LucasJadilo/ez8-hardware/docs/EZ8_Architecture.ods

Sheet: Instruction Set
Instruction Set
Data Transfer
Opcode | Mnemonic | Operand | Cycles | Description | Algorithm (C syntax)
0x00 | LDA | Memory address | 12 | Load accumulator from memory | A = *OP;
0x01 | LDI | Immediate data | 8 | Load accumulator from immediate | A = OP;
0x02 | STA | Memory address | 12 | Store accumulator to memory | *OP = A;
0x03 | LIA | None | 9 | Load indirect access | A = *A;
Logic
Opcode | Mnemonic | Operand | Cycles | Description | Algorithm (C syntax)
0x04 | NOT | None | 5 | Bitwise NOT | A = ~A;
0x05 | AND | Memory address | 13 | Bitwise AND | A = A & *OP;
0x06 | OR | Memory address | 13 | Bitwise OR | A = A | *OP;
0x07 | XOR | Memory address | 13 | Bitwise XOR | A = A ^ *OP;
0x08 | SHL | None | 5 | Logic left shift | A = A << 1;
0x09 | SHR | None | 5 | Logic right shift | A = A >> 1;
Arithmetic
Opcode | Mnemonic | Operand | Cycles | Description | Algorithm (C syntax)
0x0A | ADD | Memory address | 13 | Add memory to accumulator | A = A + *OP;
0x0B | SUB | Memory address | 13 | Subtract memory from accumulator | A = A - *OP;
0x0C | CMP | Memory address | 13 | Compare accumulator and memory | EQUAL = (A == *OP) ? 1 : 0;
 |  |  |  |  | COUT = (A <= *OP) ? 1 : 0;
Jump
Opcode | Mnemonic | Operand | Cycles | Description | Algorithm (C syntax)
0x0D | JMP | Memory address | 8 | Unconditional jump | PC = OP;
0x0E | JPE | Memory address | 8 (5) | Jump if accumulator is equal memory | PC = (EQUAL == 1) ? OP : PC;
0x0F | JPA | Memory address | 8 (5) | Jump if accumulator is above memory | PC = (EQUAL == 0 && COUT == 0) ? OP : PC;
0x10 | JPB | Memory address | 8 (5) | Jump if accumulator is below memory | PC = (EQUAL == 0 && COUT == 1) ? OP : PC;
0x11 | CALL | Memory address | 13 | Jump to subroutine | *SP = PC; SP--; PC = OP;
0x12 | RET | None | 9 | Return from subroutine | SP++; PC = *SP;
Stack
Opcode | Mnemonic | Operand | Cycles | Description | Algorithm (C syntax)
0x13 | LSP | None | 5 | Load stack pointer from accumulator | SP = A;
0x14 | PUSH | None | 8 | Push accumulator to stack | *SP = A; SP--;
0x15 | POP | None | 9 | Pop stack to accumulator | SP++; A = *SP;
I/O
Opcode | Mnemonic | Operand | Cycles | Description | Algorithm (C syntax)
0x16 | IN | I/O address | 12 | Read I/O data | A = *OP; /* (M/IO = 0) */
0x17 | OUT | I/O address | 12 | Write I/O data | *OP = A; /* (M/IO = 0) */
Idle
Opcode | Mnemonic | Operand | Cycles | Description | Algorithm (C syntax)
0x18 | NOP | None | 4 | No operation | ;
0x19 | HALT | None | 4 (∞) | Halt CPU | while(1);

Sheet: Bill of Materials
Bill of Materials
ACC | B | ALU | IR | PC | DAR | SP | BIU | CU | Total | Components
2 | 2 | 1 | 2 | - | 2 | - | 4 | - | 13 | IC 74LS173: 4-bit register with tristate outputs
1 | - | 2 | - | 2 | - | 1 | 1 | - | 7 | IC 74LS245: 8-bit bus transceiver with tristate outputs
- | - | 2 | - | - | - | - | - | - | 2 | IC 74LS181: 4-bit arithmetic logic unit
- | - | - | - | 2 | - | - | - | 1 | 3 | IC 74LS161: synchronous 4-bit binary counter
- | - | - | - | - | - | 2 | - | - | 2 | IC 74LS169: synchronous 4-bit up/down binary counter
- | - | - | - | - | - | - | - | 1 | 1 | IC 74LS04: hex inverting logic gates
- | - | - | - | - | - | - | - | 4 | 4 | IC 2732: 4KB EPROM
- | - | 1 | - | - | - | - | - | - | 1 | Resistor 10 kΩ

Sheet: ALU
ALU Inputs |  |  |  |  |  |  |  |  |  | ALU Outputs
Operation | Description | Inputs |  |  |  |  |  |  |  | Comparison | Outputs
(C syntax) |  | MODE | CIN | S3 | S2 | S1 | S0 | SHR | OE | Result | ALU_COUT | ALU_EQUAL
~A | Bitwise complement | 1 | X | 0 | 0 | 0 | 0 | 1 | 0 | A > B | 0 | 0
A & B | Bitwise logic AND | 1 | X | 1 | 0 | 1 | 1 | 1 | 0 | A = B | 1 | 1
A | B | Bitwise logic OR | 1 | X | 1 | 1 | 1 | 0 | 1 | 0 | A < B | 1 | 0
A ^ B | Bitwise logic XOR | 1 | X | 0 | 1 | 1 | 0 | 1 | 0
A + B | Arithmetic addition | 0 | 1 | 1 | 0 | 0 | 1 | 1 | 0
A - B | Arithmetic subtraction | 0 | 0 | 0 | 1 | 1 | 0 | 1 | 0
A << 1 | Left logic bit shift | 0 | 1 | 1 | 1 | 0 | 0 | 1 | 0
A >> 1 | Right logic bit shift | X | X | X | X | X | X | 0 | 1
A - B - 1 | Compare operands | 0 | 1 | 0 | 1 | 1 | 0 | 1 | 0

Sheet: Control Inputs
Control Inputs
Bit Index | Signal | Active Level | Description
Arithmetic Logic Unit
0 | COUT | L | ALU’s carry output (COUT output)
1 | EQUAL | H | ALU’s equal operands (EQUAL output)
Control Unit
2-5 | IC[0..3] | - | CU’s instruction counter
Instruction Register
6-10 | IR[0..4] | - | IR’s data (IREG[0..4] output)

Sheet: Control Outputs
Control Outputs
Bit Index | Signal | Active Level | Description
Accumulator
0 | AI | L | Accumulator’s data input enable (IE input)
1 | AO | L | Accumulator’s data output enable (OE input)
B Register
2 | BI | L | B Register’s data input enable (IE input)
Arithmetic Logic Unit
3 | RO | L | ALU’s result output enable (OE input)
4 | SHR | L | ALU’s right logic shift output enable (SHR input)
5 | S0 | H | ALU’s operation selection 0 (S0 input)
6 | S1 | H | ALU’s operation selection 1 (S1 input)
7 | S2 | H | ALU’s operation selection 2 (S2 input)
8 | S3 | H | ALU’s operation selection 3 (S3 input)
9 | CIN | L | ALU’s carry input (CIN input)
10 | MODE | H | ALU’s operation mode (MODE input)
Instruction Register
11 | IRI | L | IR’s data input enable (IE input)
Program Counter
12 | PCI | L | PC’s data input enable (IE input)
13 | PCDO | L | PC’s data output enable (DOE input)
14 | PCAO | L | PC’s address output enable (AOE input)
15 | PCCE | H | PC’s count enable (CE input)
Stack Pointer
16 | SPI | L | SP’s data input enable (IE input)
17 | SPO | L | SP’s data output enable (OE input)
18 | SPCE | L | SP’s count enable (CE input)
19 | SPU/SPD | H | SP’s counter direction (UP/DOWN input)
Data Address Register
20 | DARI | L | DAR’s data input enable (IE input)
21 | DARO | L | DAR’s address output enable (OE input)
Bus Interface Unit
22 | DI/DO | H | BIU’s data pins direction (DI/DO input)
23 | DEN | L | BIU’s data pins enable (DEN input)
24 | ACO | L | BIU’s address and control pins output enable (ACO input)
25 | ALE | L | BIU’s address pins latch enable (ALE input)
26 | M/IO | L | BIU’s memory/IO operation pin (M/IO_BUS input)
27 | RD | L | BIU’s read operation pin (RD_BUS input)
28 | WR | L | BIU’s write operation pin (WR_BUS input)
Control Unit
29 | ILC | L | CU’s instruction last cycle (ILC signal)

Sheet: Control Logic
Control Logic
Inputs |  |  |  | Active Outputs
IR[0..4] | IC[0..3] | EQUAL | COUT
Reset
X | 0 | X | X
Read Cycle
X | n | X | X | [M/IO], ACO, ALE, PCAO|DARO|SPO
X | n+1 | X | X | [M/IO], ACO, DEN, RD
X | n+2 | X | X | [M/IO], ACO, DEN, RD, AI|BI|IRI|DARI|PCI|SPI
X | n+3 | X | X | [M/IO], ACO, [PCCE], [ILC]
Write Cycle
X | n | X | X | [M/IO], ACO, DI/DO, ALE, PCAO|DARO|SPO
X | n+1 | X | X | [M/IO], ACO, DI/DO, DEN, WR, PCDO|AO
X | n+2 | X | X | [M/IO], ACO, DI/DO, DEN, PCDO|AO
X | n+3 | X | X | [M/IO], ACO, [SPCE], [SPU/SPD], [ILC]
Opcode Fetch
X | 1..4 | X | X | Read(PCAO, IRI, PCCE)
Execution LDA
0x00 | 5..8 | X | X | Read(PCAO, DARI, PCCE)
0x00 | 9..12 | X | X | Read(DARO, AI, ILC)
Execution LDI
0x01 | 5..8 | X | X | Read(PCAO, AI, PCCE, ILC)
Execution STA
0x02 | 5..8 | X | X | Read(PCAO, DARI, PCCE)
0x02 | 9..12 | X | X | Write(DARO, AO, ILC)
Execution LIA
0x03 | 5 | X | X | ACO, AO, DARI
0x03 | 6..9 | X | X | Read(DARO, AI, ILC)
Execution NOT
0x04 | 5 | X | X | ACO, MODE, RO, AI, ILC
Execution AND
0x05 | 5..8 | X | X | Read(PCAO, DARI, PCCE)
0x05 | 9..12 | X | X | Read(DARO, BI)
0x05 | 13 | X | X | ACO, MODE, S3, S1, S0, RO, AI, ILC
Execution OR
0x06 | 5..8 | X | X | Read(PCAO, DARI, PCCE)
0x06 | 9..12 | X | X | Read(DARO, BI)
0x06 | 13 | X | X | ACO, MODE, S3, S2, S1, RO, AI, ILC
Execution XOR
0x07 | 5..8 | X | X | Read(PCAO, DARI, PCCE)
0x07 | 9..12 | X | X | Read(DARO, BI)
0x07 | 13 | X | X | ACO, MODE, S2, S1, RO, AI, ILC
Execution SHL
0x08 | 5 | X | X | ACO, S3, S2, RO, AI, ILC
Execution SHR
0x09 | 5 | X | X | ACO, SHR, AI, ILC
Execution ADD
0x0A | 5..8 | X | X | Read(PCAO, DARI, PCCE)
0x0A | 9..12 | X | X | Read(DARO, BI)
0x0A | 13 | X | X | ACO, S3, S0, RO, AI, ILC
Execution SUB
0x0B | 5..8 | X | X | Read(PCAO, DARI, PCCE)
0x0B | 9..12 | X | X | Read(DARO, BI)
0x0B | 13 | X | X | ACO, CIN, S2, S1, RO, AI, ILC
Execution CMP
0x0C | 5..8 | X | X | Read(PCAO, DARI, PCCE)
0x0C | 9..12 | X | X | Read(DARO, BI)
0x0C | 13 | X | X | ACO, S2, S1, RO, ILC
Execution JMP
0x0D | 5..8 | X | X | Read(PCAO, PCI, ILC)
Execution JPE
0x0E | 5..8 | 1 | 1 | Read(PCAO, PCI, ILC)
0x0E | 5 | 0 | X | ACO, PCCE, ILC
0x0E | 5 | X | 0 | ACO, PCCE, ILC
Execution JPA
0x0F | 5..8 | 0 | 0 | Read(PCAO, PCI, ILC)
0x0F | 5 | 1 | X | ACO, PCCE, ILC
0x0F | 5 | X | 1 | ACO, PCCE, ILC
Execution JPB
0x10 | 5..8 | 0 | 1 | Read(PCAO, PCI, ILC)
0x10 | 5 | 1 | X | ACO, PCCE, ILC
0x10 | 5 | 0 | 0 | ACO, PCCE, ILC
Execution CALL
0x11 | 5 | X | X | ACO, PCDO, DARI, PCCE
0x11 | 6..9 | X | X | Write(SPO, PCDO, SPCE)
0x11 | 10..13 | X | X | Read(DARO, PCI, ILC)
Execution RET
0x12 | 5 | X | X | ACO, SPU/SPD, SPCE
0x12 | 6..9 | X | X | Read(SPO, PCI, ILC)
Execution LSP
0x13 | 5 | X | X | ACO, AO, SPI, ILC
Execution PUSH
0x14 | 5..8 | X | X | Write(SPO, AO, SPCE, ILC)
Execution POP
0x15 | 5 | X | X | ACO, SPU/SPD, SPCE
0x15 | 6..9 | X | X | Read(SPO, AI, ILC)
Execution IN
0x16 | 5..8 | X | X | Read(PCAO, DARI, PCCE)
0x16 | 9..12 | X | X | Read(M/IO, DARO, AI, ILC)
Execution OUT
0x17 | 5..8 | X | X | Read(PCAO, DARI, PCCE)
0x17 | 9..12 | X | X | Write(M/IO, DARO, AO, ILC)
Execution NOP
0x18 | 4 | X | X | ACO, PCCE, ILC
Execution HALT
0x19 | 1 | X | X | ACO, ILC
0x19 | 4 | X | X | ACO, ILC

Sheet: Control Truth Table
Control Truth Table
Inputs | Outputs | Mnemonic | IR | IC | EQUAL | COUT | ILC | WR | RD | M/IO | ALE | ACO | DEN | DI/DO | DARO | DARI | SPU/SPD | SPCE | SPO | SPI | PCCE | PCAO | PCDO | PCI | IRI | MODE | CIN | S3 | S2 | S1 | S0 | SHR | RO | BI | AO | AI
0x000 | 0x3FB77A1F | LDA | 0 | 0 | 0 | 0 | 1 | 1 | 1 | 1 | 1 | 1 | 1 | 0 | 1 | 1 | 0 | 1 | 1 | 1 | 0 | 1 | 1 | 1 | 1 | 0 | 1 | 0 | 0 | 0 | 0 | 1 | 1 | 1 | 1 | 1
0x001 | 0x3FB77A1F | LDA | 0 | 0 | 0 | 1 | 1 | 1 | 1 | 1 | 1 | 1 | 1 | 0 | 1 | 1 | 0 | 1 | 1 | 1 | 0 | 1 | 1 | 1 | 1 | 0 | 1 | 0 | 0 | 0 | 0 | 1 | 1 | 1 | 1 | 1
0x002 | 0x3FB77A1F | LDA | 0 | 0 | 1 | 0 | 1 | 1 | 1 | 1 | 1 | 1 | 1 | 0 | 1 | 1 | 0 | 1 | 1 | 1 | 0 | 1 | 1 | 1 | 1 | 0 | 1 | 0 | 0 | 0 | 0 | 1 | 1 | 1 | 1 | 1
0x003 | 0x3FB77A1F | LDA | 0 | 0 | 1 | 1 | 1 | 1 | 1 | 1 | 1 | 1 | 1 | 0 | 1 | 1 | 0 | 1 | 1 | 1 | 0 | 1 | 1 | 1 | 1 | 0 | 1 | 0 | 0 | 0 | 0 | 1 | 1 | 1 | 1 | 1
0x004 | 0x3CB73A1F | LDA | 0 | 1 | 0 | 0 | 1 | 1 | 1 | 1 | 0* | 0* | 1 | 0 | 1 | 1 | 0 | 1 | 1 | 1 | 0 | 0* | 1 | 1 | 1 | 0 | 1 | 0 | 0 | 0 | 0 | 1 | 1 | 1 | 1 | 1
0x005 | 0x3CB73A1F | LDA | 0 | 1 | 0 | 1 | 1 | 1 | 1 | 1 | 0* | 0* | 1 | 0 | 1 | 1 | 0 | 1 | 1 | 1 | 0 | 0* | 1 | 1 | 1 | 0 | 1 | 0 | 0 | 0 | 0 | 1 | 1 | 1 | 1 | 1
0x006 | 0x3CB73A1F | LDA | 0 | 1 | 1 | 0 | 1 | 1 | 1 | 1 | 0* | 0* | 1 | 0 | 1 | 1 | 0 | 1 | 1 | 1 | 0 | 0* | 1 | 1 | 1 | 0 | 1 | 0 | 0 | 0 | 0 | 1 | 1 | 1 | 1 | 1
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
0x2A2 | 0x3EB7FA1F | ADD | 10 | 8 | 1 | 0 | 1 | 1 | 1 | 1 | 1 | 0* | 1 | 0 | 1 | 1 | 0 | 1 | 1 | 1 | 1* | 1 | 1 | 1 | 1 | 0 | 1 | 0 | 0 | 0 | 0 | 1 | 1 | 1 | 1 | 1
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
