LucasJadilo/ez8-hardware/docs/EZ8_Instruction_Register.pdf

# ROOT

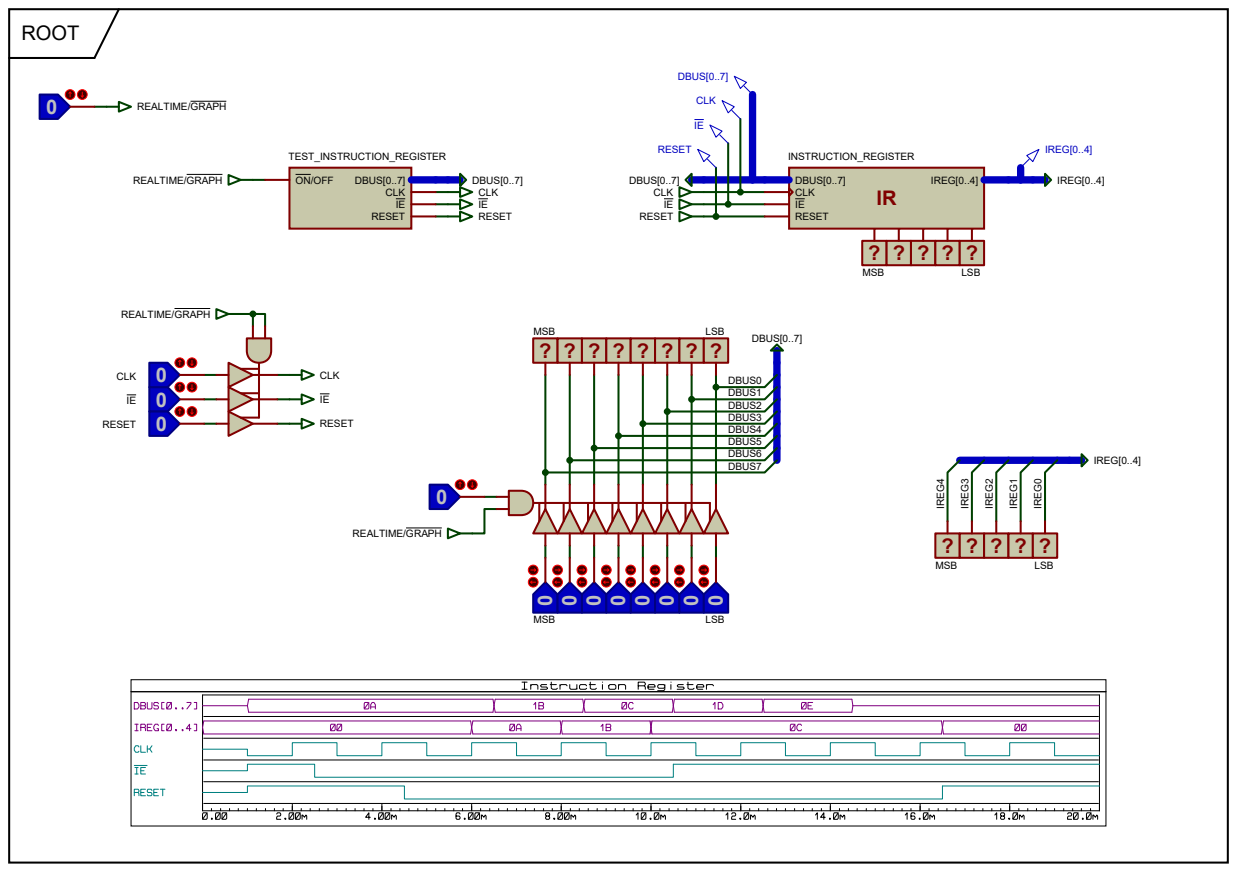
[picture p1: page 1]
DBUS7; DBUS6; DBUS5; DBUS4; DBUS3; DBUS2; DBUS1; DBUS0; IREG⁴; IREG³; IREG²; IREG¹; IREG⁰; CLK; REALTIME/GRAPH; 0 REALTIME/GRAPH; DBUS[0..7]; IREG[0..4]; MSB 0; LSB 0; MSB; LSB; RESET; ON/OFF; TEST_INSTRUCTION_REGISTER; IE RESET; INSTRUCTION_REGISTER

# INSTRUCTION_REGISTER

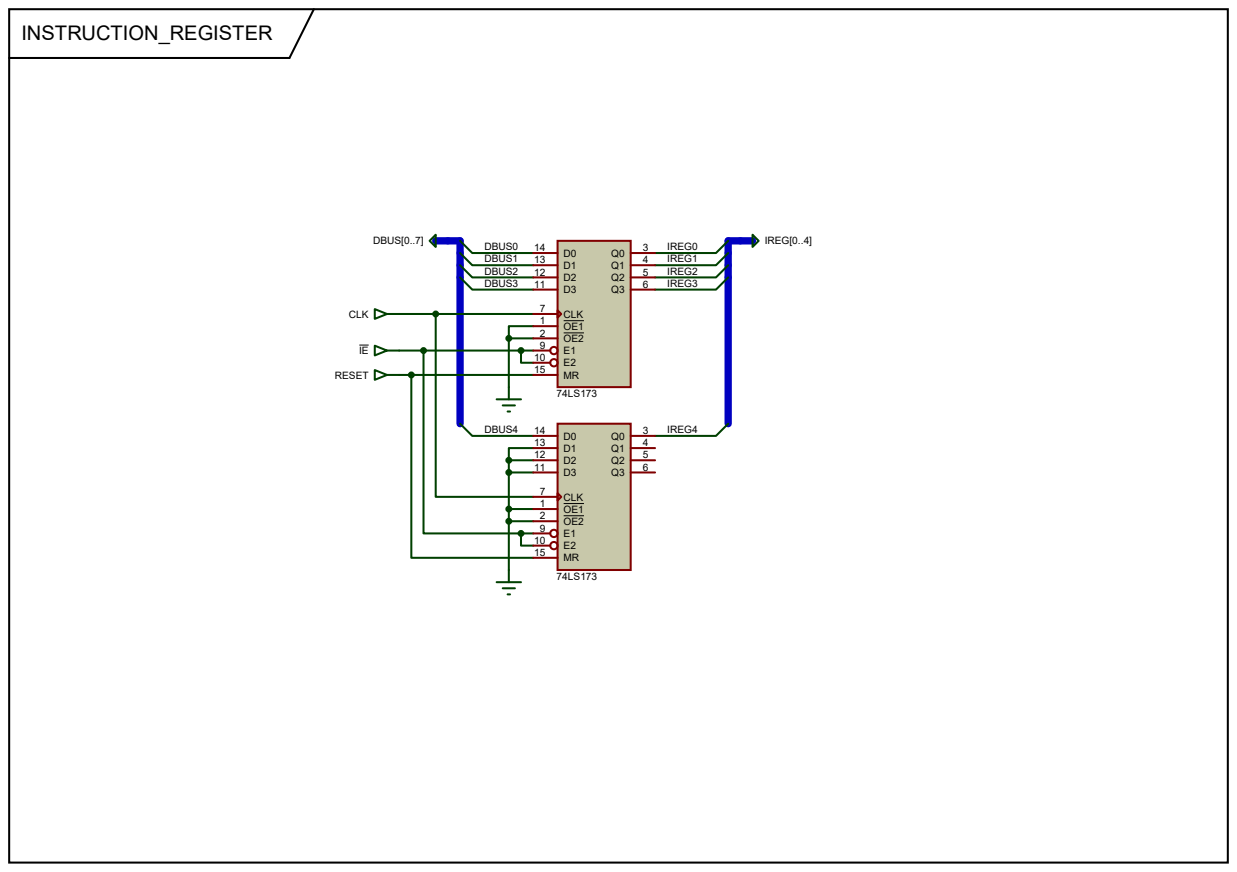
[picture p2: page 2]

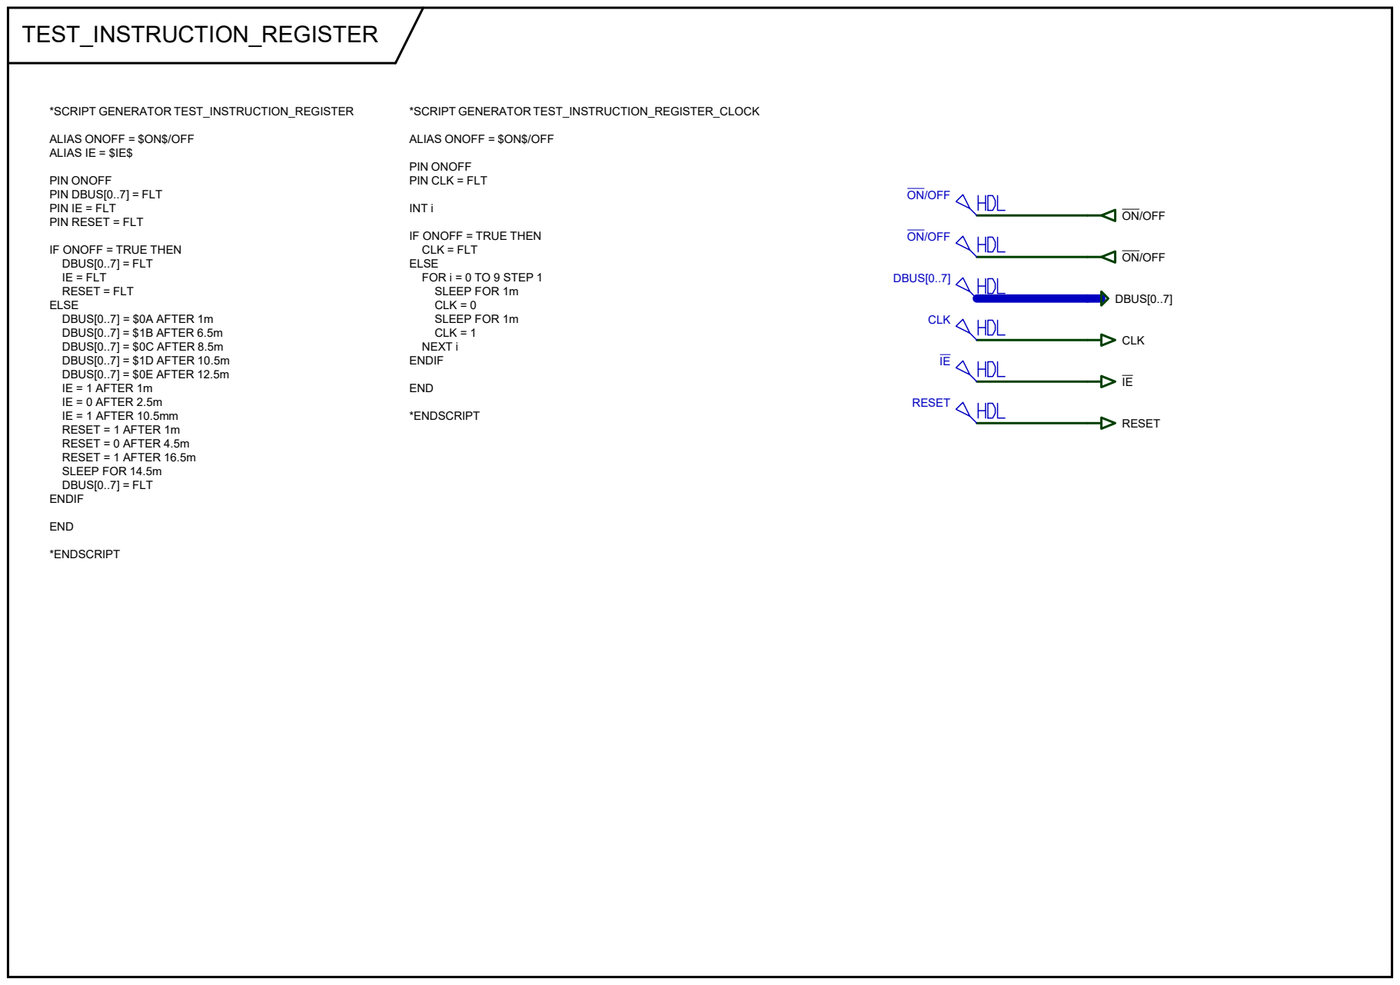
[picture p3: figure]
*SCRIPT GENERATOR TEST_INSTRUCTION_REGISTER; ALIAS ONOFF = $ON$/OFF ALIAS IE = $IE$; PIN ONOFF PIN DBUS[0..7] = FLT PIN IE = FLT PIN RESET = FLT; IF ONOFF = TRUE THEN DBUS[0..7] = FLT IE = FLT RESET = FLT ELSE DBUS[0..7] = $0A AFTER 1m DBUS[0..7] = $1B AFTER 6.5m DBUS[0..7] = $0C AFTER 8.5m DBUS[0..7] = $1D AFTER 10.5m DBUS[0..7] = $0E AFTER 12.5m IE = 1 AFTER 1m IE = 0 AFTER 2.5m IE = 1 AFTER 10.5mm RESET = 1 AFTER 1m RESET = 0 AFTER 4.5m RESET = 1 AFTER 16.5m SLEEP FOR 14.5m DBUS[0..7] = FLT ENDIF; END; *ENDSCRIPT; DBUS[0..7]; TEST_INSTRUCTION_REGISTER; CLK; RESET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
