LucasJadilo/ez8-hardware/docs/EZ8_Accumulator.pdf

# ROOT

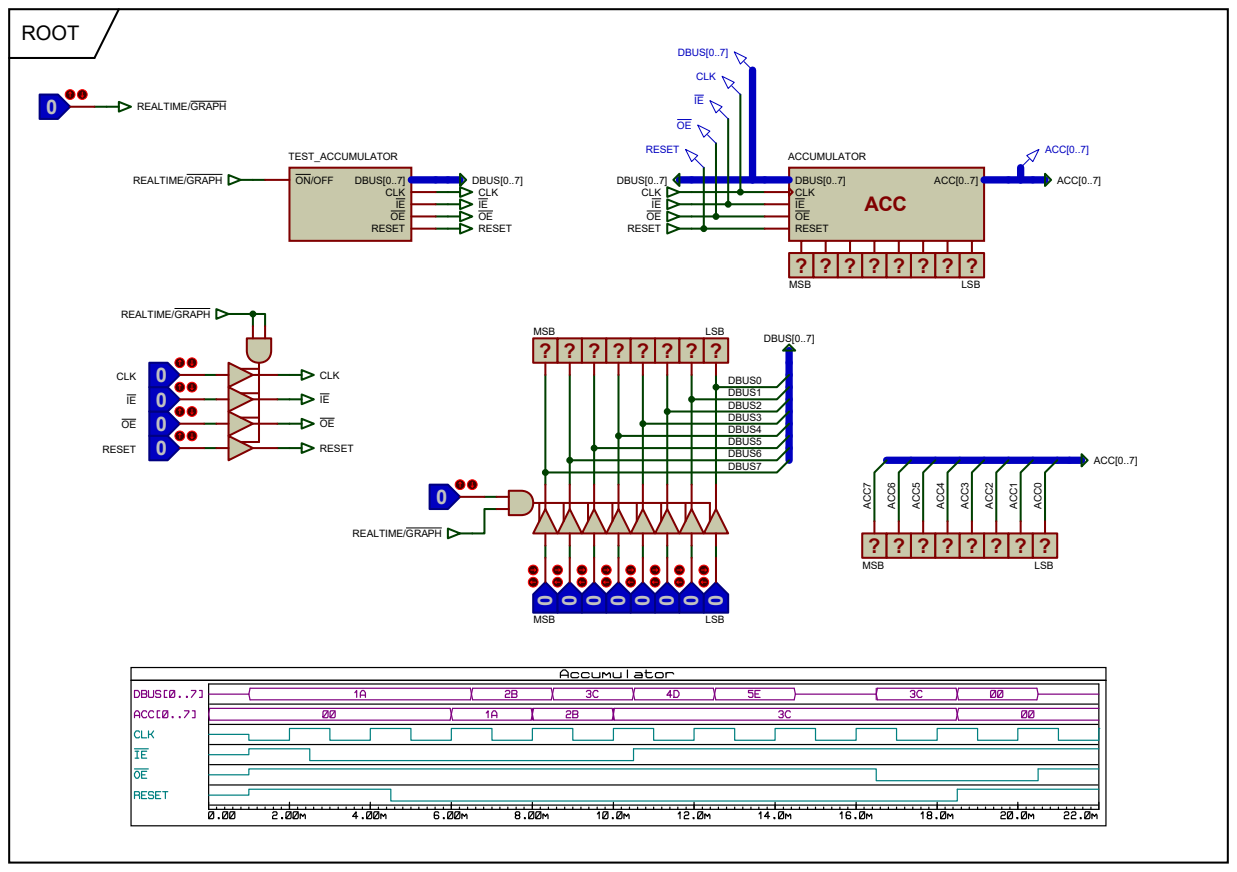
[picture p4: page 1]
DBUS7; DBUS6; DBUS5; DBUS4; DBUS3; DBUS2; DBUS1; DBUS0; ACC⁷; ACC⁶; ACC⁵; ACC⁴; ACC³; ACC²; ACC¹; ACC⁰; CLK; REALTIME/GRAPH; 0 REALTIME/GRAPH; DBUS[0..7]; ACC[0..7]; MSB 0; LSB 0; MSB; LSB; RESET; ACC; ACCUMULATOR; ON/OFF; TEST_ACCUMULATOR

# ACCUMULATOR

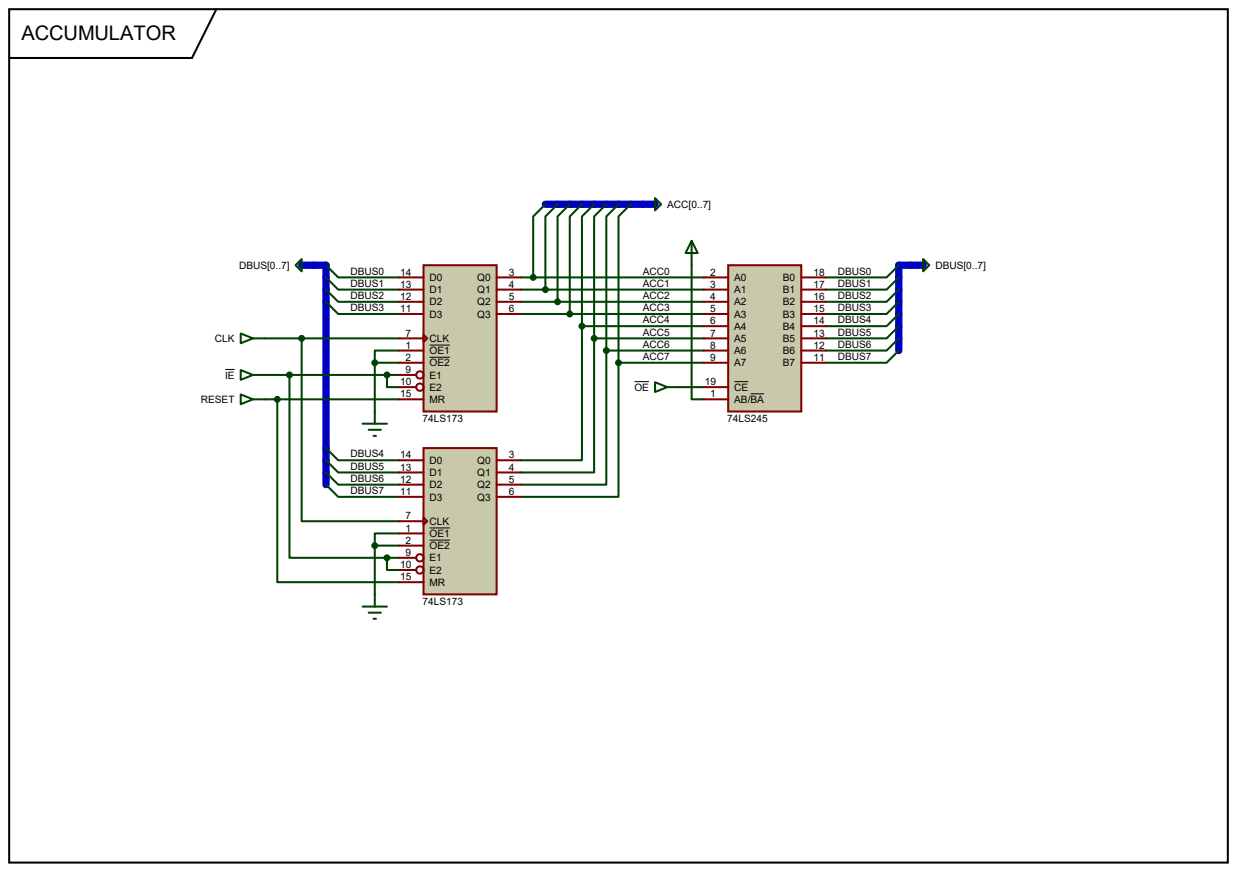
[picture p5: page 2]

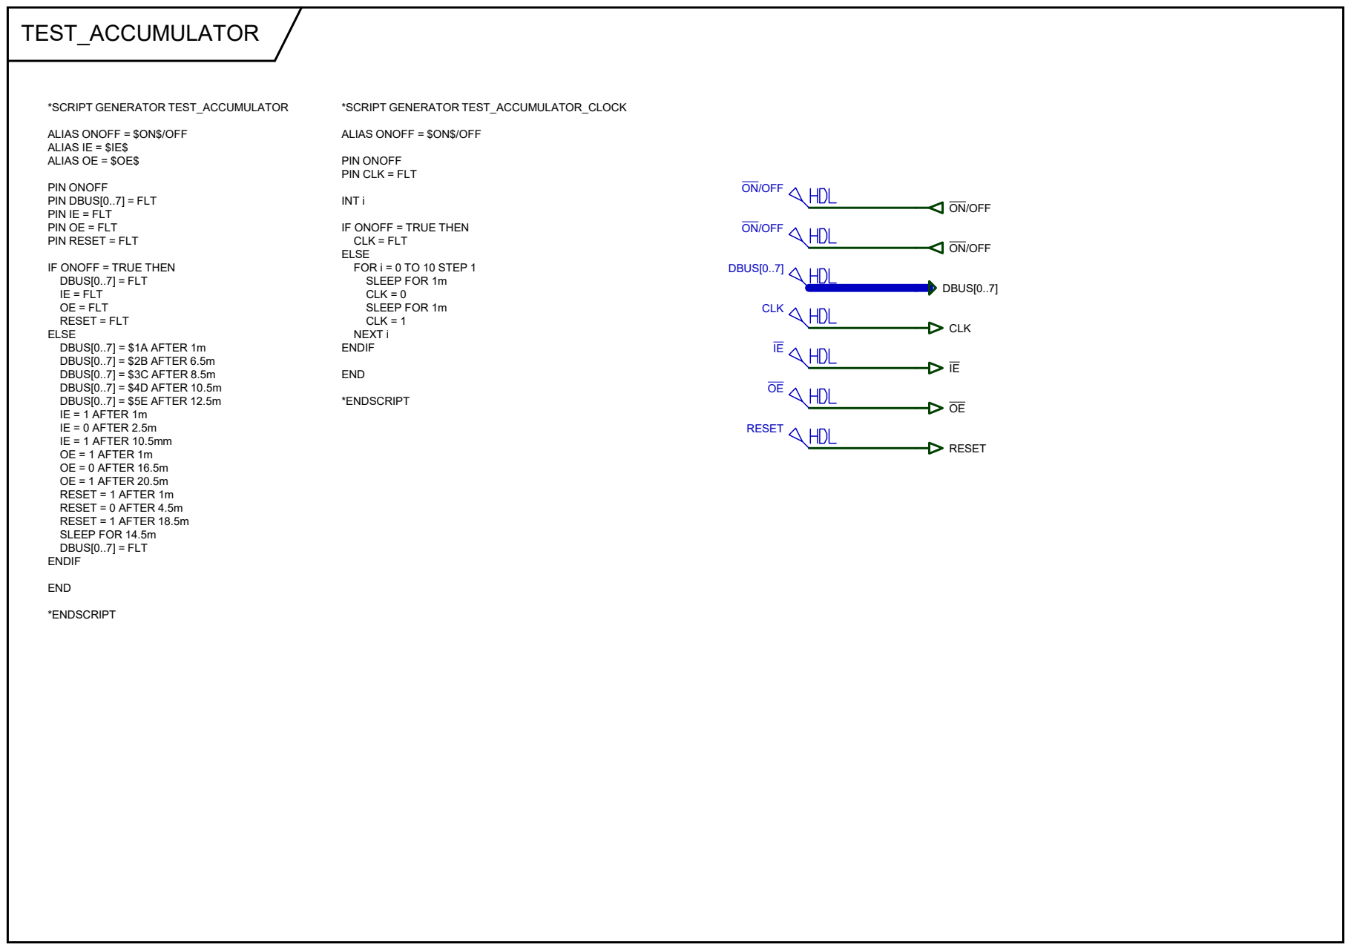
[picture p6: figure]
*SCRIPT GENERATOR TEST_ACCUMULATOR; ALIAS ONOFF = $ON$/OFF ALIAS IE = $IE$ ALIAS OE = $OE$; PIN ONOFF PIN DBUS[0..7] = FLT PIN IE = FLT PIN OE = FLT PIN RESET = FLT; IF ONOFF = TRUE THEN DBUS[0..7] = FLT IE = FLT OE = FLT RESET = FLT ELSE DBUS[0..7] = $1A AFTER 1m DBUS[0..7] = $2B AFTER 6.5m DBUS[0..7] = $3C AFTER 8.5m DBUS[0..7] = $4D AFTER 10.5m DBUS[0..7] = $5E AFTER 12.5m IE = 1 AFTER 1m IE = 0 AFTER 2.5m IE = 1 AFTER 10.5mm OE = 1 AFTER 1m OE = 0 AFTER 16.5m OE = 1 AFTER 20.5m RESET = 1 AFTER 1m RESET = 0 AFTER 4.5m RESET = 1 AFTER 18.5m SLEEP FOR 14.5m DBUS[0..7] = FLT ENDIF; END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
