LucasJadilo/ez8-hardware/docs/EZ8_Arithmetic_Logic_Unit.pdf

# ROOT

# ALU

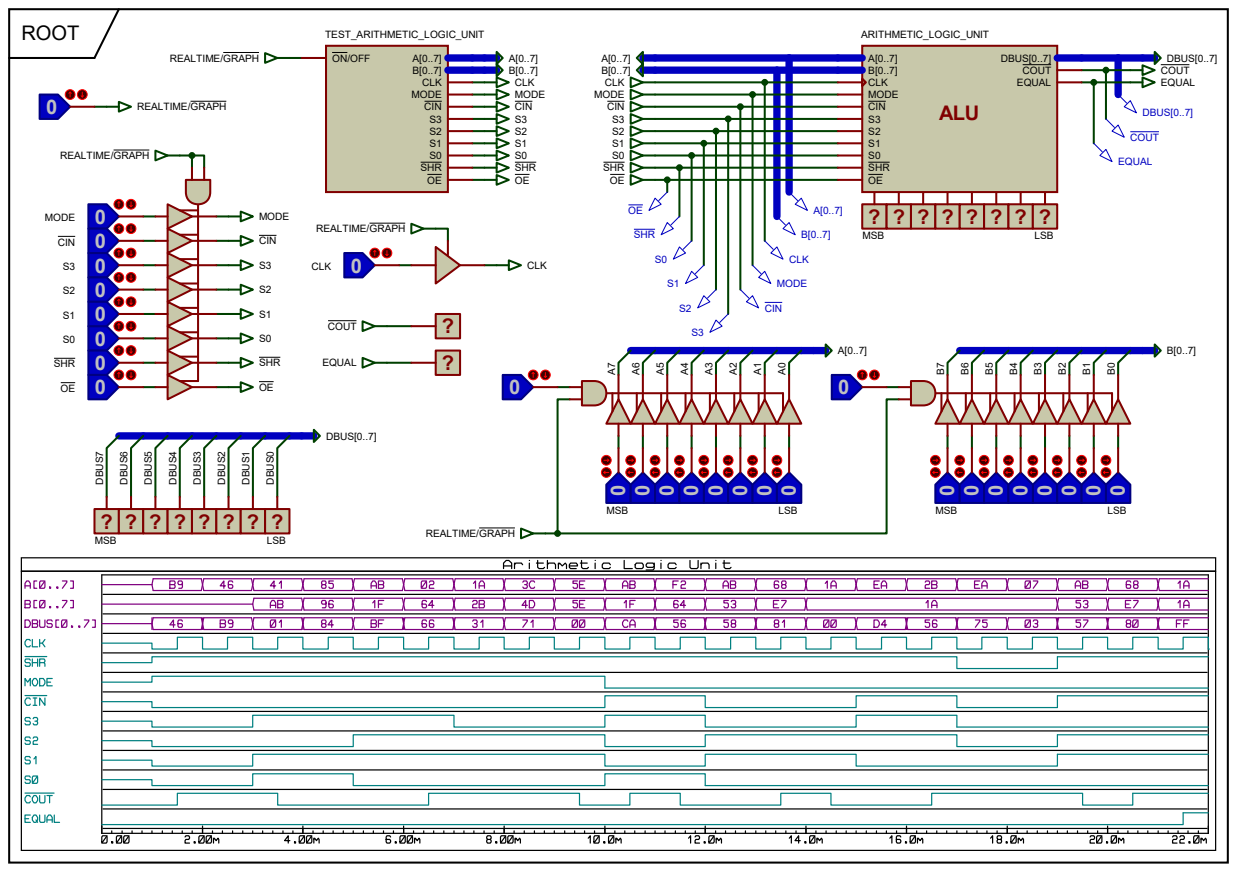
[picture p7: page 1]
DBUS7 DBUS6 DBUS5 DBUS4 DBUS3 DBUS2 DBUS1 DBUS0 A7A6A5A4A3A2A1A0B7B6B5B4B3B2B1B0; MODE; REALTIME/GRAPH; 0 REALTIME/GRAPH; DBUS[0..7]; MODE CIN S3 S2; CIN; COUT; EQUAL; SHR; MODE CIN S3 S2 S1 S0; MSB 0; LSB 0; MSB; LSB; CLK; COUT EQUAL; SHR OE; ARITHMETIC_LOGIC_UNIT; ON/OFF; MODE CIN; TEST_ARITHMETIC_LOGIC_UNIT

# ARITHMETIC_LOGIC_UNIT

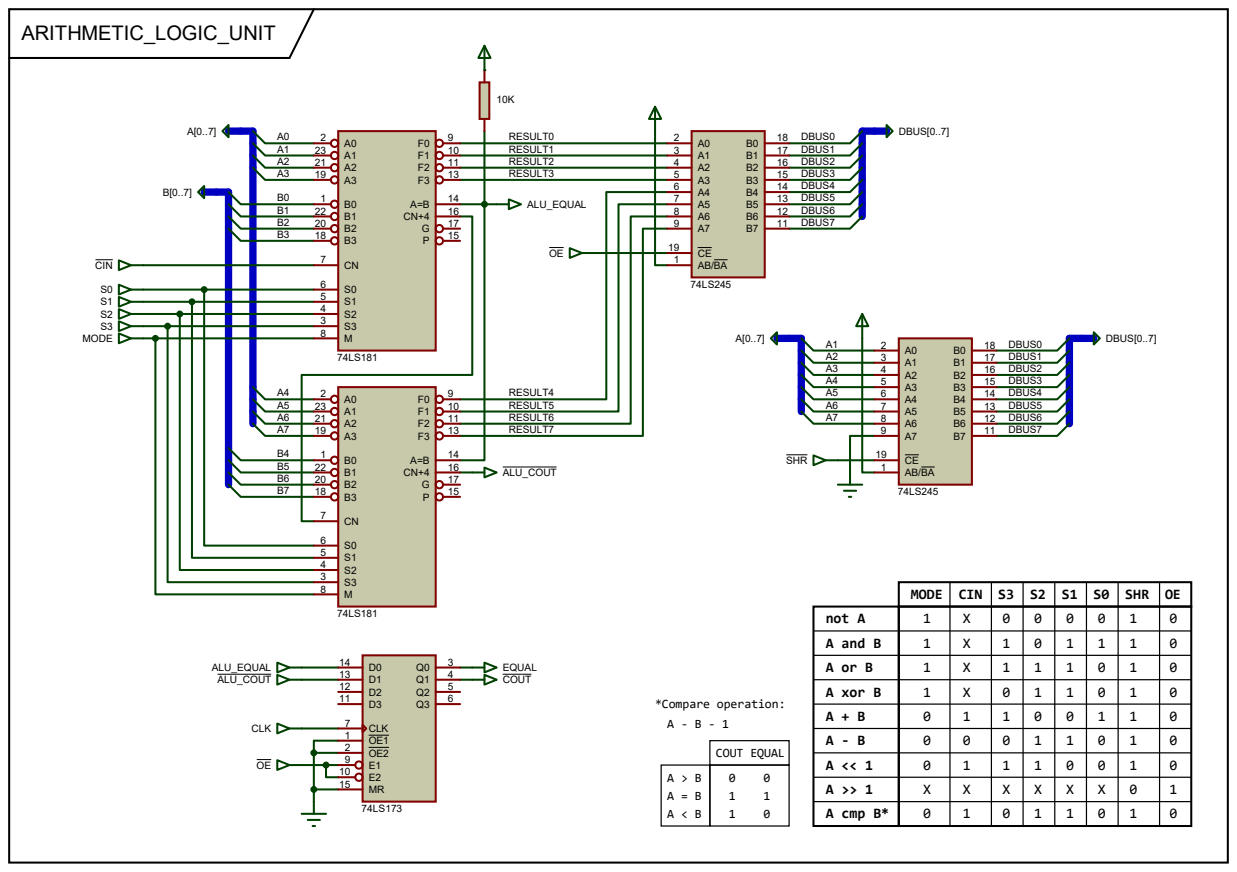
[picture p8: page 2]

# TEST_ARITHMETIC_LOGIC_UNIT

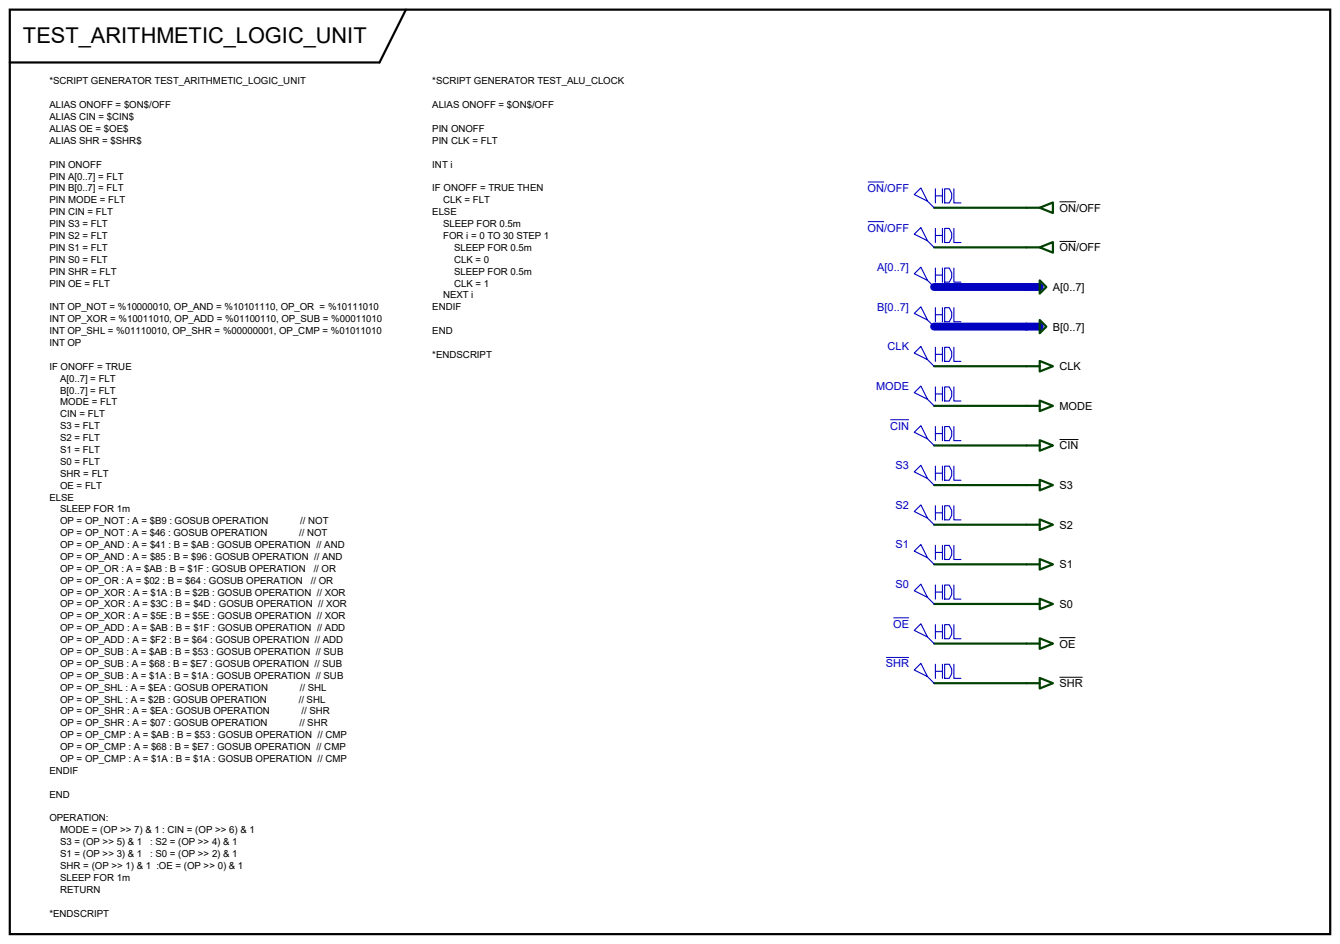
[picture p9: page 3]
*SCRIPT GENERATOR TEST_ARITHMETIC_LOGIC_UNIT; INT OP_NOT = %10000010, OP_AND = %10101110, OP_OR = %10111010 INT OP_XOR = %10011010, OP_ADD = %01100110, OP_SUB = %00011010 INT OP_SHL = %01110010, OP_SHR = %00000001, OP_CMP = %01011010 INT OP; OP = OP_NOT : A = $B9 : GOSUB OPERATION; // NOT; OP = OP_NOT : A = $46 : GOSUB OPERATION; OP = OP_SHL : A = $EA : GOSUB OPERATION; // SHL; OP = OP_SHL : A = $2B : GOSUB OPERATION; OP = OP_SHR : A = $EA : GOSUB OPERATION; // SHR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

ALIAS ONOFF = $ON$/OFF
ALIAS CIN = $CIN$
ALIAS OE = $OE$
ALIAS SHR = $SHR$

PIN ONOFF
PIN CLK = FLT

PIN A[0..7] = FLT
PIN B[0..7] = FLT
PIN MODE = FLT
PIN CIN = FLT
PIN S3 = FLT
PIN S2 = FLT
PIN S1 = FLT
PIN S0 = FLT
PIN SHR = FLT
PIN OE = FLT

IF ONOFF = TRUE THEN
CLK = FLT
ELSE
SLEEP FOR 0.5m
FOR i = 0 TO 30 STEP 1
CLK = 0
CLK = 1
NEXT i
ENDIF

IF ONOFF = TRUE
A[0..7] = FLT
B[0..7] = FLT
MODE = FLT
CIN = FLT
S3 = FLT
S2 = FLT
S1 = FLT
S0 = FLT
SHR = FLT
OE = FLT
SLEEP FOR 1m
OP = OP_AND : A = $41 : B = $AB : GOSUB OPERATION // AND
OP = OP_AND : A = $85 : B = $96 : GOSUB OPERATION // AND
OP = OP_OR : A = $AB : B = $1F : GOSUB OPERATION // OR
OP = OP_OR : A = $02 : B = $64 : GOSUB OPERATION // OR
OP = OP_XOR : A = $1A : B = $2B : GOSUB OPERATION // XOR
OP = OP_XOR : A = $3C : B = $4D : GOSUB OPERATION // XOR
OP = OP_XOR : A = $5E : B = $5E : GOSUB OPERATION // XOR
OP = OP_ADD : A = $AB : B = $1F : GOSUB OPERATION // ADD
OP = OP_ADD : A = $F2 : B = $64 : GOSUB OPERATION // ADD
OP = OP_SUB : A = $AB : B = $53 : GOSUB OPERATION // SUB
OP = OP_SUB : A = $68 : B = $E7 : GOSUB OPERATION // SUB
OP = OP_SUB : A = $1A : B = $1A : GOSUB OPERATION // SUB
OP = OP_CMP : A = $AB : B = $53 : GOSUB OPERATION // CMP
OP = OP_CMP : A = $68 : B = $E7 : GOSUB OPERATION // CMP
OP = OP_CMP : A = $1A : B = $1A : GOSUB OPERATION // CMP

OPERATION:
MODE = (OP >> 7) & 1 : CIN = (OP >> 6) & 1
SHR = (OP >> 1) & 1 :OE = (OP >> 0) & 1
RETURN
