LucasJadilo/ez8-hardware/docs/EZ8_B_Register.pdf

# ROOT

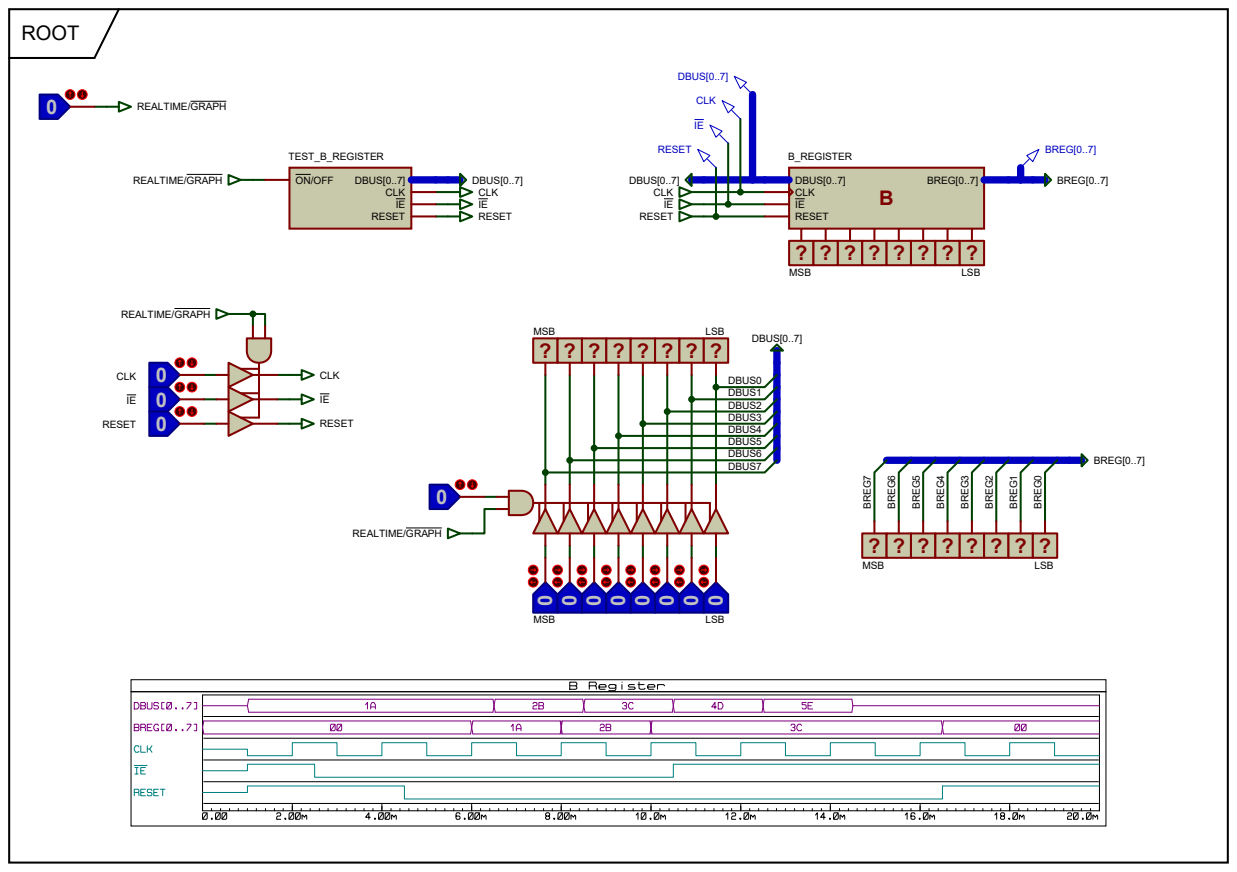
[picture p10: page 1]
DBUS7; DBUS6; DBUS5; DBUS4; DBUS3; DBUS2; DBUS1; DBUS0; BREG⁷; BREG⁶; BREG⁵; BREG⁴; BREG³; BREG²; BREG¹; BREG⁰; CLK; REALTIME/GRAPH; 0 REALTIME/GRAPH; DBUS[0..7]; BREG[0..7]; MSB 0; LSB 0; MSB; LSB; RESET; IE RESET; B_REGISTER; ON/OFF; TEST_B_REGISTER

# B_REGISTER

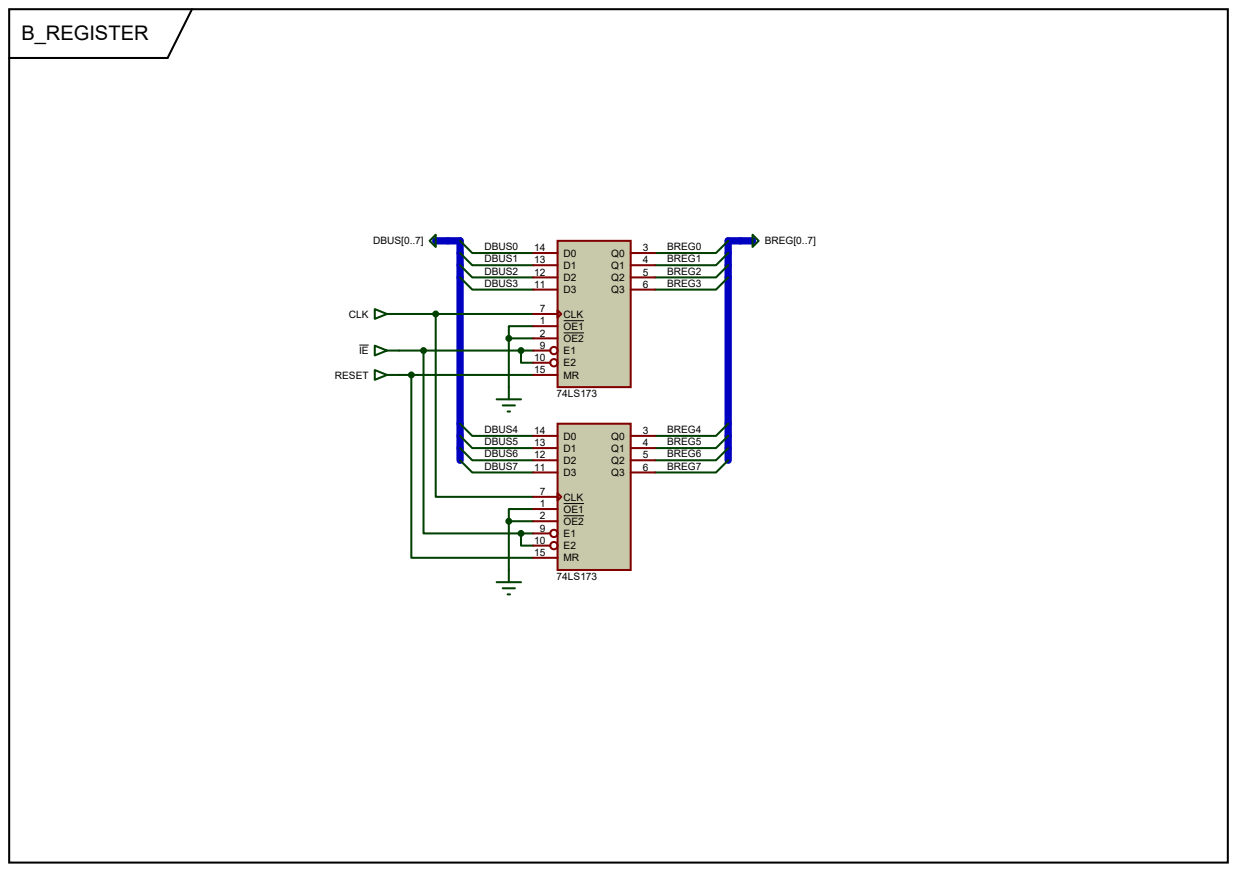
[picture p11: page 2]

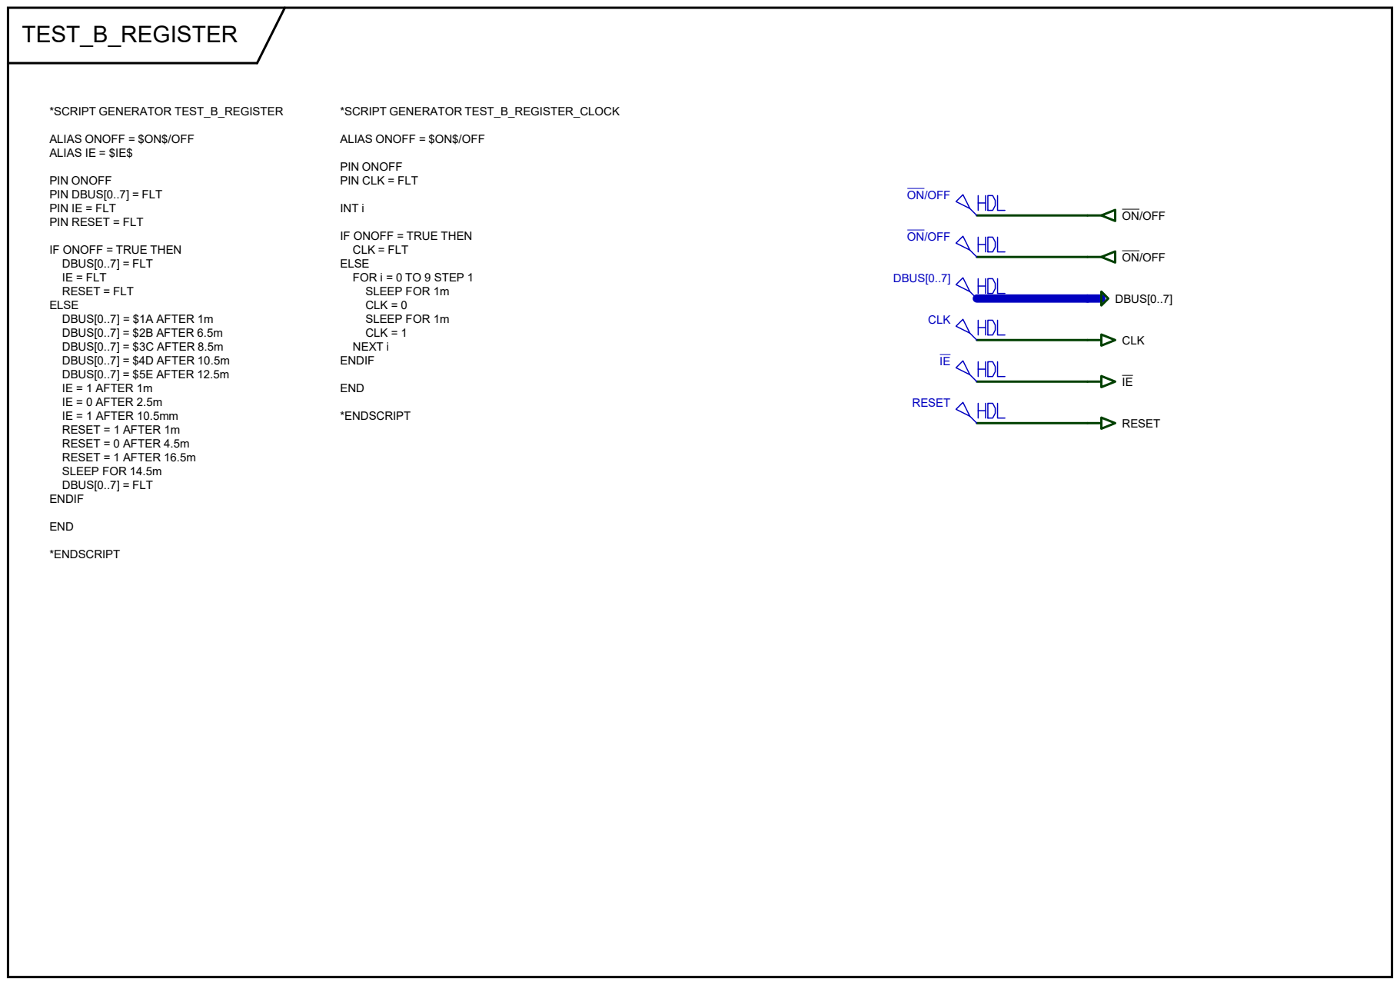
[picture p12: figure]
*SCRIPT GENERATOR TEST_B_REGISTER; ALIAS ONOFF = $ON$/OFF ALIAS IE = $IE$; PIN ONOFF PIN DBUS[0..7] = FLT PIN IE = FLT PIN RESET = FLT; IF ONOFF = TRUE THEN DBUS[0..7] = FLT IE = FLT RESET = FLT ELSE DBUS[0..7] = $1A AFTER 1m DBUS[0..7] = $2B AFTER 6.5m DBUS[0..7] = $3C AFTER 8.5m DBUS[0..7] = $4D AFTER 10.5m DBUS[0..7] = $5E AFTER 12.5m IE = 1 AFTER 1m IE = 0 AFTER 2.5m IE = 1 AFTER 10.5mm RESET = 1 AFTER 1m RESET = 0 AFTER 4.5m RESET = 1 AFTER 16.5m SLEEP FOR 14.5m DBUS[0..7] = FLT ENDIF; END; *ENDSCRIPT; DBUS[0..7]; TEST_B_REGISTER; CLK; RESET; *SCRIPT GENERATOR TEST_B_REGISTER_CLOCK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
