LucasJadilo/ez8-hardware/docs/EZ8_Bus_Interface_Unit.pdf

# ROOT

?

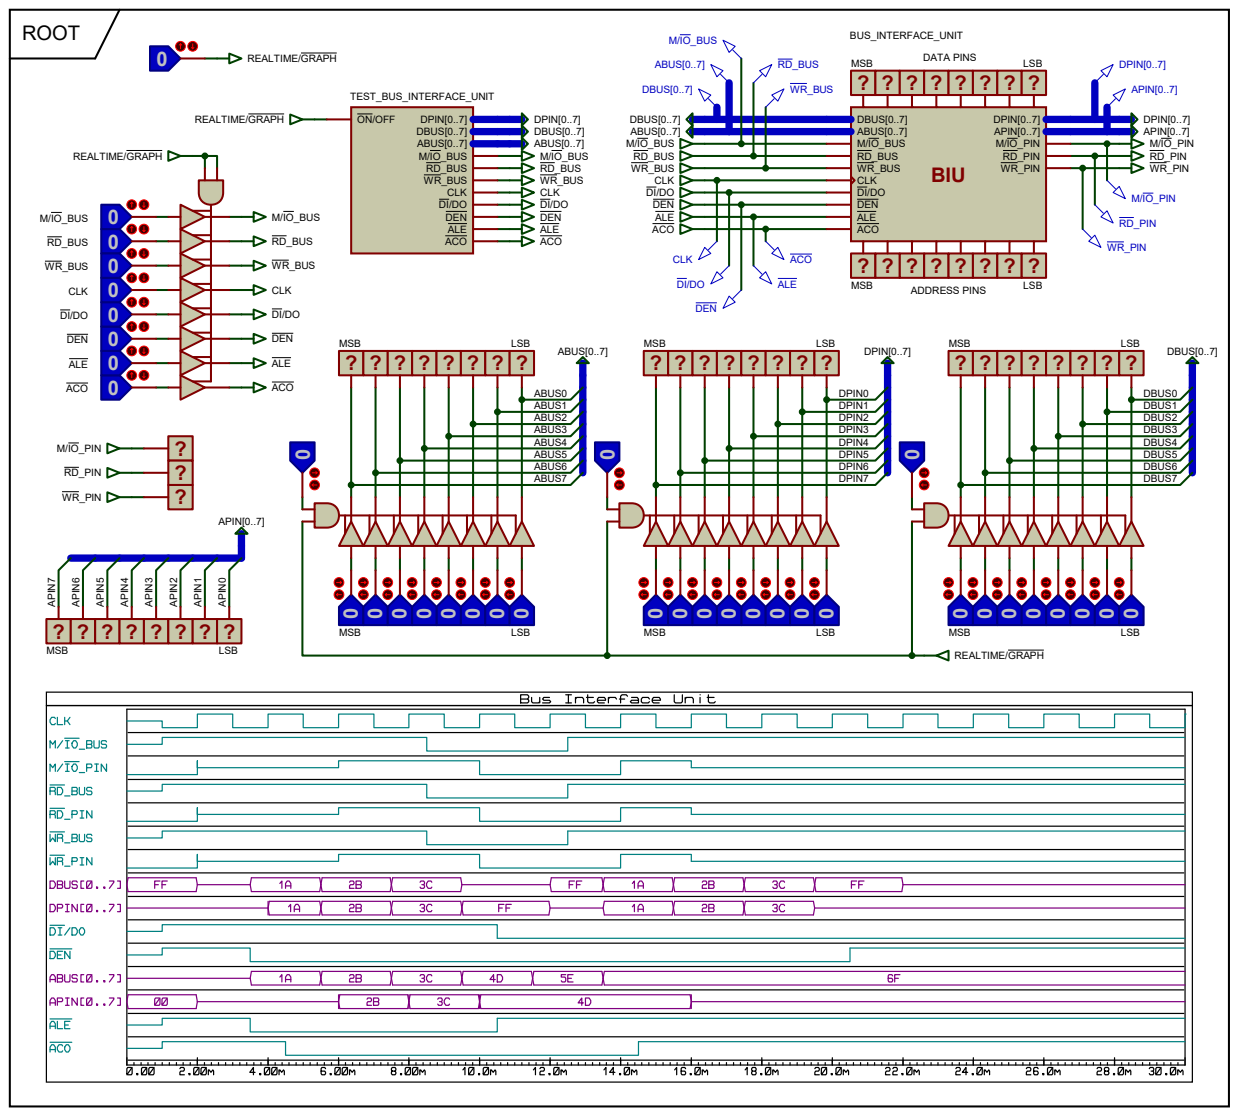
[picture p13: page 1]
DPIN7; DPIN6; DPIN5; DPIN4; DPIN3; DPIN2; DPIN1; DPIN0; ABUS7; ABUS6; ABUS5; ABUS4; ABUS3; ABUS2; ABUS1; ABUS0; DBUS7; DBUS6; DBUS5; DBUS4; DBUS3; DBUS2; DBUS1; DBUS0 APIN⁷; APIN⁶; APIN⁵; APIN⁴; APIN³; APIN²; APIN¹; APIN⁰; APIN[0..7]; DEN; DPIN[0..7]; REALTIME/GRAPH; 0 REALTIME/GRAPH; DBUS[0..7]; ABUS[0..7]; M/IO_BUS RD_BUS WR_BUS CLK; CLK; ALE; ACO; MSB 0; LSB 0; MSB; LSB; DPIN[0..7] DBUS[0..7] ABUS[0..7]; DI/DO DEN ALE ACO; WR_BUS; RD_BUS; M/IO_BUS; M/IO_PIN RD_PIN WR_PIN BIU; DI/DO DEN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

# BUS_INTERFACE_UNIT

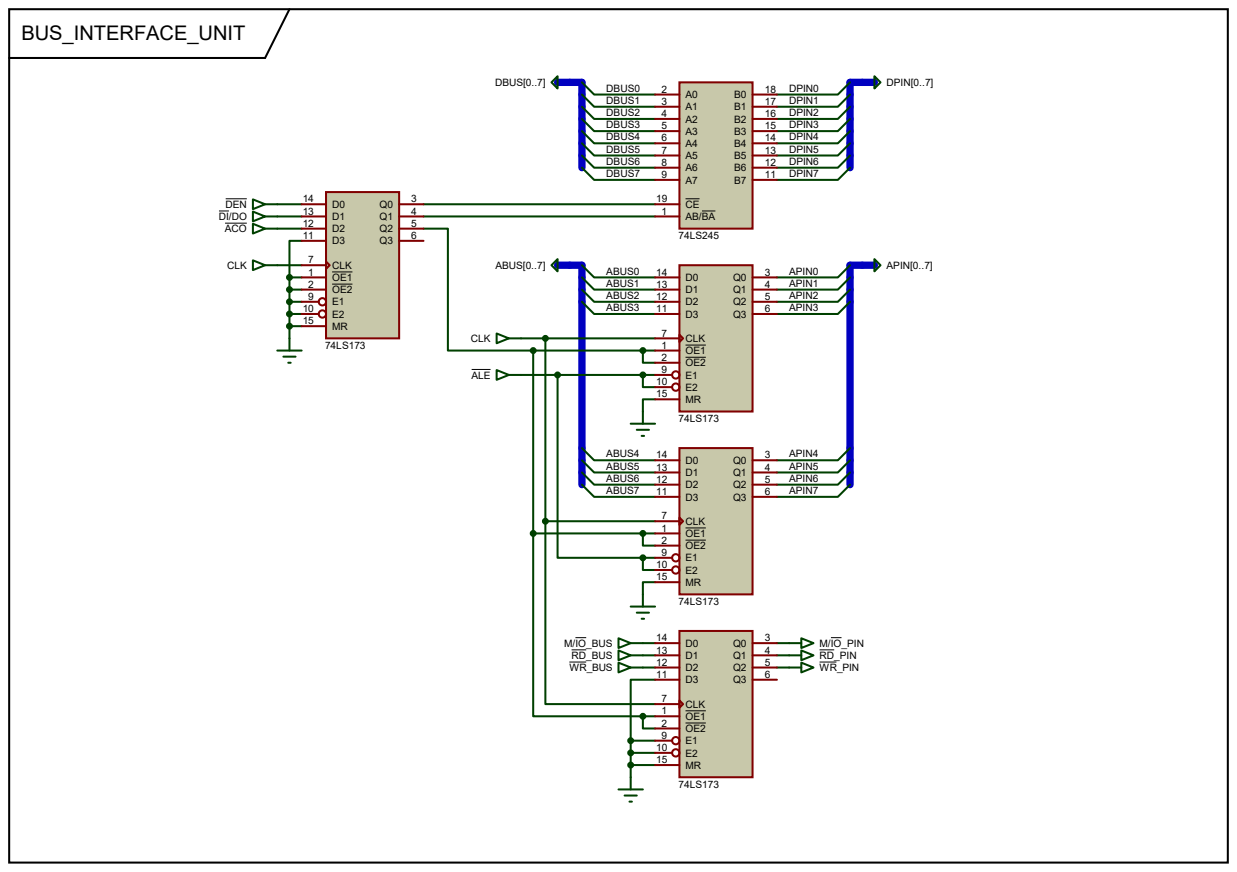
[picture p14: page 2]

# TEST_BUS_INTERFACE_UNIT

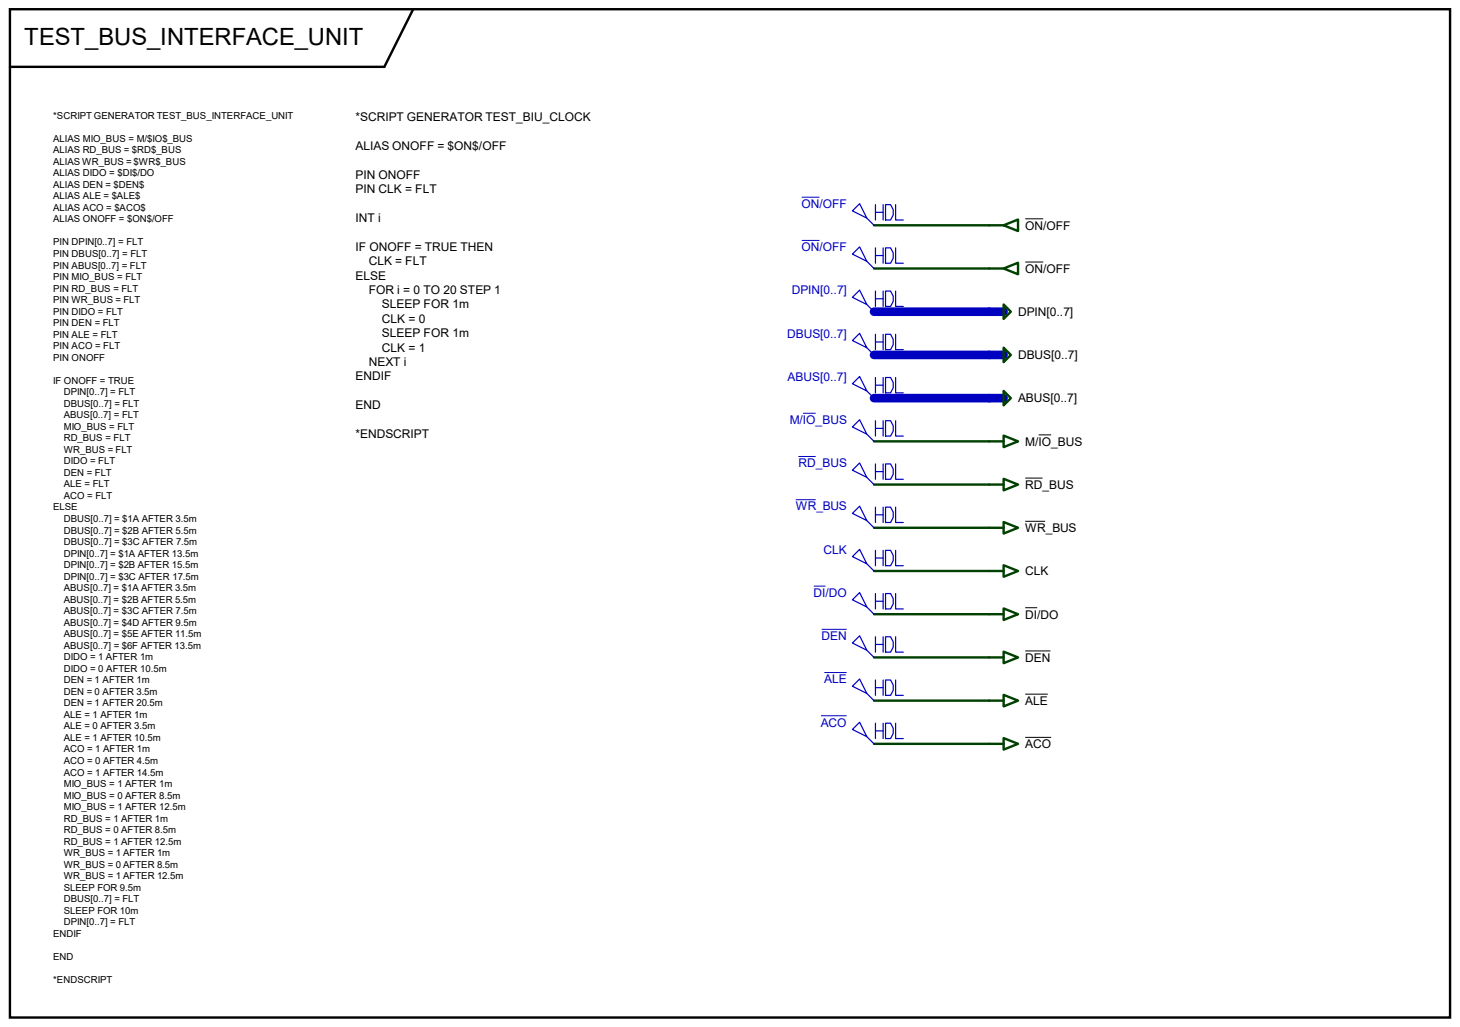
[picture p15: page 3]
*SCRIPT GENERATOR TEST_BUS_INTERFACE_UNIT; END; *ENDSCRIPT; DEN; ON/OFF; DPIN[0..7]; DBUS[0..7]; ABUS[0..7]; ACO; ALE; *SCRIPT GENERATOR TEST_BIU_CLOCK; INT i; RD_BUS; M/IO_BUS; WR_BUS; CLK

ALIAS MIO_BUS = M/$IO$_BUS
ALIAS RD_BUS = $RD$_BUS
ALIAS WR_BUS = $WR$_BUS
ALIAS DIDO = $DI$/DO
ALIAS DEN = $DEN$
ALIAS ALE = $ALE$
ALIAS ACO = $ACO$
ALIAS ONOFF = $ON$/OFF

PIN ONOFF
PIN CLK = FLT

PIN DPIN[0..7] = FLT
PIN DBUS[0..7] = FLT
PIN ABUS[0..7] = FLT
PIN MIO_BUS = FLT
PIN RD_BUS = FLT
PIN WR_BUS = FLT
PIN DIDO = FLT
PIN DEN = FLT
PIN ALE = FLT
PIN ACO = FLT

IF ONOFF = TRUE THEN
CLK = FLT
ELSE
FOR i = 0 TO 20 STEP 1
SLEEP FOR 1m
CLK = 0
CLK = 1
NEXT i
ENDIF

IF ONOFF = TRUE
DPIN[0..7] = FLT
DBUS[0..7] = FLT
ABUS[0..7] = FLT
MIO_BUS = FLT
RD_BUS = FLT
WR_BUS = FLT
DIDO = FLT
DEN = FLT
ALE = FLT
ACO = FLT
DBUS[0..7] = $1A AFTER 3.5m
DBUS[0..7] = $2B AFTER 5.5m
DBUS[0..7] = $3C AFTER 7.5m
DPIN[0..7] = $1A AFTER 13.5m
DPIN[0..7] = $2B AFTER 15.5m
DPIN[0..7] = $3C AFTER 17.5m
ABUS[0..7] = $1A AFTER 3.5m
ABUS[0..7] = $2B AFTER 5.5m
ABUS[0..7] = $3C AFTER 7.5m
ABUS[0..7] = $4D AFTER 9.5m
ABUS[0..7] = $5E AFTER 11.5m
ABUS[0..7] = $6F AFTER 13.5m
DIDO = 1 AFTER 1m
DIDO = 0 AFTER 10.5m
DEN = 1 AFTER 1m
DEN = 0 AFTER 3.5m
DEN = 1 AFTER 20.5m
ALE = 1 AFTER 1m
ALE = 0 AFTER 3.5m
ALE = 1 AFTER 10.5m
ACO = 1 AFTER 1m
ACO = 0 AFTER 4.5m
ACO = 1 AFTER 14.5m
MIO_BUS = 1 AFTER 1m
MIO_BUS = 0 AFTER 8.5m
MIO_BUS = 1 AFTER 12.5m
RD_BUS = 1 AFTER 1m
RD_BUS = 0 AFTER 8.5m
RD_BUS = 1 AFTER 12.5m
WR_BUS = 1 AFTER 1m
WR_BUS = 0 AFTER 8.5m
WR_BUS = 1 AFTER 12.5m
SLEEP FOR 9.5m
SLEEP FOR 10m
