LucasJadilo/ez8-hardware/docs/EZ8_Data_Address_Register.pdf

# ROOT

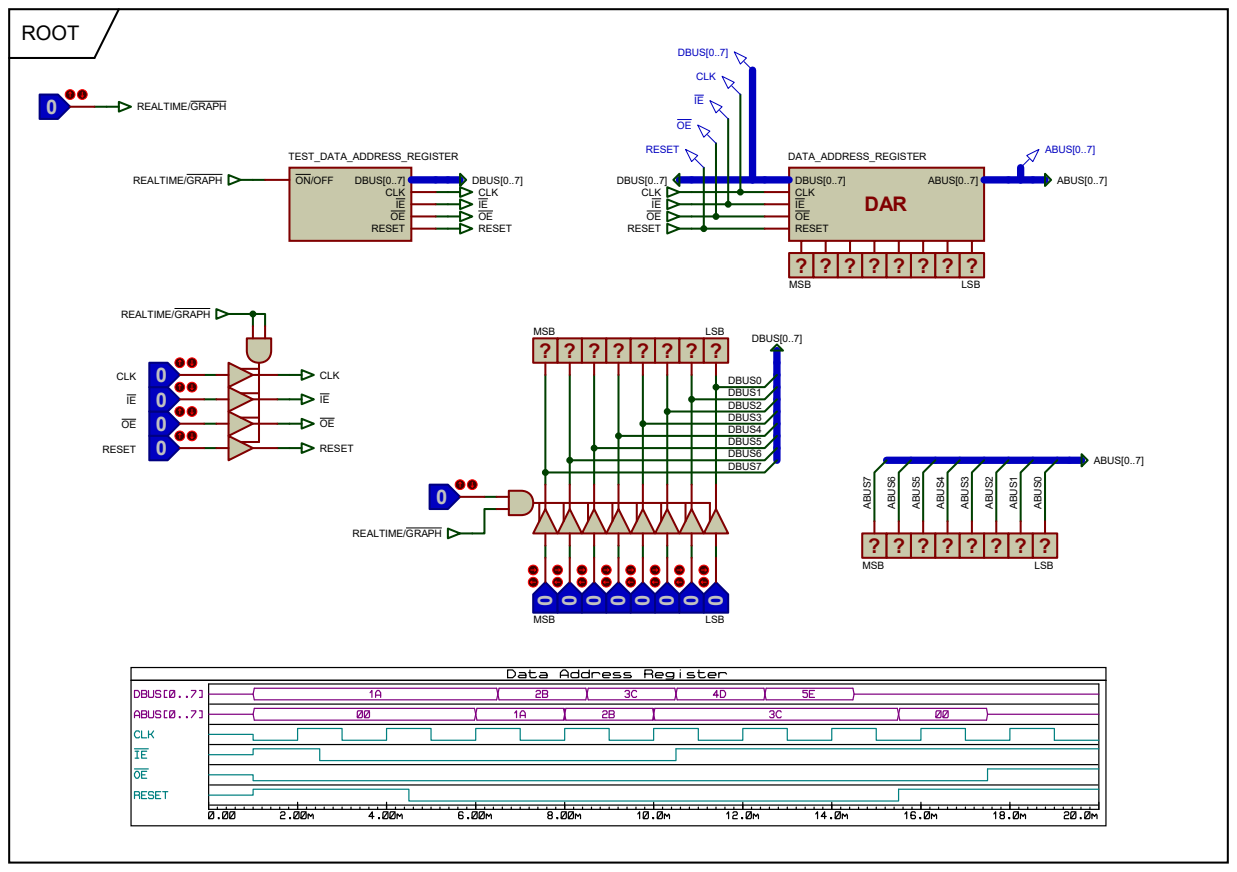
[picture p16: page 1]
DBUS7; DBUS6; DBUS5; DBUS4; DBUS3; DBUS2; DBUS1; DBUS0; ABUS⁷; ABUS⁶; ABUS⁵; ABUS⁴; ABUS³; ABUS²; ABUS¹; ABUS⁰; CLK; REALTIME/GRAPH; 0 REALTIME/GRAPH; DBUS[0..7]; ABUS[0..7]; MSB 0; LSB 0; MSB; LSB; RESET; DAR; DATA_ADDRESS_REGISTER; ON/OFF; TEST_DATA_ADDRESS_REGISTER

# DATA_ADDRESS_REGISTER

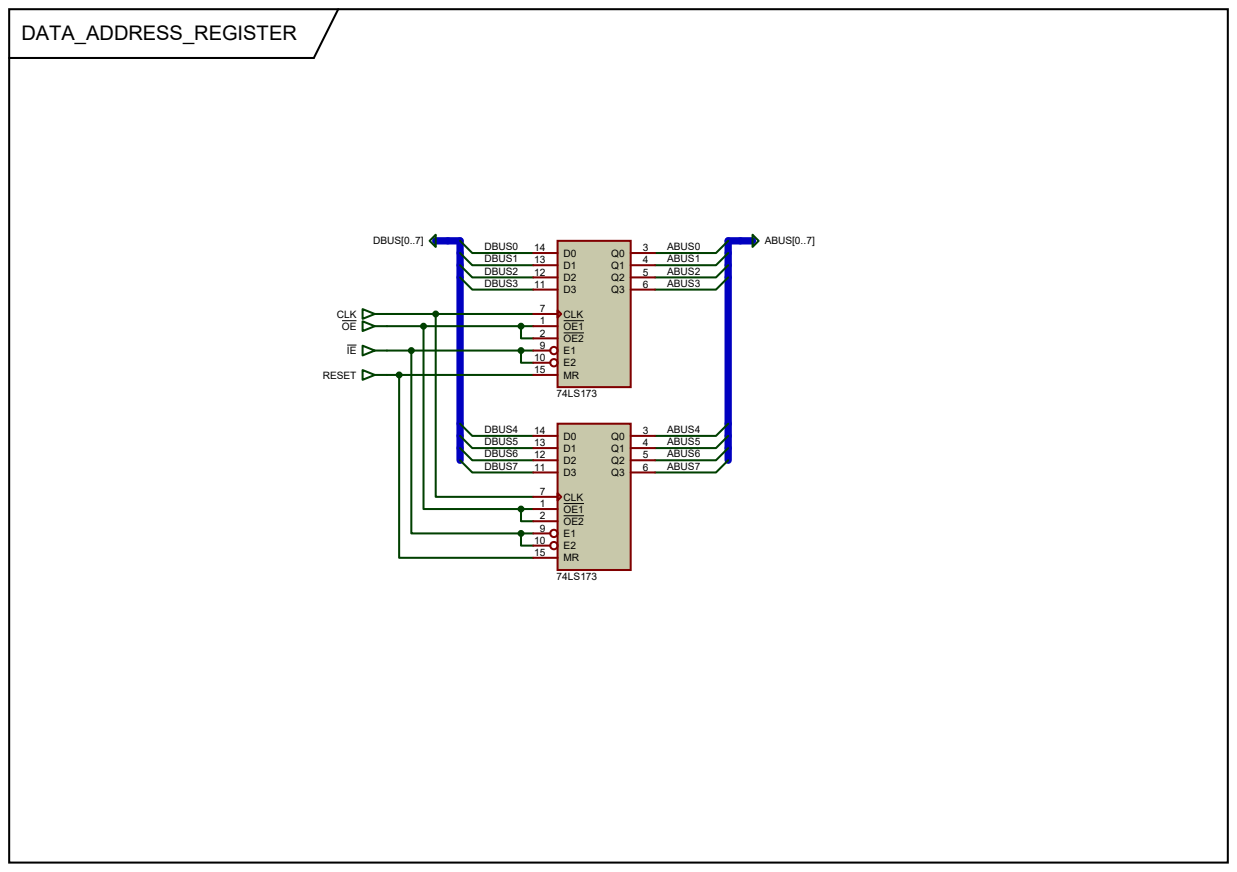
[picture p17: page 2]

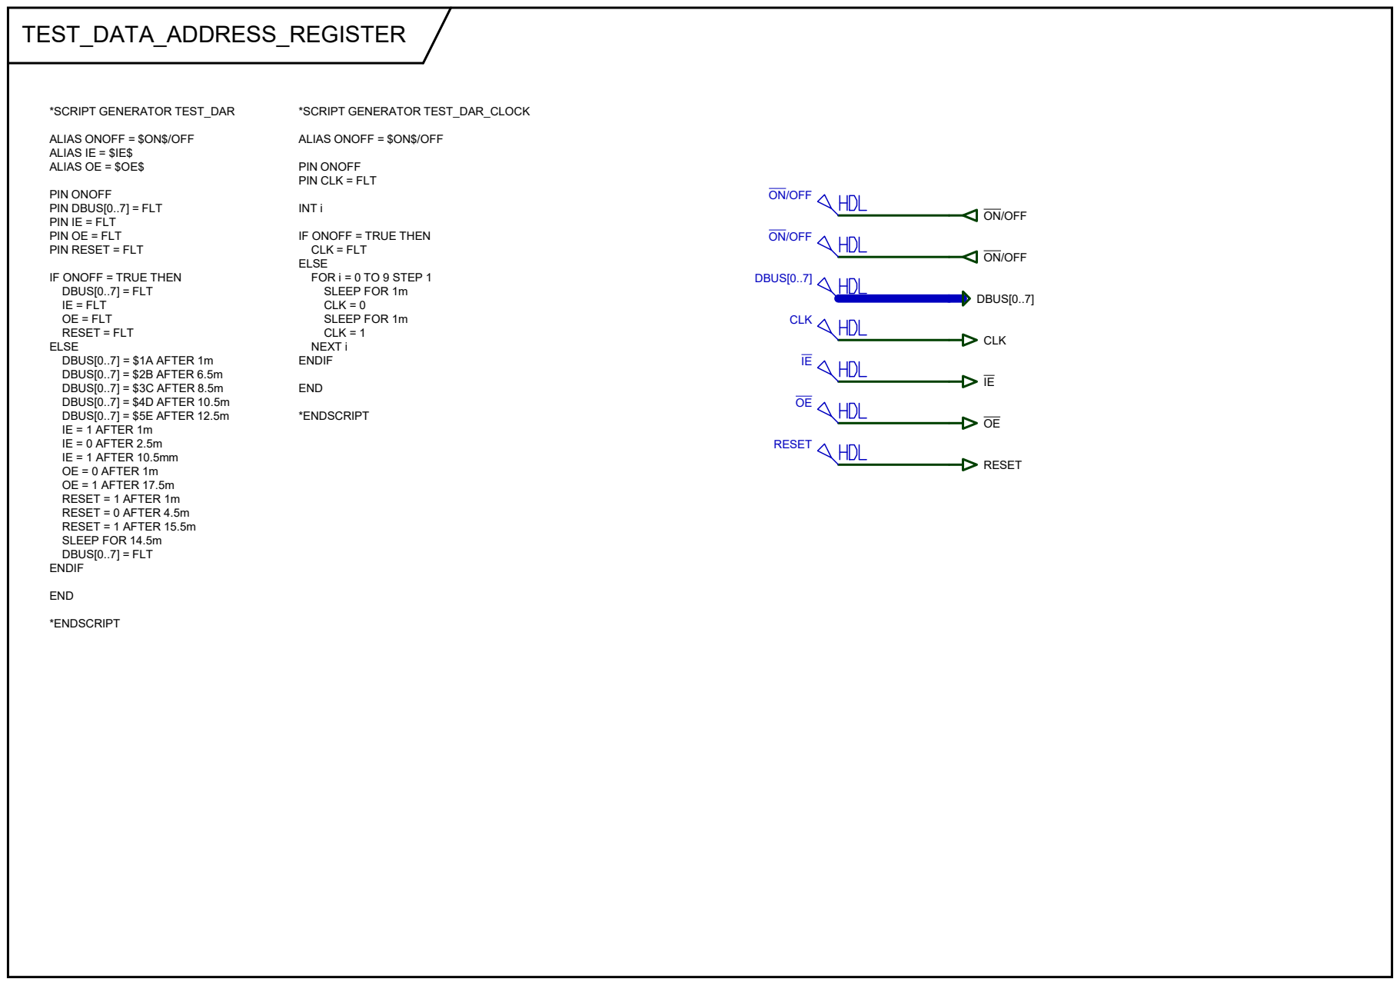
[picture p18: figure]
*SCRIPT GENERATOR TEST_DAR; ALIAS ONOFF = $ON$/OFF ALIAS IE = $IE$ ALIAS OE = $OE$; PIN ONOFF PIN DBUS[0..7] = FLT PIN IE = FLT PIN OE = FLT PIN RESET = FLT; IF ONOFF = TRUE THEN DBUS[0..7] = FLT IE = FLT OE = FLT RESET = FLT ELSE DBUS[0..7] = $1A AFTER 1m DBUS[0..7] = $2B AFTER 6.5m DBUS[0..7] = $3C AFTER 8.5m DBUS[0..7] = $4D AFTER 10.5m DBUS[0..7] = $5E AFTER 12.5m IE = 1 AFTER 1m IE = 0 AFTER 2.5m IE = 1 AFTER 10.5mm OE = 0 AFTER 1m OE = 1 AFTER 17.5m RESET = 1 AFTER 1m RESET = 0 AFTER 4.5m RESET = 1 AFTER 15.5m SLEEP FOR 14.5m DBUS[0..7] = FLT ENDIF; END; *ENDSCRIPT; DBUS[0..7]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
