LucasJadilo/ez8-hardware/docs/EZ8_Program_Counter.pdf

# ROOT

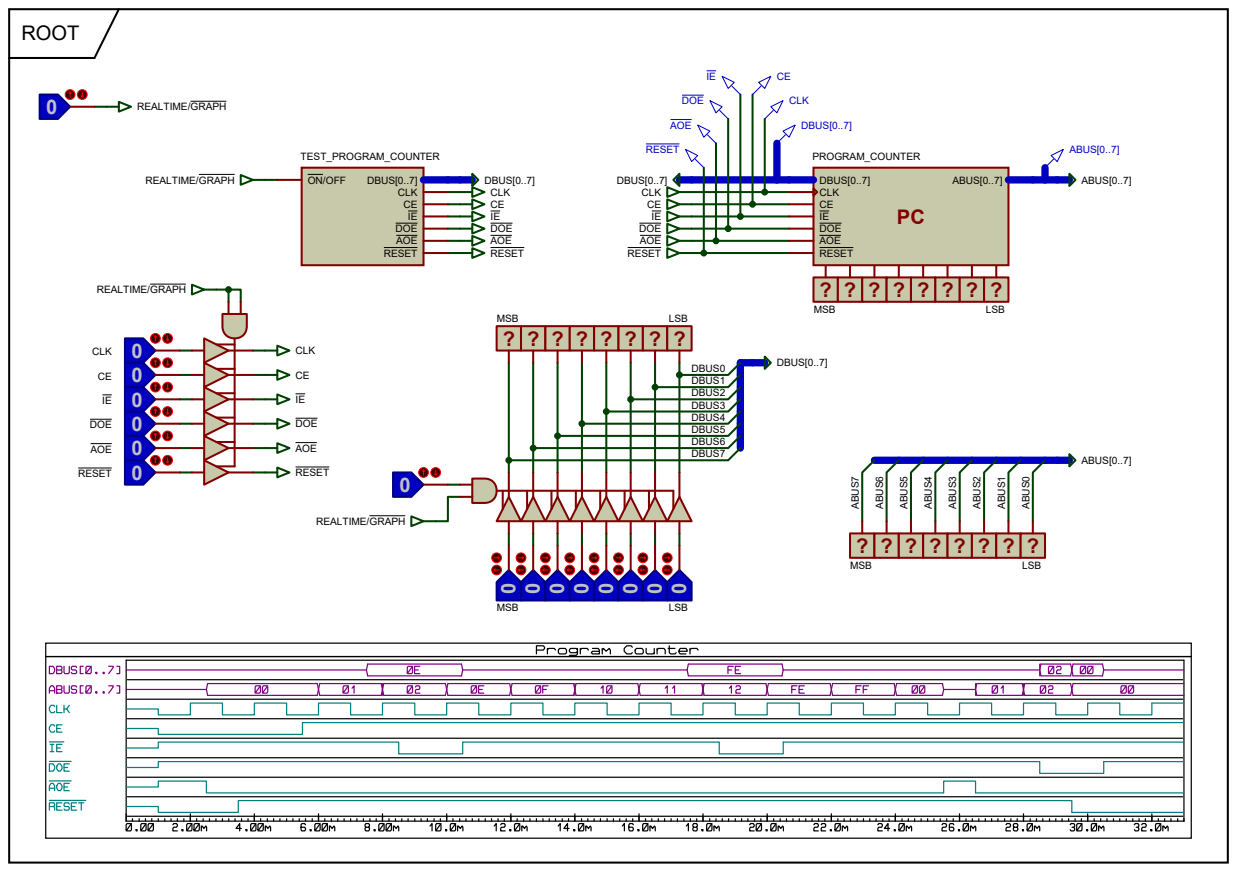
[picture p19: page 1]
DBUS7; DBUS6; DBUS5; DBUS4; DBUS3; DBUS2; DBUS1; DBUS0; ABUS⁷; ABUS⁶; ABUS⁵; ABUS⁴; ABUS³; ABUS²; ABUS¹; ABUS⁰; CLK; DOE; REALTIME/GRAPH; 0 REALTIME/GRAPH; DBUS[0..7]; ABUS[0..7]; IE DOE; RESET; AOE; DBUS[0..7] CLK; MSB 0; LSB 0; MSB; LSB; PROGRAM_COUNTER; ON/OFF; TEST_PROGRAM_COUNTER

# PROGRAM_COUNTER

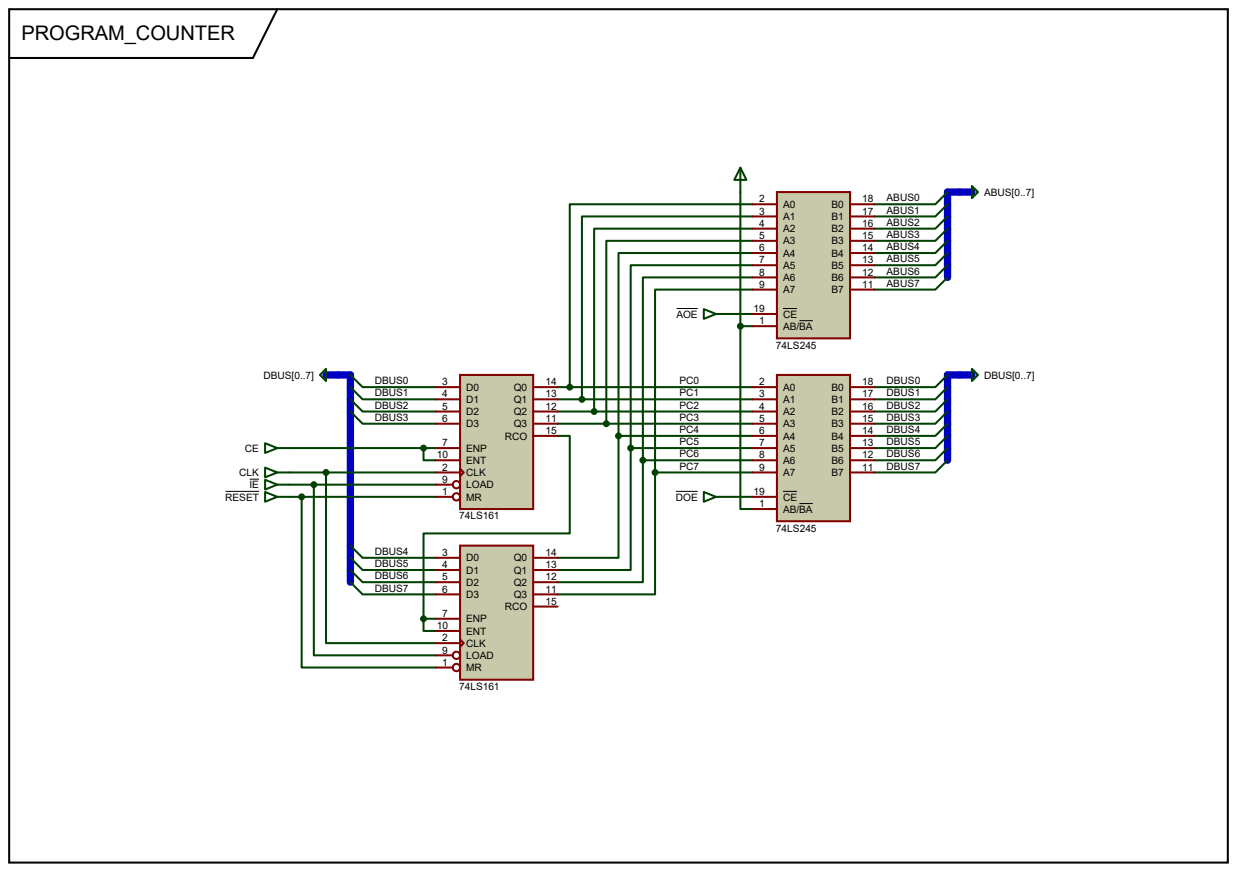
[picture p20: page 2]

# TEST_PROGRAM_COUNTER

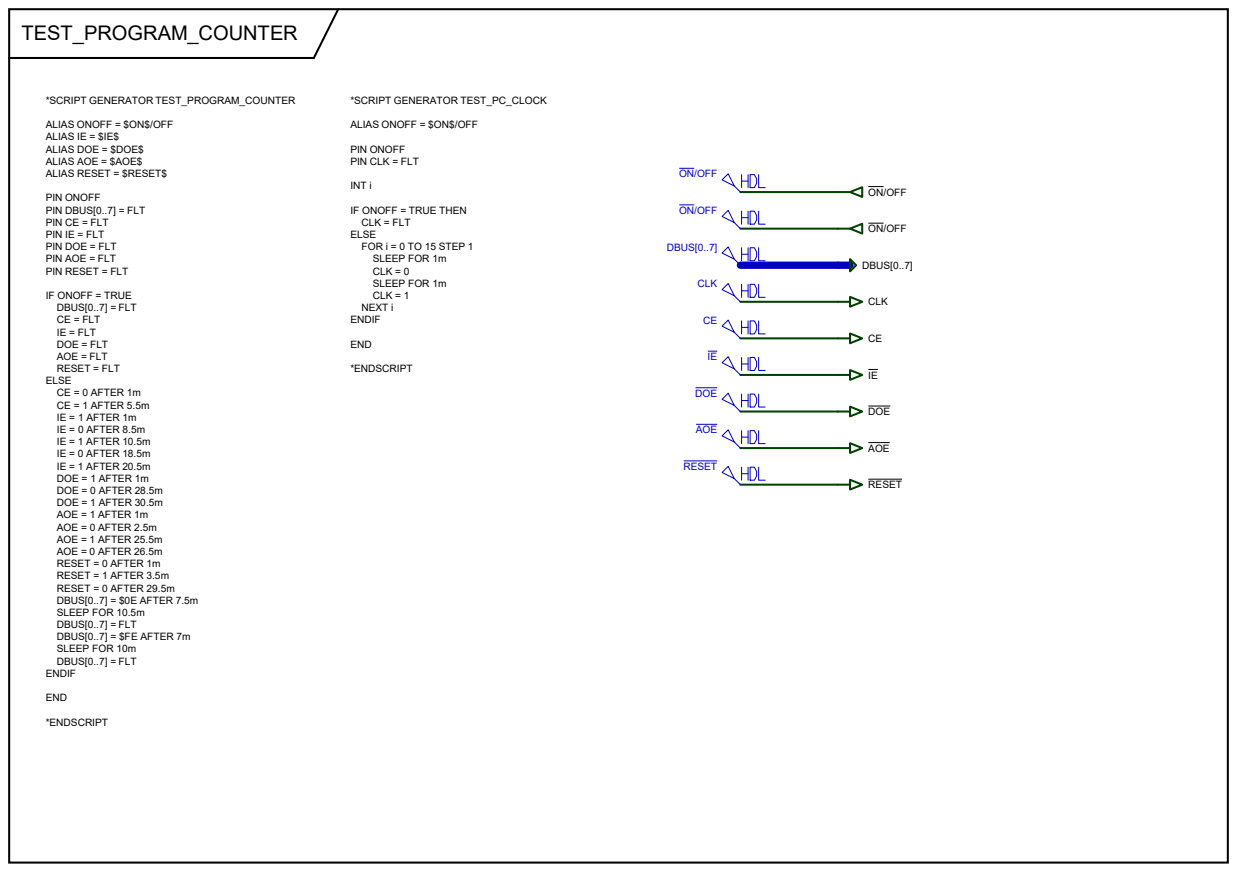
[picture p21: page 3]
*SCRIPT GENERATOR TEST_PROGRAM_COUNTER; END; *ENDSCRIPT; CLK; ON/OFF; DBUS[0..7]; AOE; RESET; *SCRIPT GENERATOR TEST_PC_CLOCK; INT i; DOE

ALIAS ONOFF = $ON$/OFF
ALIAS IE = $IE$
ALIAS DOE = $DOE$
ALIAS AOE = $AOE$
ALIAS RESET = $RESET$

PIN ONOFF
PIN CLK = FLT

PIN DBUS[0..7] = FLT
PIN CE = FLT
PIN IE = FLT
PIN DOE = FLT
PIN AOE = FLT
PIN RESET = FLT

IF ONOFF = TRUE THEN
CLK = FLT
ELSE
FOR i = 0 TO 15 STEP 1
SLEEP FOR 1m
CLK = 0
CLK = 1
NEXT i
ENDIF

IF ONOFF = TRUE
DBUS[0..7] = FLT
CE = FLT
IE = FLT
DOE = FLT
AOE = FLT
RESET = FLT
CE = 0 AFTER 1m
CE = 1 AFTER 5.5m
IE = 1 AFTER 1m
IE = 0 AFTER 8.5m
IE = 1 AFTER 10.5m
IE = 0 AFTER 18.5m
IE = 1 AFTER 20.5m
DOE = 1 AFTER 1m
DOE = 0 AFTER 28.5m
DOE = 1 AFTER 30.5m
AOE = 1 AFTER 1m
AOE = 0 AFTER 2.5m
AOE = 1 AFTER 25.5m
AOE = 0 AFTER 26.5m
RESET = 0 AFTER 1m
RESET = 1 AFTER 3.5m
RESET = 0 AFTER 29.5m
DBUS[0..7] = $0E AFTER 7.5m
SLEEP FOR 10.5m
DBUS[0..7] = $FE AFTER 7m
SLEEP FOR 10m
