LucasJadilo/ez8-hardware/docs/EZ8_RAM.pdf

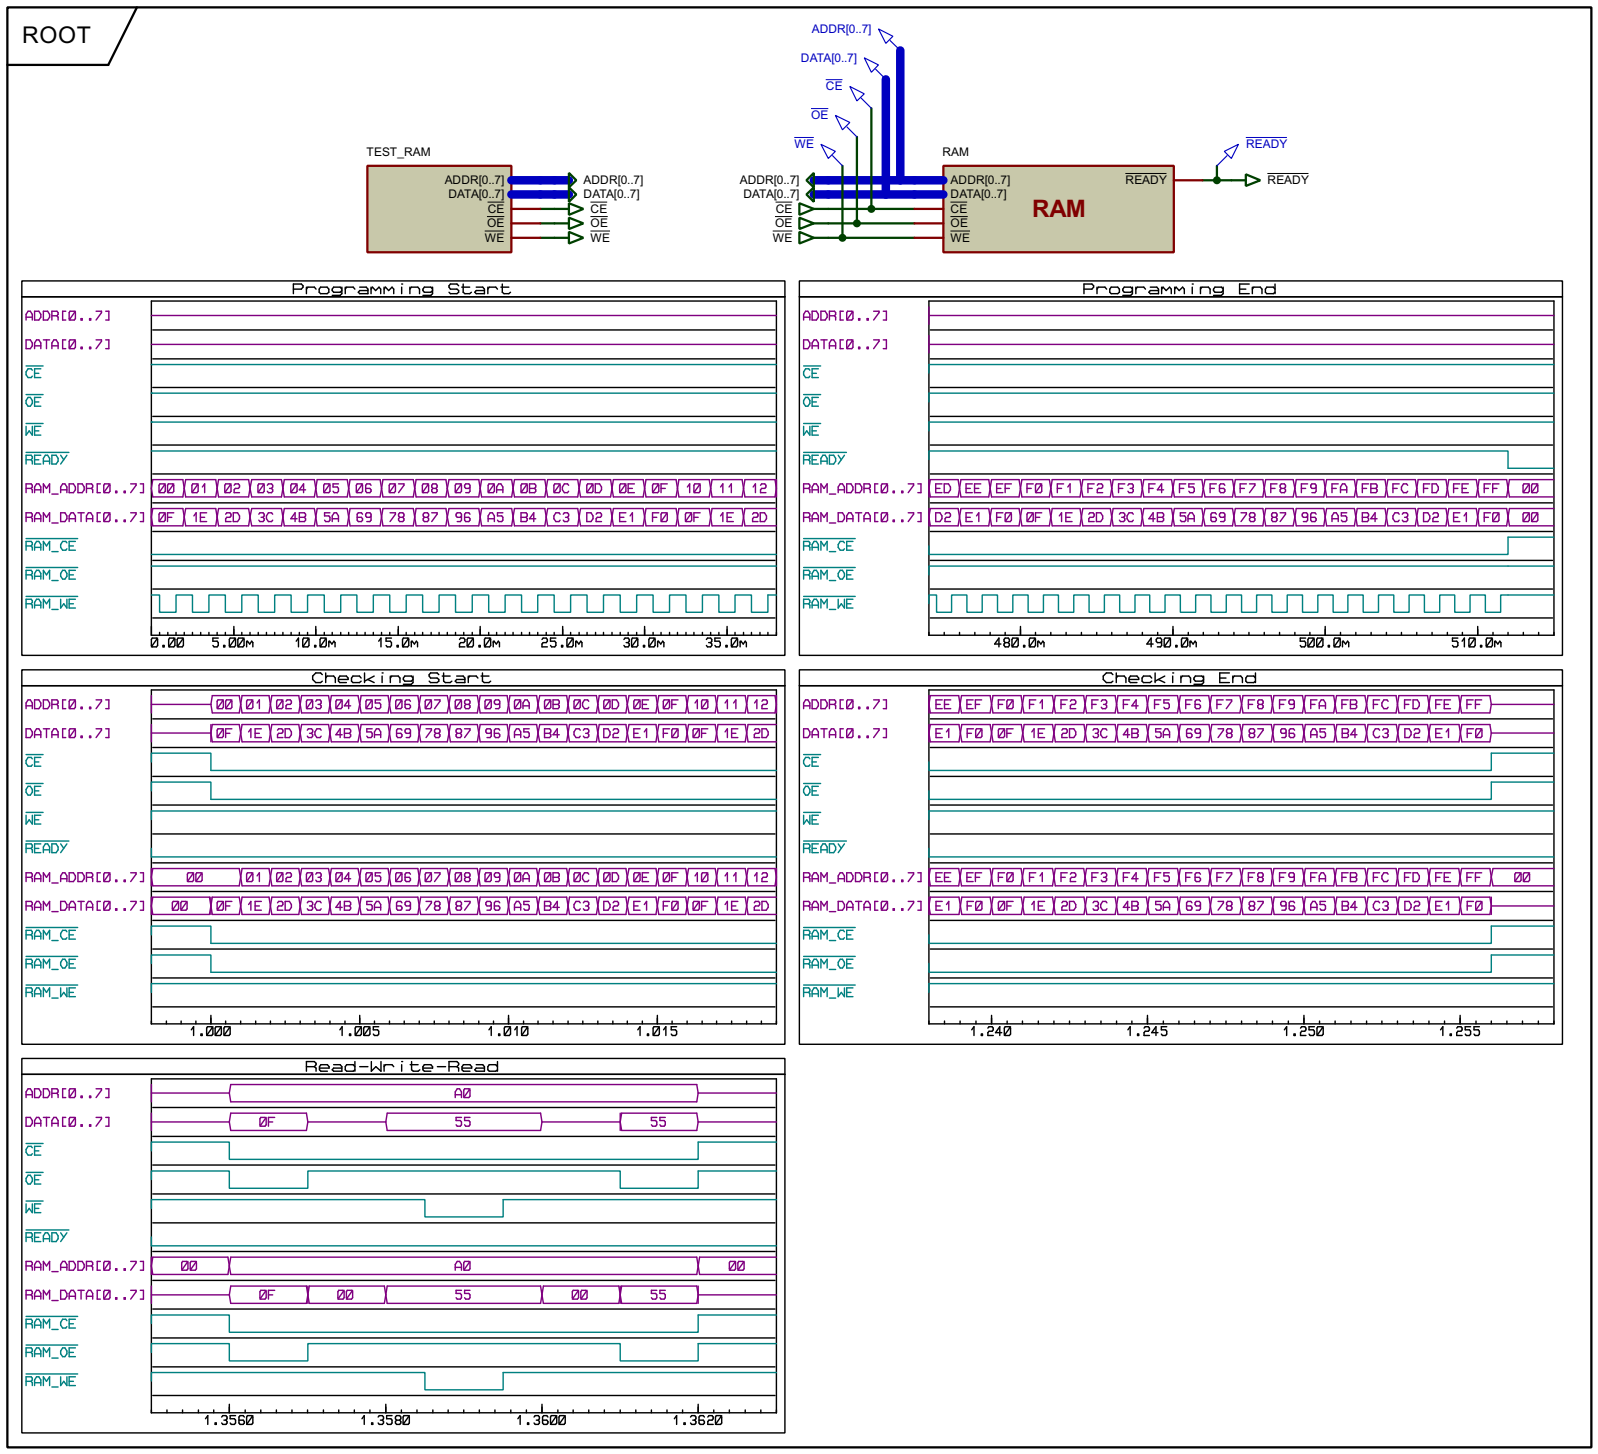
[picture p22: page 1]
ROOT; OECE ADDR[0..7]; ADDR[0..7] DATA[0..7] ADDR[0..7] DATA[0..7] OECE WE; READY READY CEOE WE; RAM ADDR[0..7] DATA[0..7] CEWE; READY OE RAM WE DATA[0..7] CEOE ADDR[0..7] WE DATA[0..7] TEST_RAM

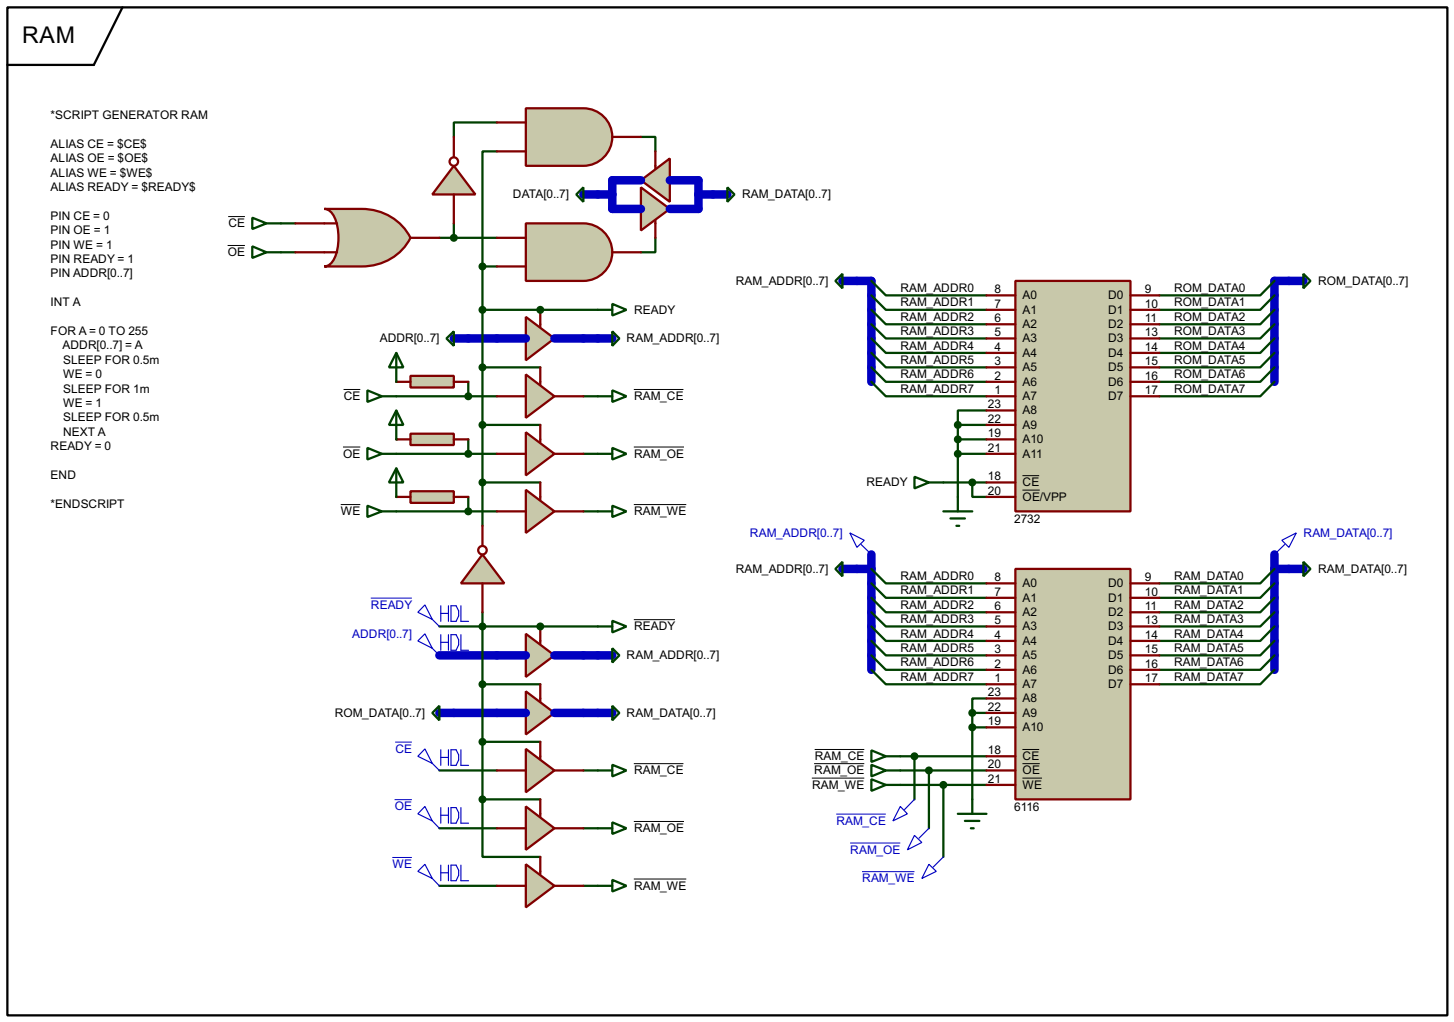
[picture p23: page 2]

*SCRIPT GENERATOR TEST_RAM ALIAS CE = $CE$ ALIAS OE = $OE$ ALIAS WE = $WE$ ALIAS DAT = DATA PIN ADDR[0..7] = FLT PIN DAT[0..7] = FLT PIN CE = 1 PIN OE = 1 PIN WE = 1 INT A, D // Check Programming SLEEP FOR 1000m CE = 0 OE = 0 FOR A = 0 TO 255 ADDR[0..7] = A SLEEP FOR 1m NEXT A ADDR[0..7] = FLT CE = 1 OE = 1 // Read-Write-Read SLEEP FOR 100m CE = 0 ADDR[0..7] = $A0 OE = 0 SLEEP FOR 1m OE = 1 SLEEP FOR 1m DAT[0..7] = $55 SLEEP FOR 0.5m WE = 0 SLEEP FOR 1m WE = 1 SLEEP FOR 0.5m DAT[0..7] = FLT SLEEP FOR 1m OE = 0 SLEEP FOR 1m ADDR[0..7] = FLT OE = 1 CE = 1 END *ENDSCRIPT TEST_RAM | CE CE | OE OE ADDR[0..7] | ADDR[0..7] WE DATA[0..7] | WE DATA[0..7]
