LucasJadilo/ez8-hardware/docs/EZ8_Stack_Pointer.pdf

# ROOT

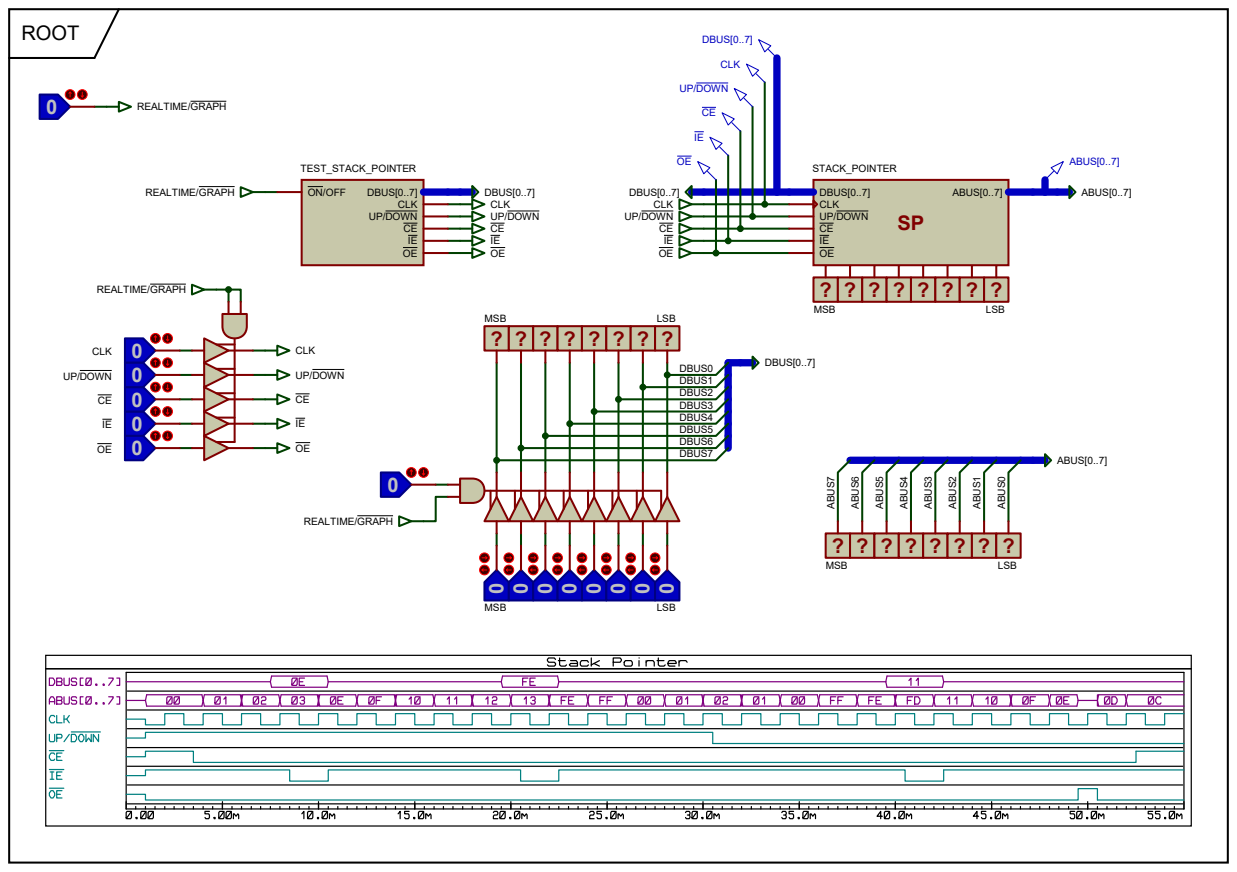
[picture p24: page 1]
DBUS7; DBUS6; DBUS5; DBUS4; DBUS3; DBUS2; DBUS1; DBUS0; ABUS⁷; ABUS⁶; ABUS⁵; ABUS⁴; ABUS³; ABUS²; ABUS¹; ABUS⁰; CLK; REALTIME/GRAPH; 0 REALTIME/GRAPH; DBUS[0..7]; ABUS[0..7]; UP/DOWN; DBUS[0..7] CLK; MSB 0; LSB 0; MSB; LSB; UP/DOWN CE; STACK_POINTER; ON/OFF; TEST_STACK_POINTER

# STACK_POINTER

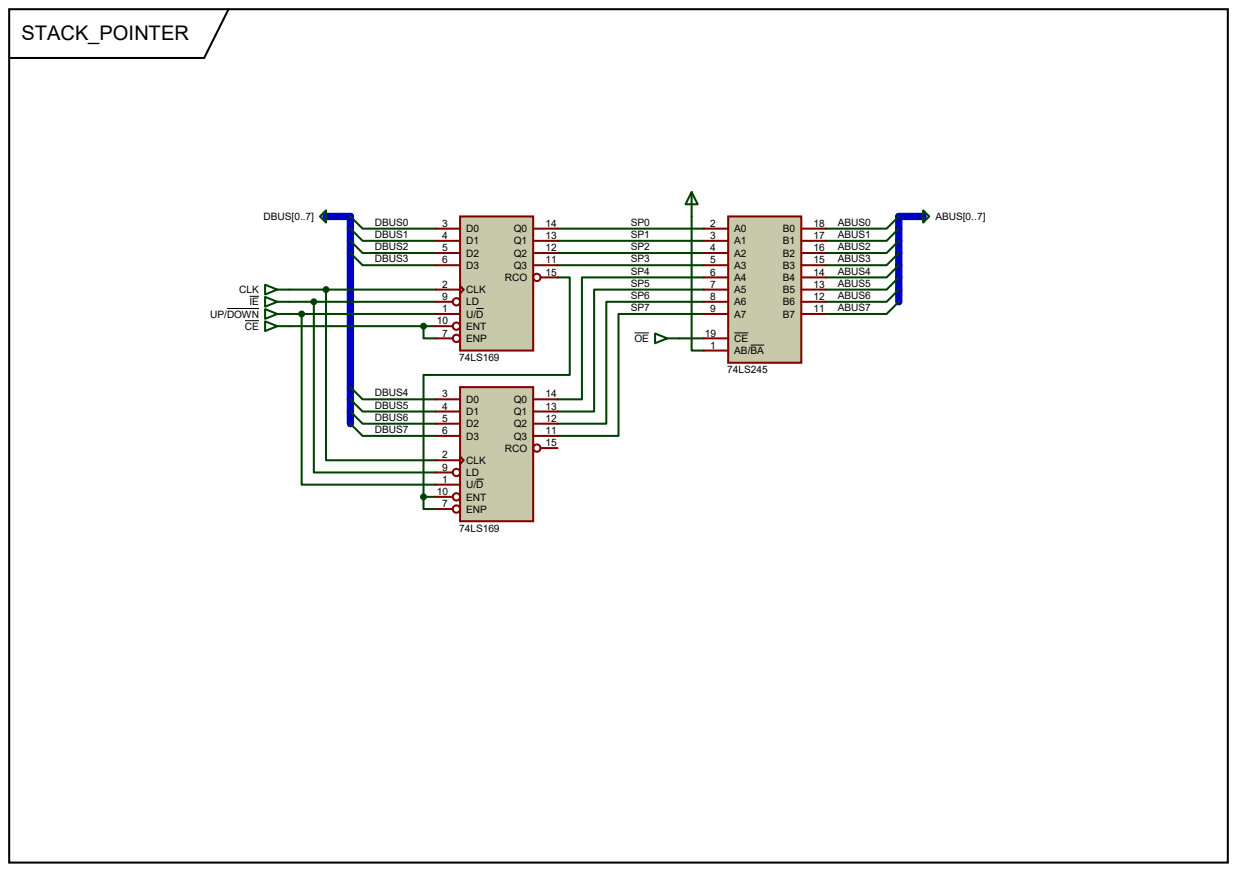
[picture p25: page 2]

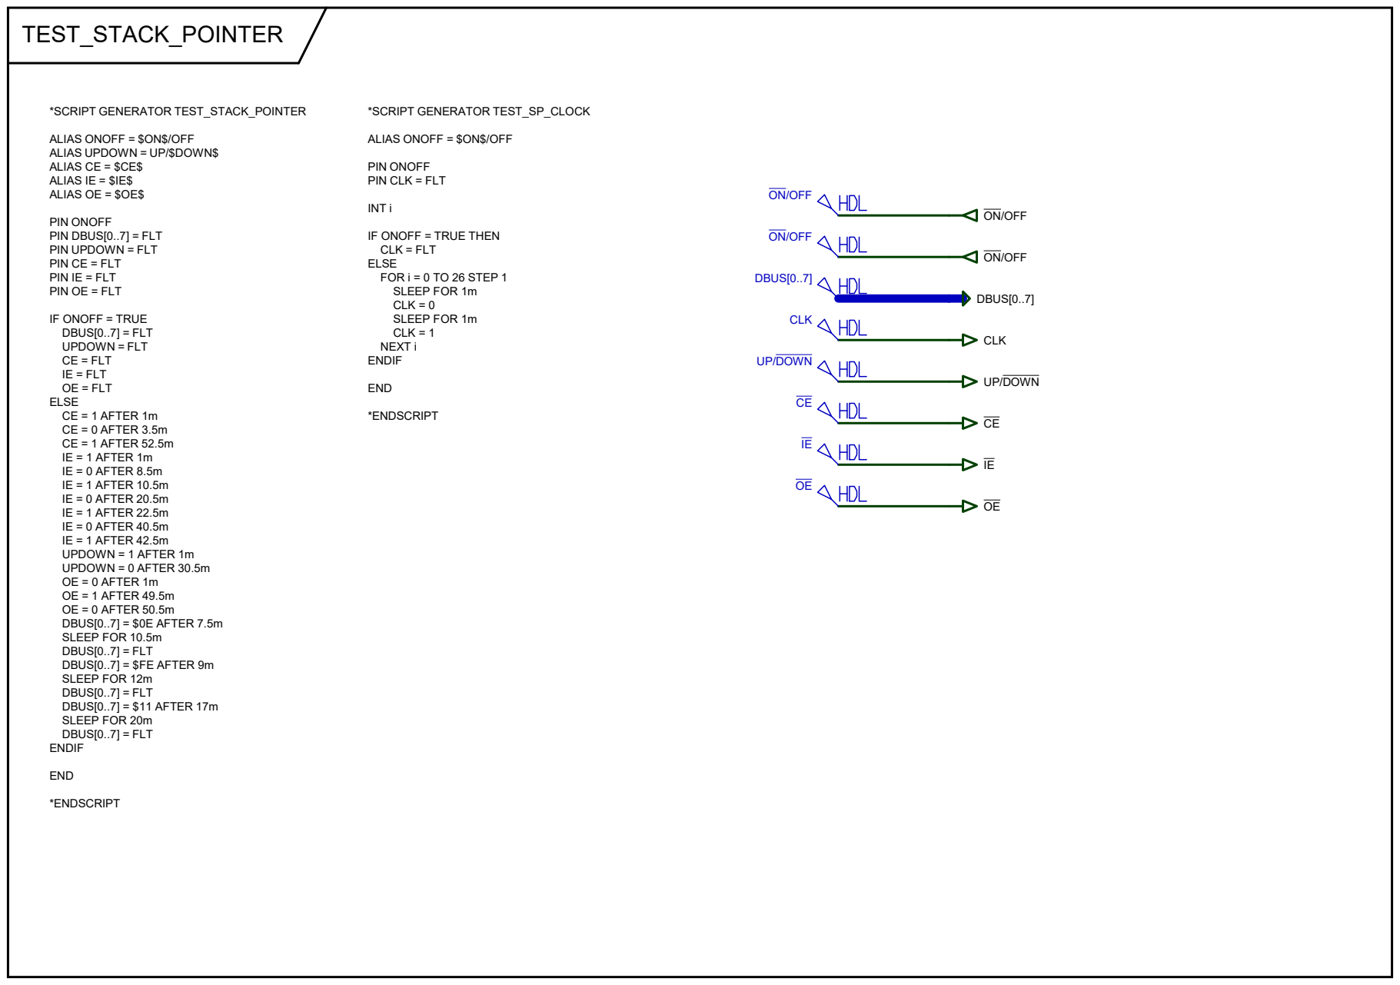
[picture p26: figure]
*SCRIPT GENERATOR TEST_STACK_POINTER; ALIAS ONOFF = $ON$/OFF ALIAS UPDOWN = UP/$DOWN$ ALIAS CE = $CE$ ALIAS IE = $IE$ ALIAS OE = $OE$; PIN ONOFF PIN DBUS[0..7] = FLT PIN UPDOWN = FLT PIN CE = FLT PIN IE = FLT PIN OE = FLT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
