LucasJadilo/ez8-hardware/docs/EZ8_Control_Unit.pdf

# OUT0 OUT1 OUT2 OUT4 OUT5 OUT6 OUT7 OUT8 OUT9 OUT10 OUT11

# OUT28 OUT27 OUT26 OUT25 OUT24 OUT23 OUT22 OUT21 OUT20 OUT19 OUT18 OUT17 OUT16 OUT15

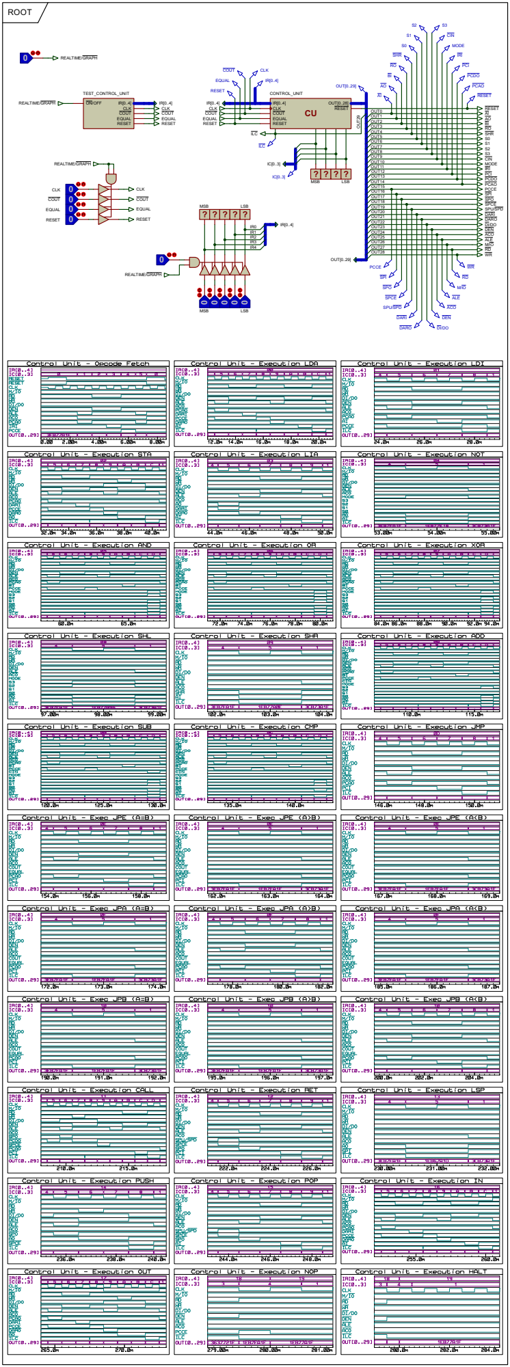
[picture p27: page 1]
OUT3; OUT29 OUT12 OUT13 OUT14; COUT; CLK COUT CLK; REALTIME/GRAPH; IR[0..4] CLK COUT; OUT[0..29]; ROOT; CLK; MSB; LSB; EQUAL RESET; SHR S0S1S2S3CIN MODE; PCCE SPI SPO; SPCE SPU/SPD DARI DARO; DI/DO DEN ACO ALE M/IO; RDWR; SHR; PCDO; PCI; RESET; SPCE; SPU/SPD; DARI DARO; ALE; ACO; DEN; SPO; SPI; PCCE; RESET EQUAL; ILC; PCAO CU; OUT[0..28]; CONTROL_UNIT; TEST_CONTROL_UNIT; MSB 0; LSB 0; MSB ? ? ? ?

IRI MODE CIN

IR[0..4] CLK COUT ON/OFF

IR[0..4] COUT CLK

EQUAL COUT CLK RESET

IRI PCI PCAO

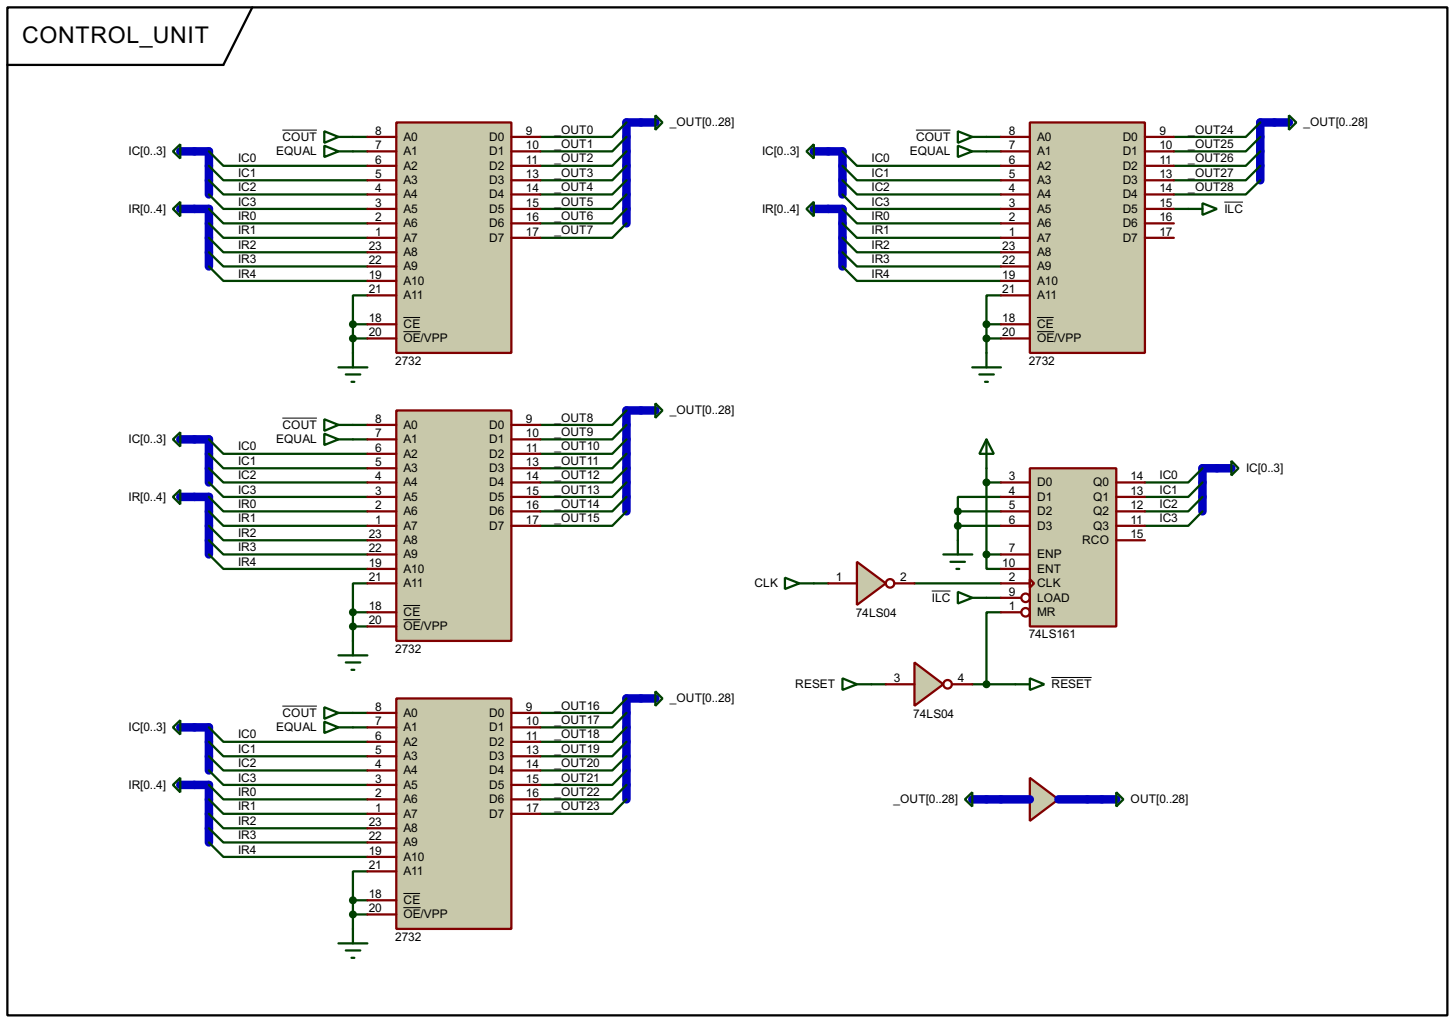
[picture p28: page 2]

COUT CLK ON/OFF IR[0..4] COUT CLK | IR[0..4] ON/OFF TEST_CONTROL_UNIT | *SCRIPT GENERATOR TEST_CU_CLOCK ALIAS ONOFF = $ON$/OFF PIN ONOFF PIN CLK = FLT INT i IF ONOFF = TRUE THEN CLK = FLT ELSE FOR i = 0 TO 300 STEP 1 SLEEP FOR 0.5m CLK = 0 SLEEP FOR 0.5m CLK = 1 NEXT i ENDIF END *ENDSCRIPT *SCRIPT GENERATOR TEST_CONTROL_UNIT ALIAS ONOFF = $ON$/OFF ALIAS COUT = $COUT$ PIN ONOFF PIN IR[0..4] = FLT PIN COUT = FLT PIN EQUAL = FLT PIN RESET = FLT INT OP_LDA = $00, OP_LDI = $01, OP_STA = $02, OP_LIA = $03 INT OP_NOT = $04, OP_AND = $05, OP_OR = $06, OP_XOR = $07 INT OP_SHL = $08, OP_SHR = $09, OP_ADD = $0A, OP_SUB = $0B INT OP_CMP = $0C, OP_JMP = $0D, OP_JPE = $0E, OP_JPA = $0F INT OP_JPB = $10, OP_CALL = $11, OP_RET = $12, OP_LSP = $13 INT OP_PUSH = $14, OP_POP = $15, OP_IN = $16, OP_OUT = $17 INT OP_NOP = $18, OP_HALT = $19 IF ONOFF = TRUE THEN IR[0..4] = FLT COUT = FLT EQUAL = FLT RESET = FLT ELSE RESET = 1 AFTER 0.5m RESET = 0 AFTER 1.75m RESET = 1 AFTER 7.25m RESET = 0 AFTER 8.5m COUT = 1 AFTER 0.5m EQUAL = 0 AFTER 0.5m SLEEP FOR 12m IR[0..4] = OP_LDA : SLEEP FOR 12m IR[0..4] = OP_LDI : SLEEP FOR 8m IR[0..4] = OP_STA : SLEEP FOR 12m IR[0..4] = OP_LIA : SLEEP FOR 9m IR[0..4] = OP_NOT : SLEEP FOR 5m IR[0..4] = OP_AND : SLEEP FOR 13m IR[0..4] = OP_OR : SLEEP FOR 13m IR[0..4] = OP_XOR : SLEEP FOR 13m IR[0..4] = OP_SHL : SLEEP FOR 5m IR[0..4] = OP_SHR : SLEEP FOR 5m IR[0..4] = OP_ADD : SLEEP FOR 13m IR[0..4] = OP_SUB : SLEEP FOR 13m IR[0..4] = OP_CMP : SLEEP FOR 13m IR[0..4] = OP_JMP : SLEEP FOR 8m IR[0..4] = OP_JPE : COUT = 1 : EQUAL = 1 : SLEEP FOR 8m IR[0..4] = OP_JPE : COUT = 0 : EQUAL = 0 : SLEEP FOR 5m IR[0..4] = OP_JPE : COUT = 1 : EQUAL = 0 : SLEEP FOR 5m IR[0..4] = OP_JPA : COUT = 1 : EQUAL = 1 : SLEEP FOR 5m IR[0..4] = OP_JPA : COUT = 0 : EQUAL = 0 : SLEEP FOR 8m IR[0..4] = OP_JPA : COUT = 1 : EQUAL = 0 : SLEEP FOR 5m IR[0..4] = OP_JPB : COUT = 1 : EQUAL = 1 : SLEEP FOR 5m IR[0..4] = OP_JPB : COUT = 0 : EQUAL = 0 : SLEEP FOR 5m IR[0..4] = OP_JPB : COUT = 1 : EQUAL = 0 : SLEEP FOR 8m IR[0..4] = OP_CALL : SLEEP FOR 13m IR[0..4] = OP_RET : SLEEP FOR 9m IR[0..4] = OP_LSP : SLEEP FOR 5m IR[0..4] = OP_PUSH : SLEEP FOR 8m IR[0..4] = OP_POP : SLEEP FOR 9m IR[0..4] = OP_IN : SLEEP FOR 12m IR[0..4] = OP_OUT : SLEEP FOR 12m IR[0..4] = OP_NOP : SLEEP FOR 4m IR[0..4] = OP_HALT ENDIF END *ENDSCRIPT | ON/OFF ON/OFF | RESET EQUAL RESET EQUAL

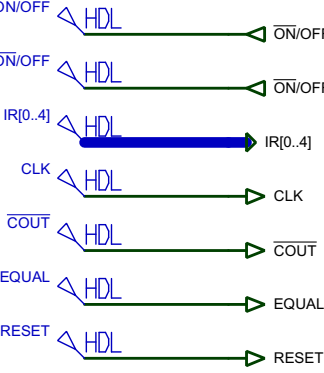
[picture p29: figure]
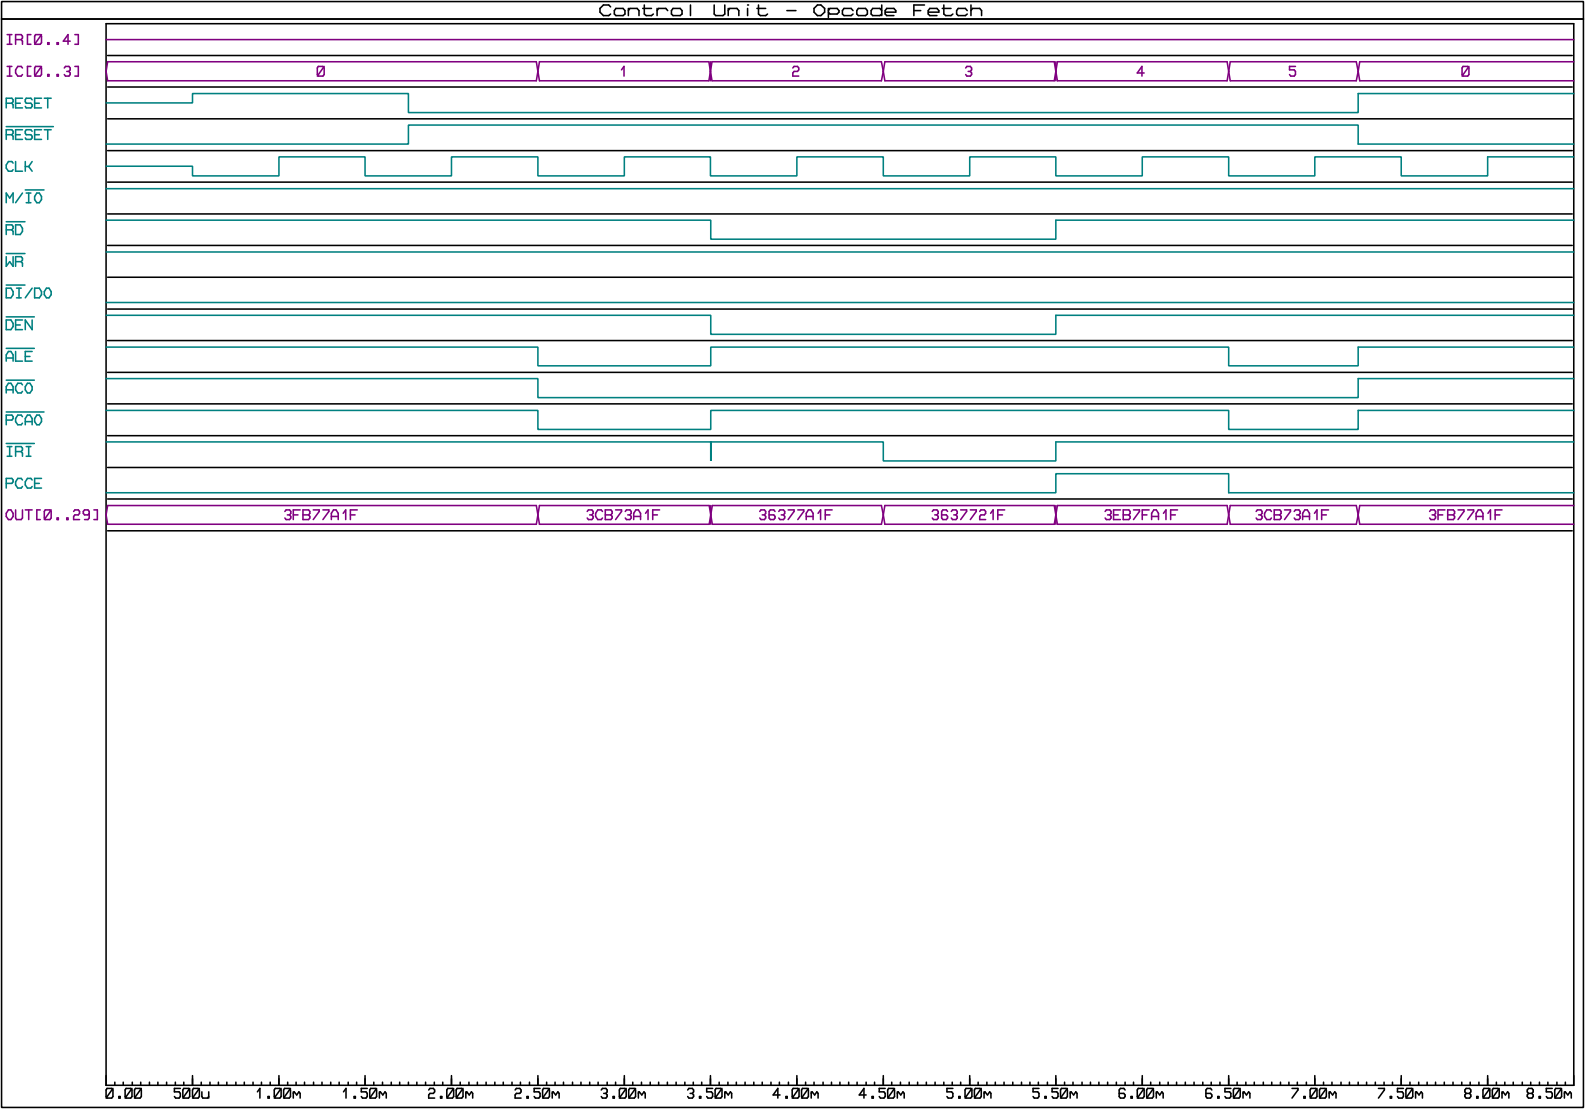
[picture p30: page 4]

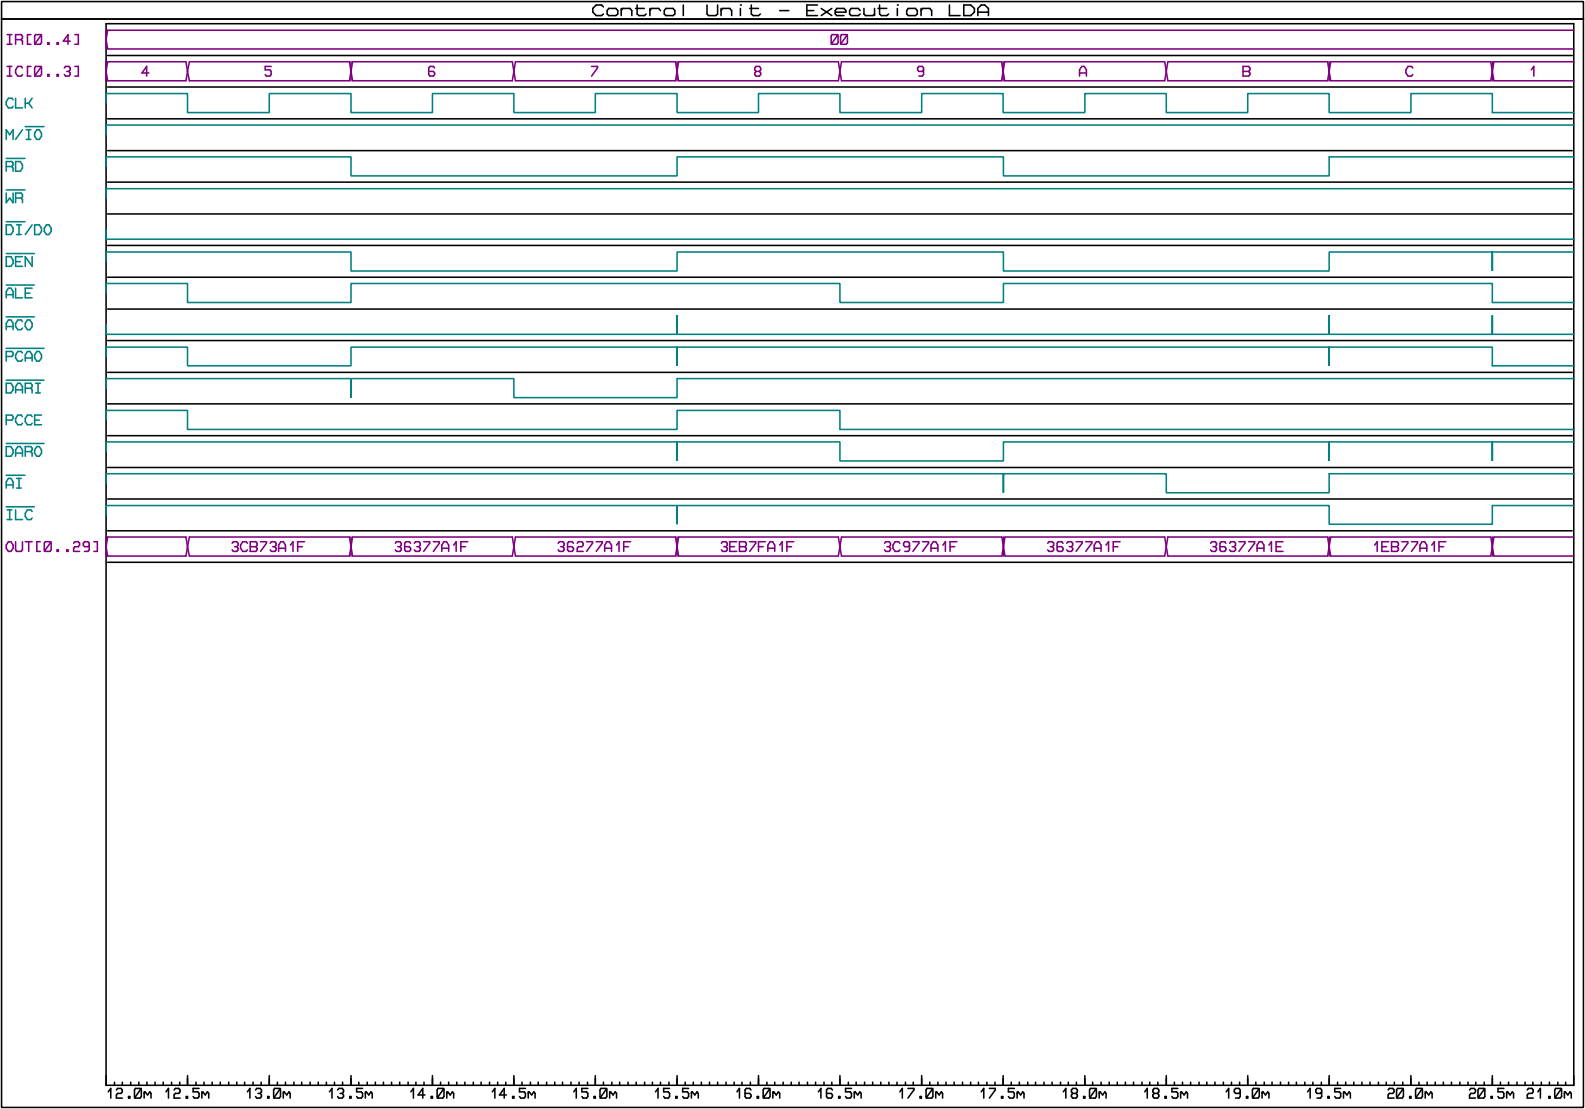
[picture p31: page 5]

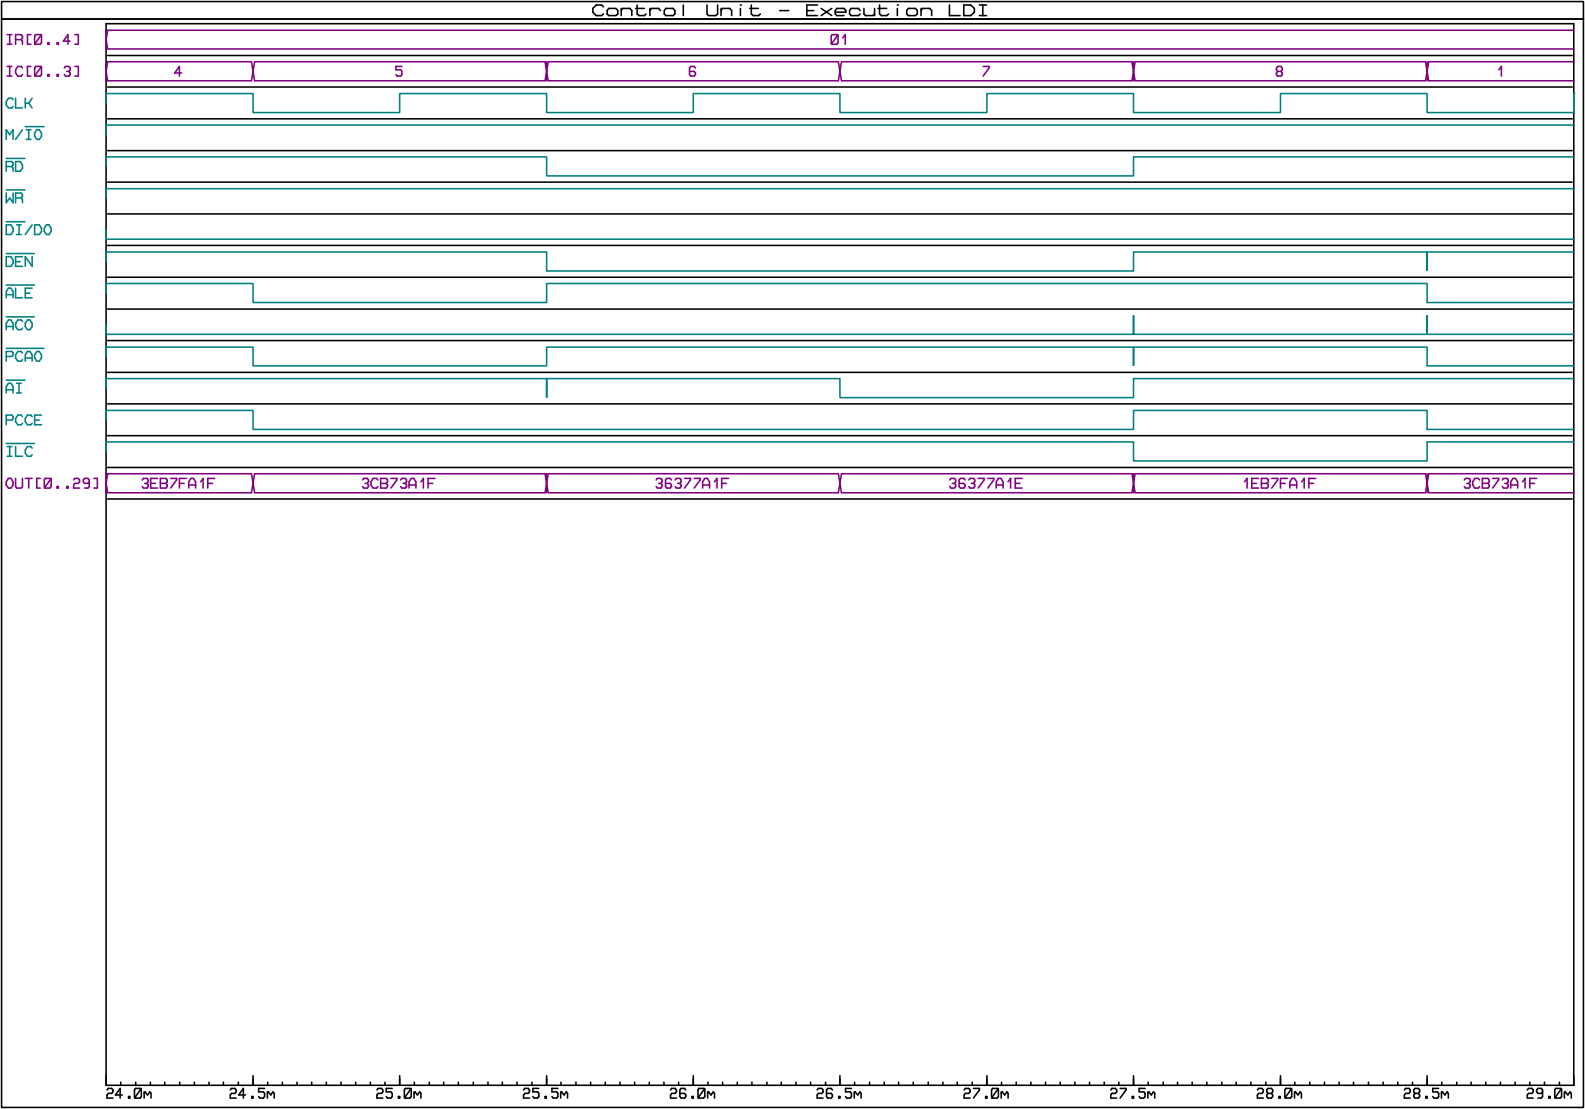
[picture p32: page 6]

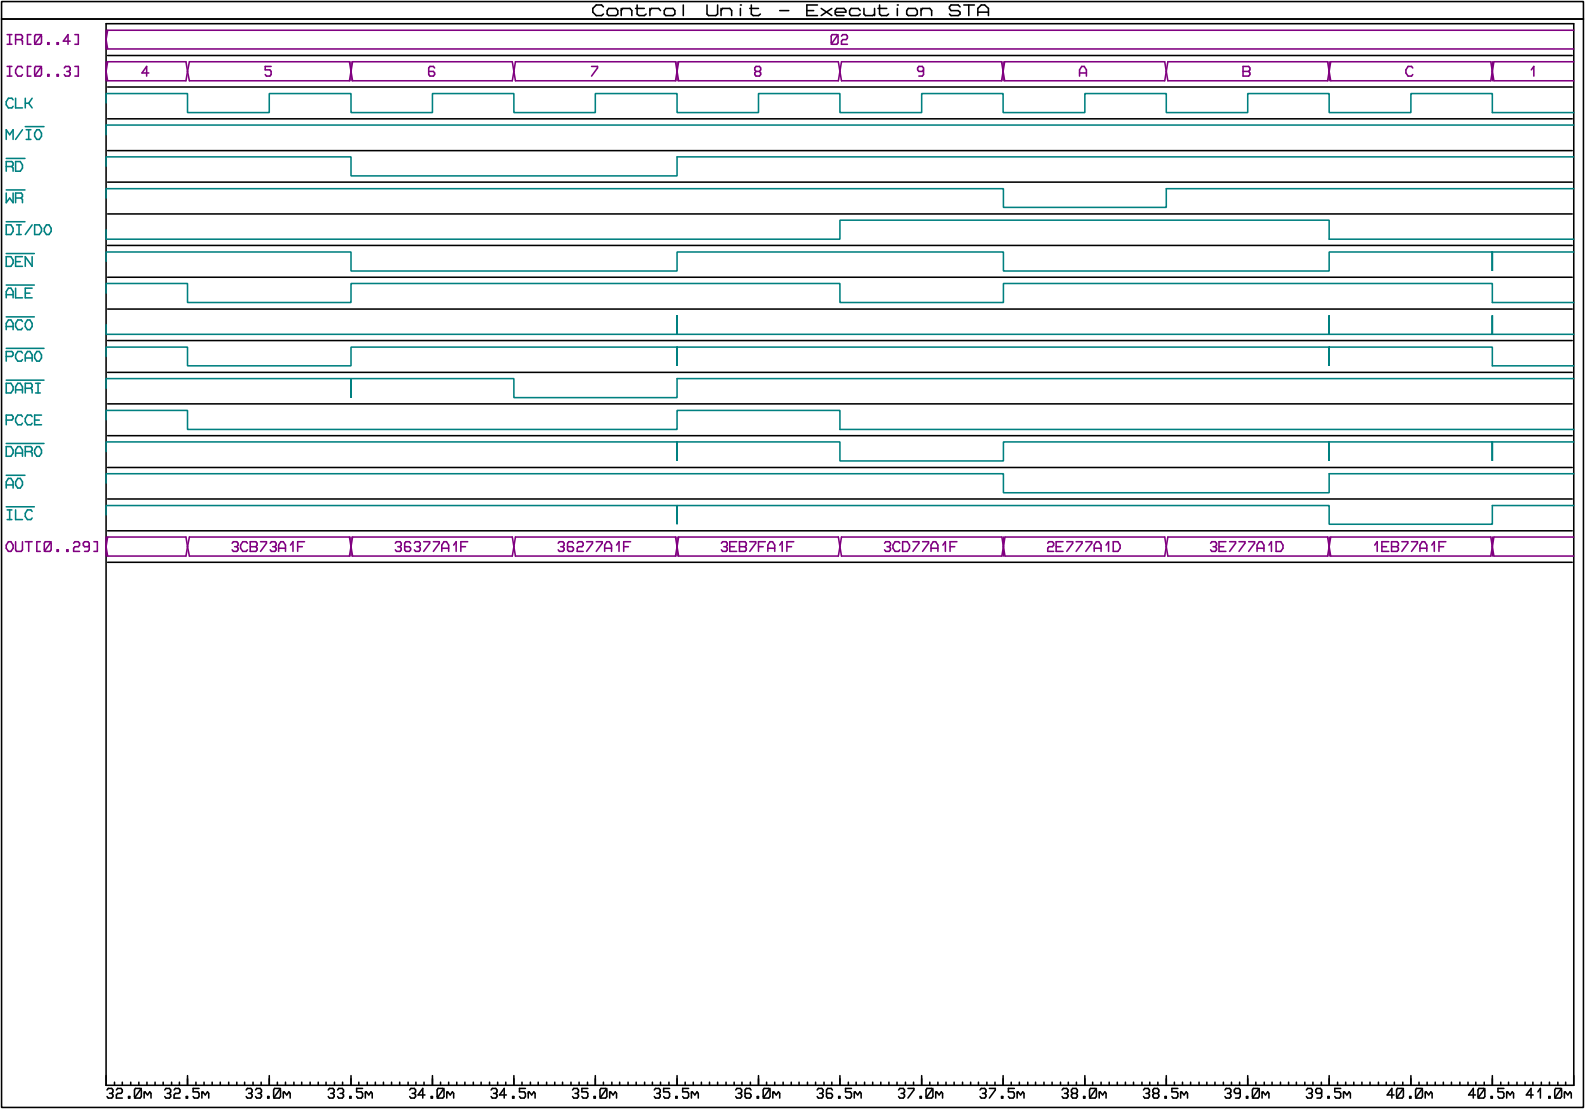
[picture p33: page 7]

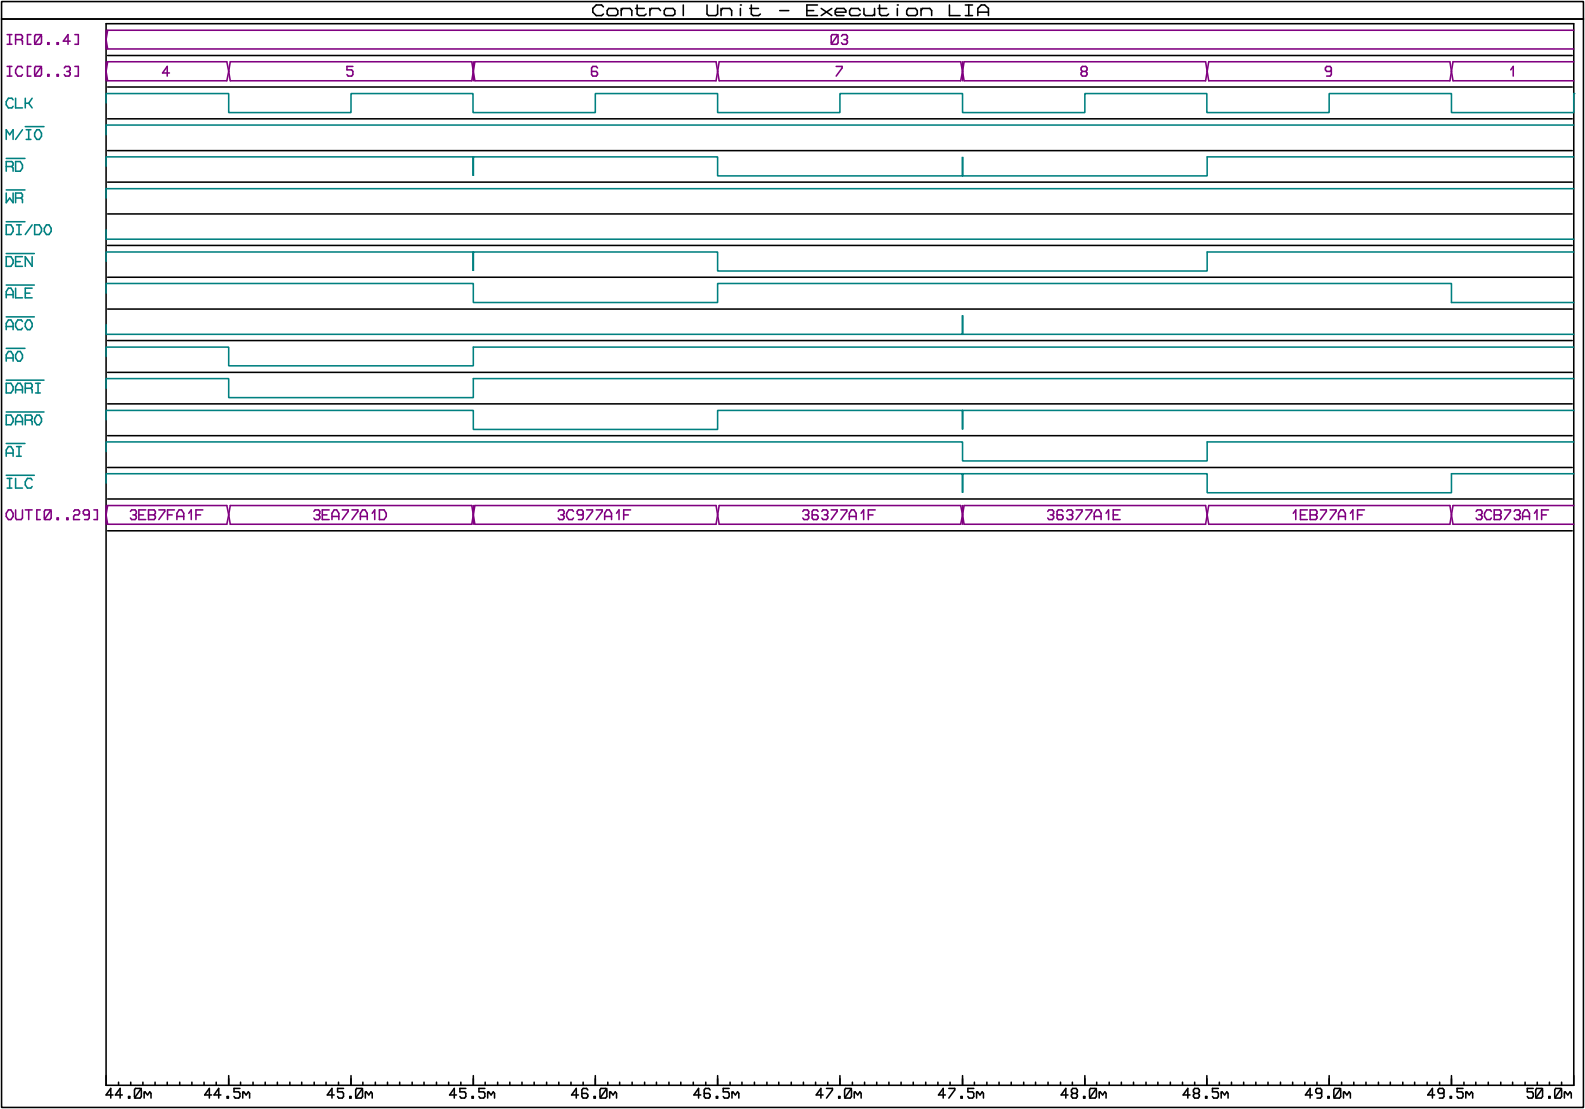
[picture p34: page 8]

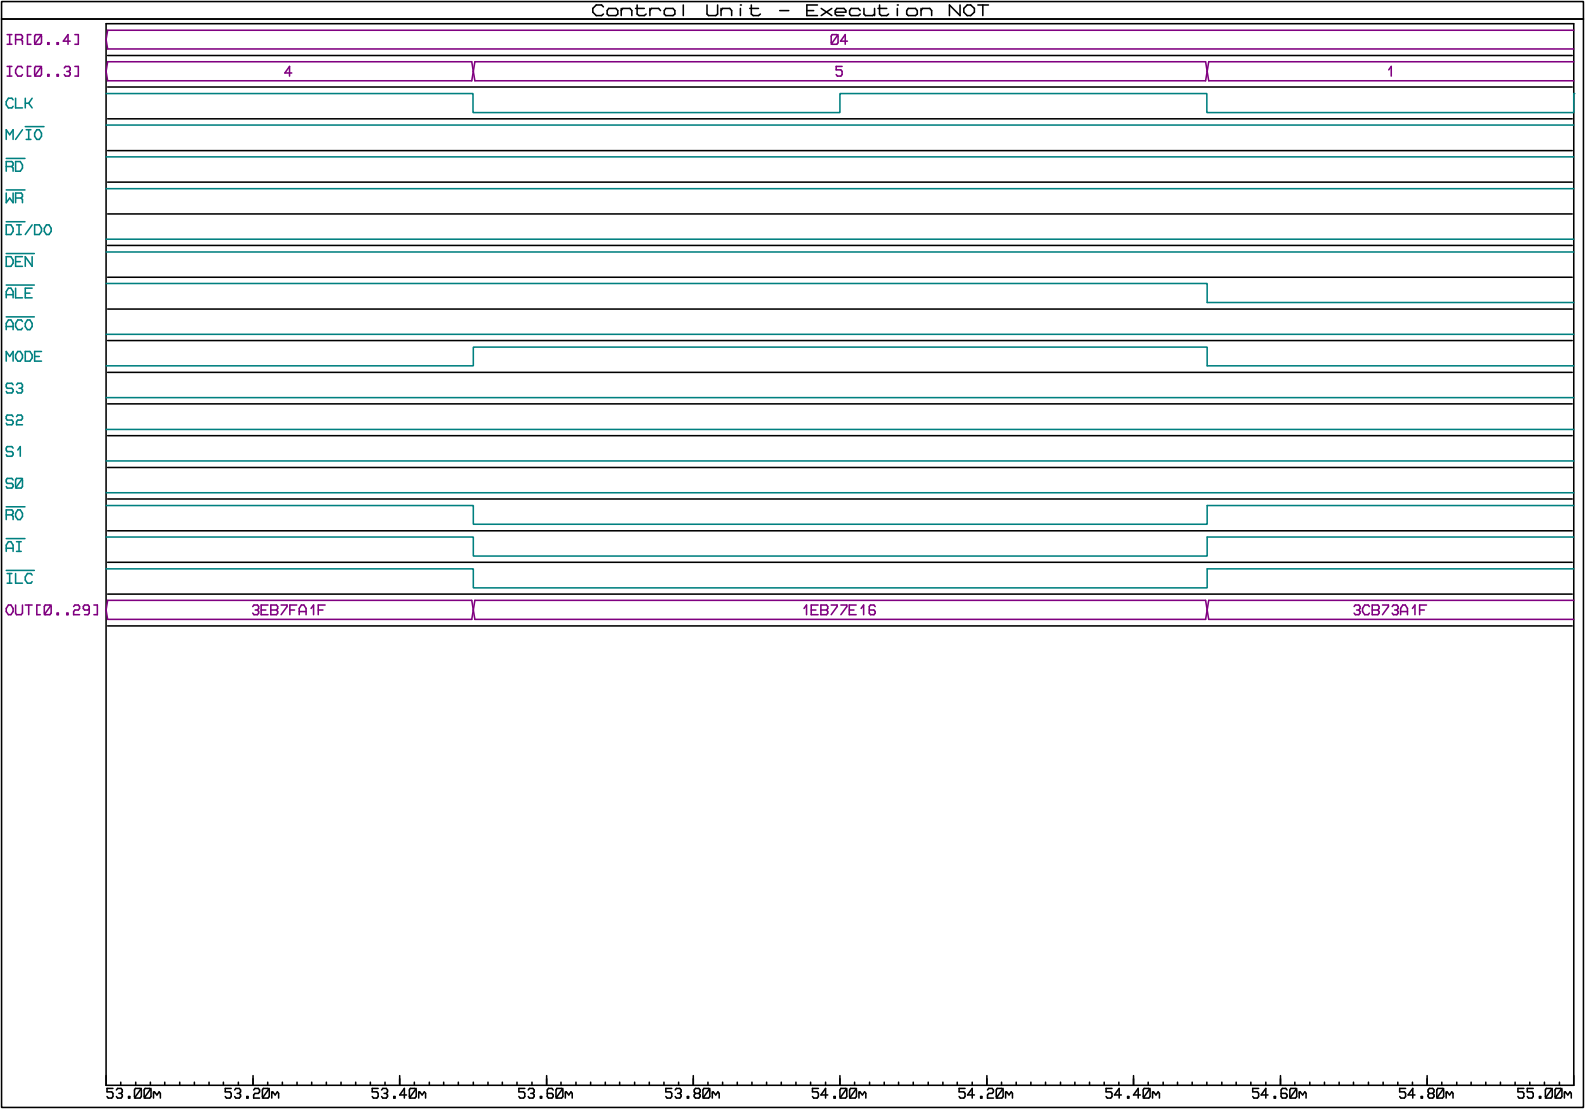
[picture p35: page 9]

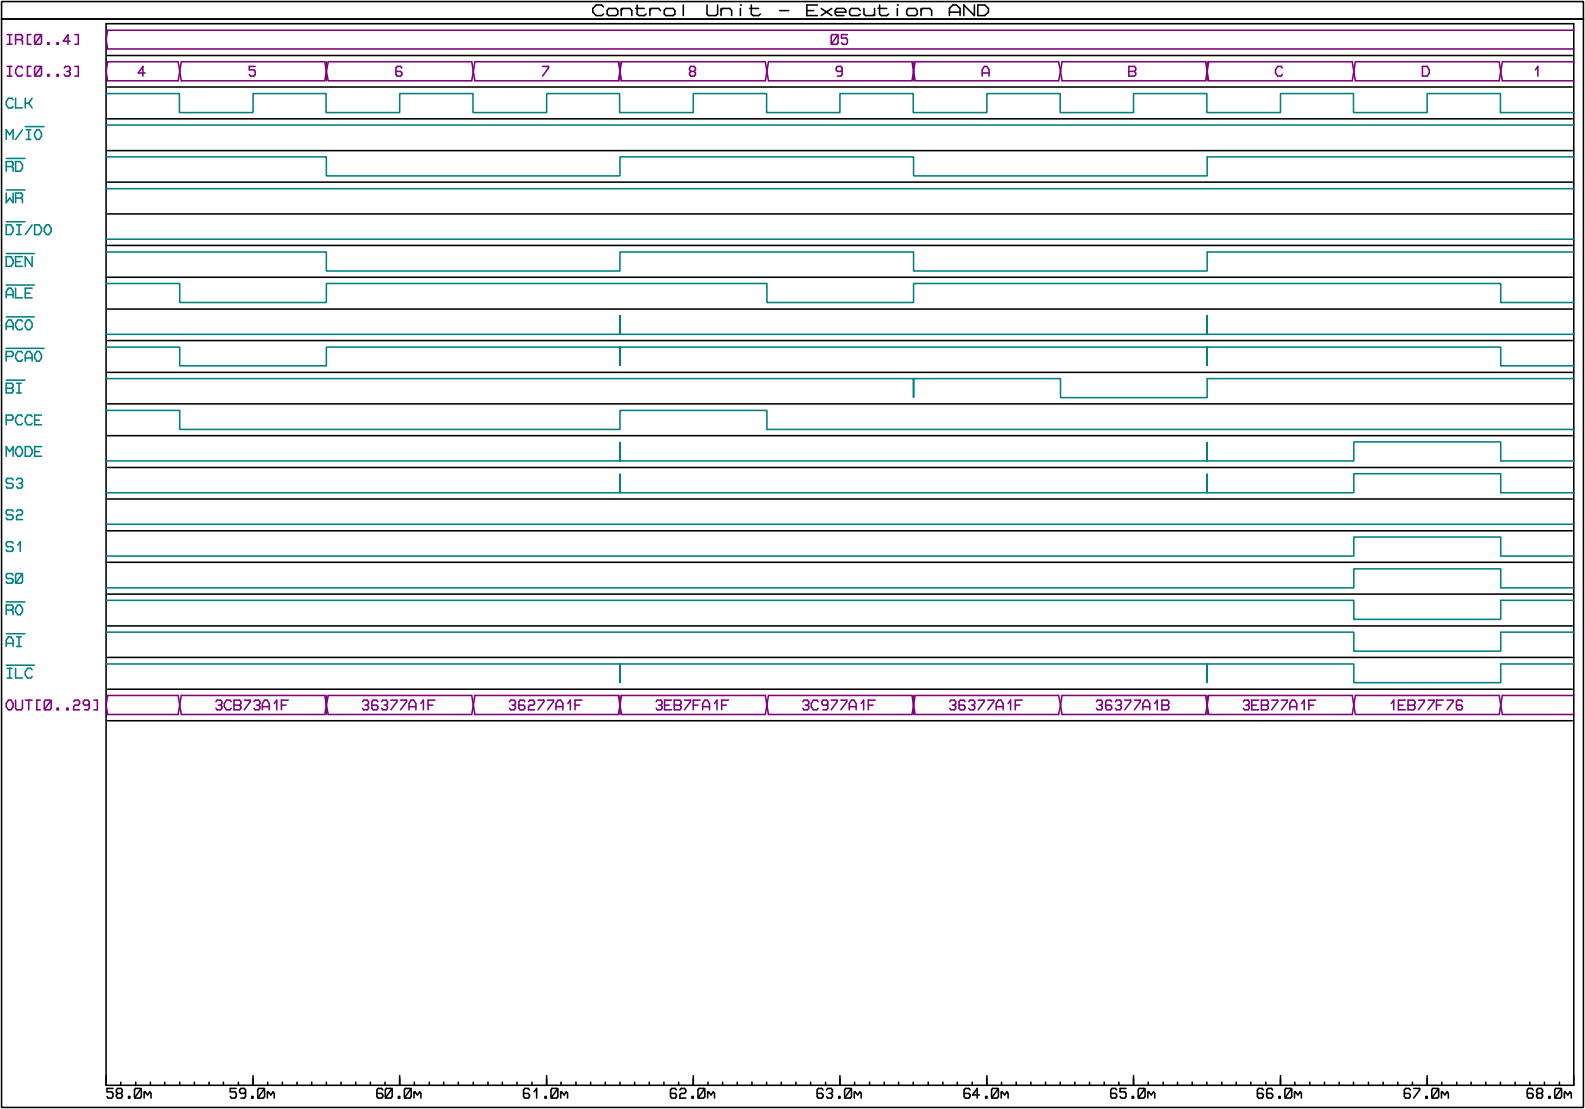
[picture p36: page 10]

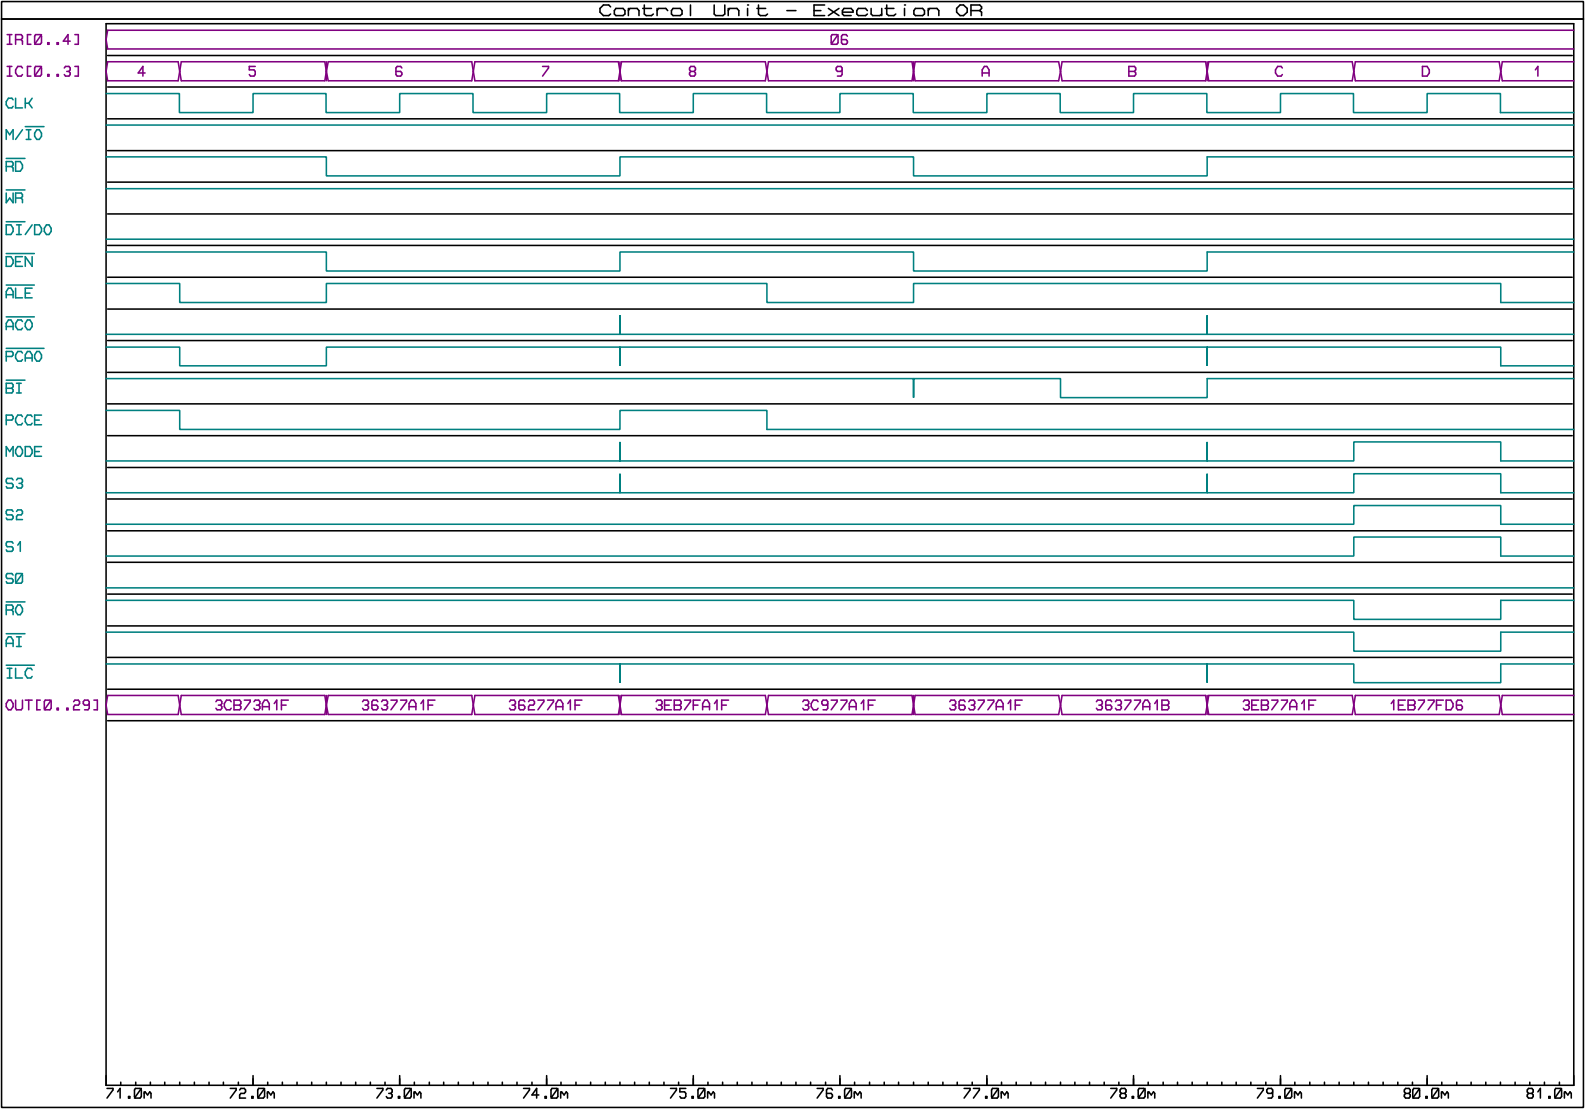
[picture p37: page 11]

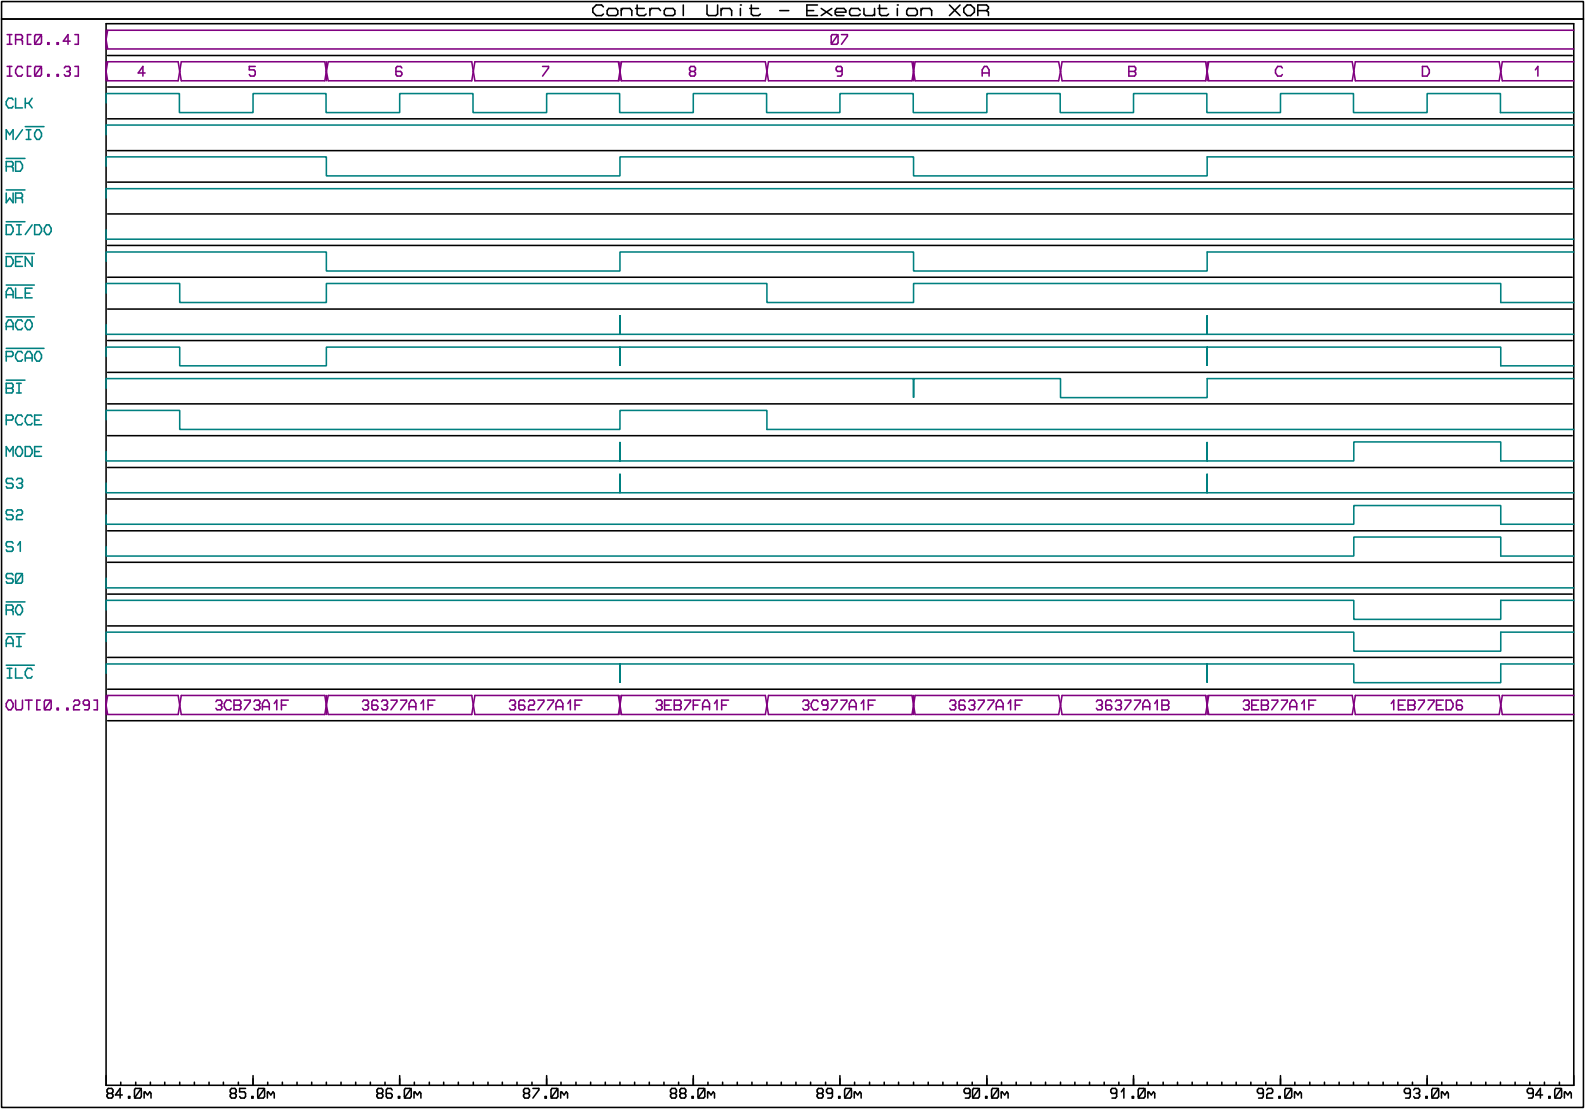
[picture p38: page 12]

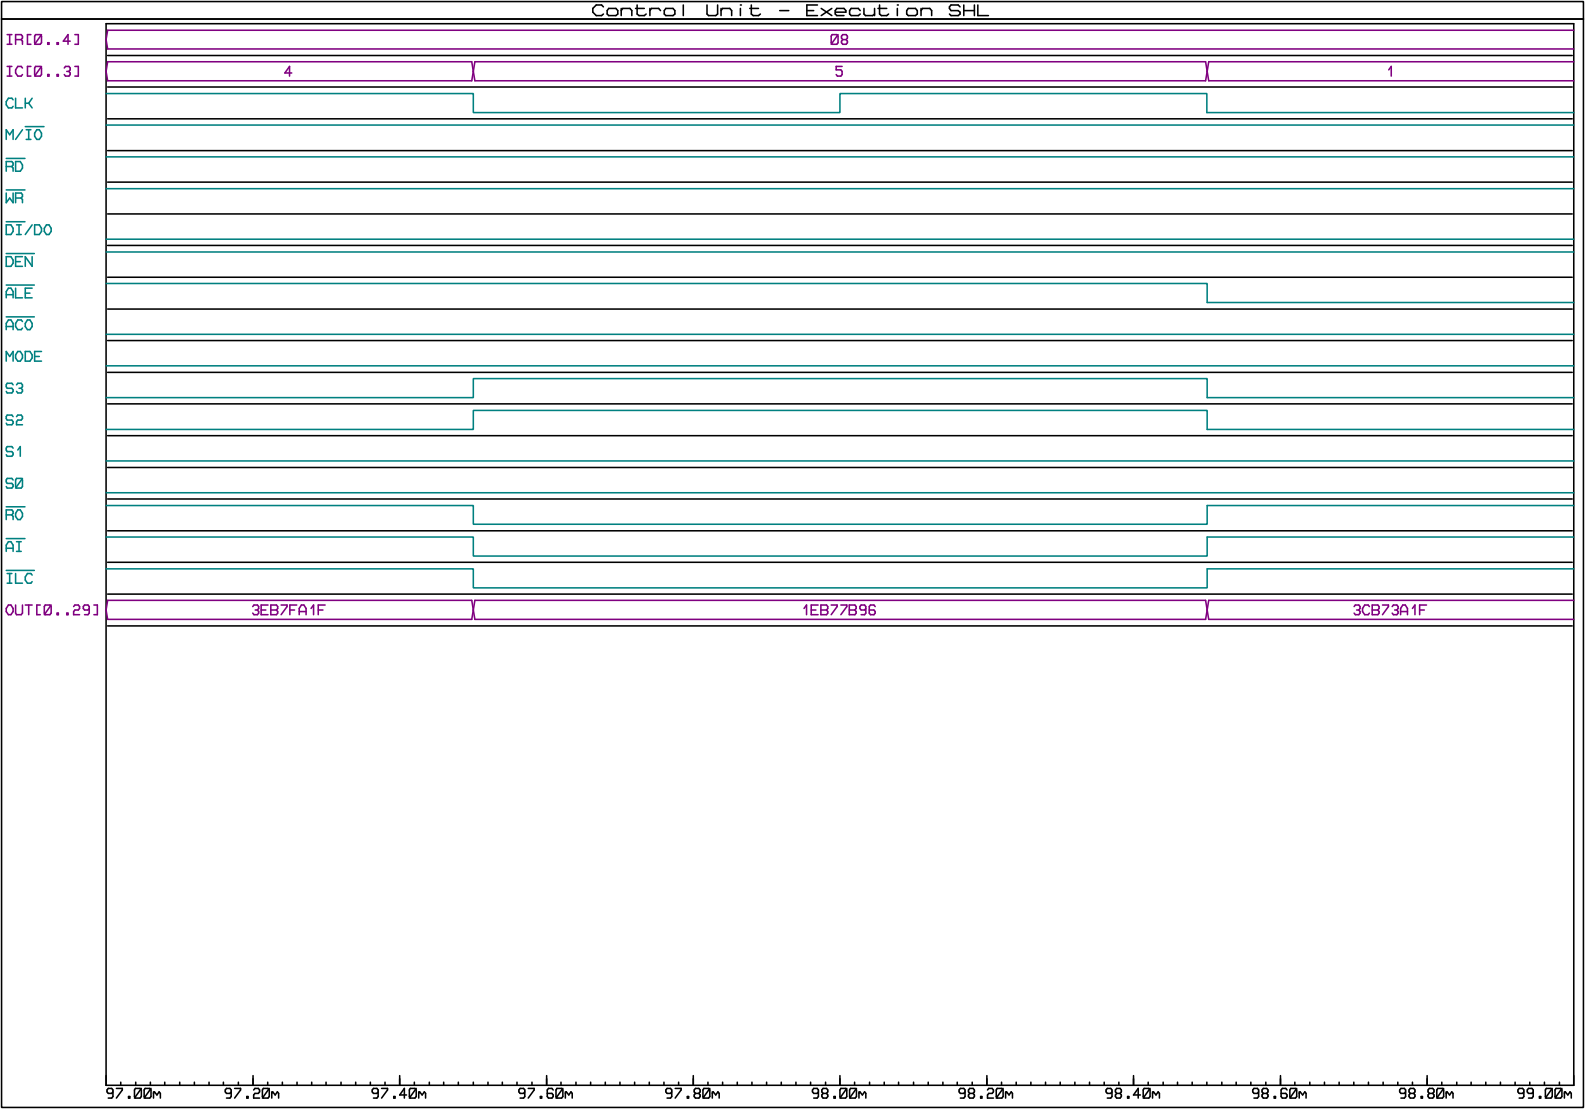
[picture p39: page 13]

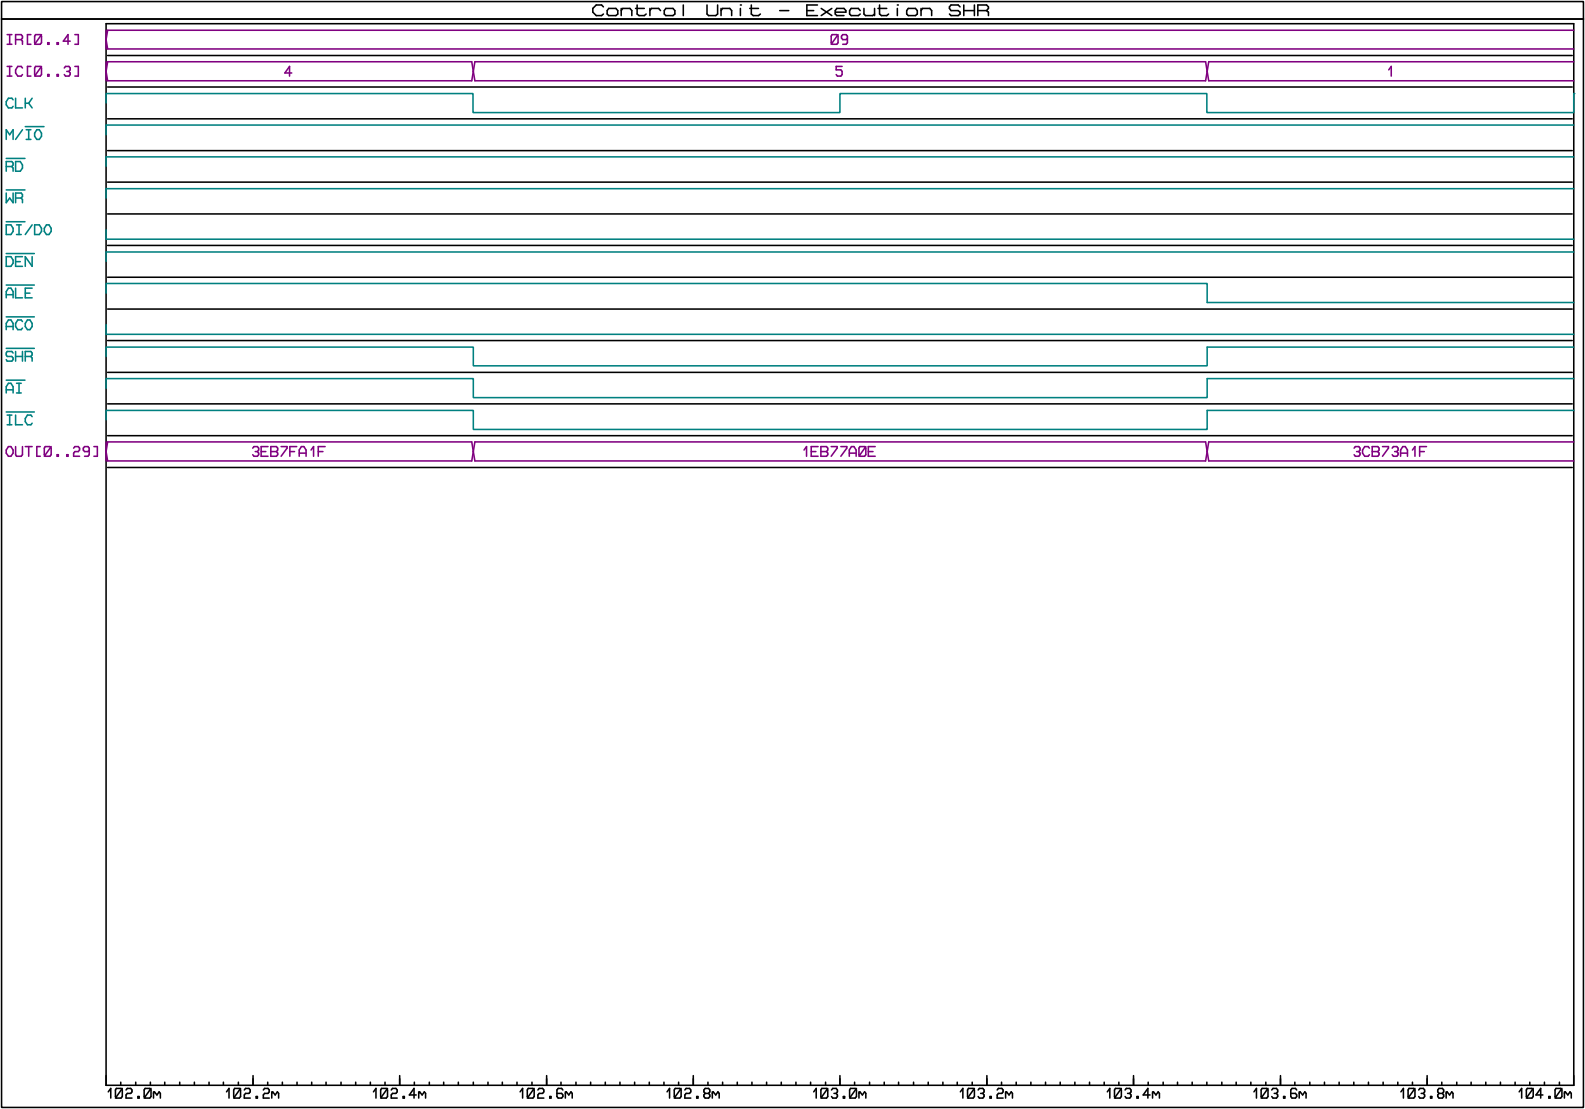
[picture p40: page 14]

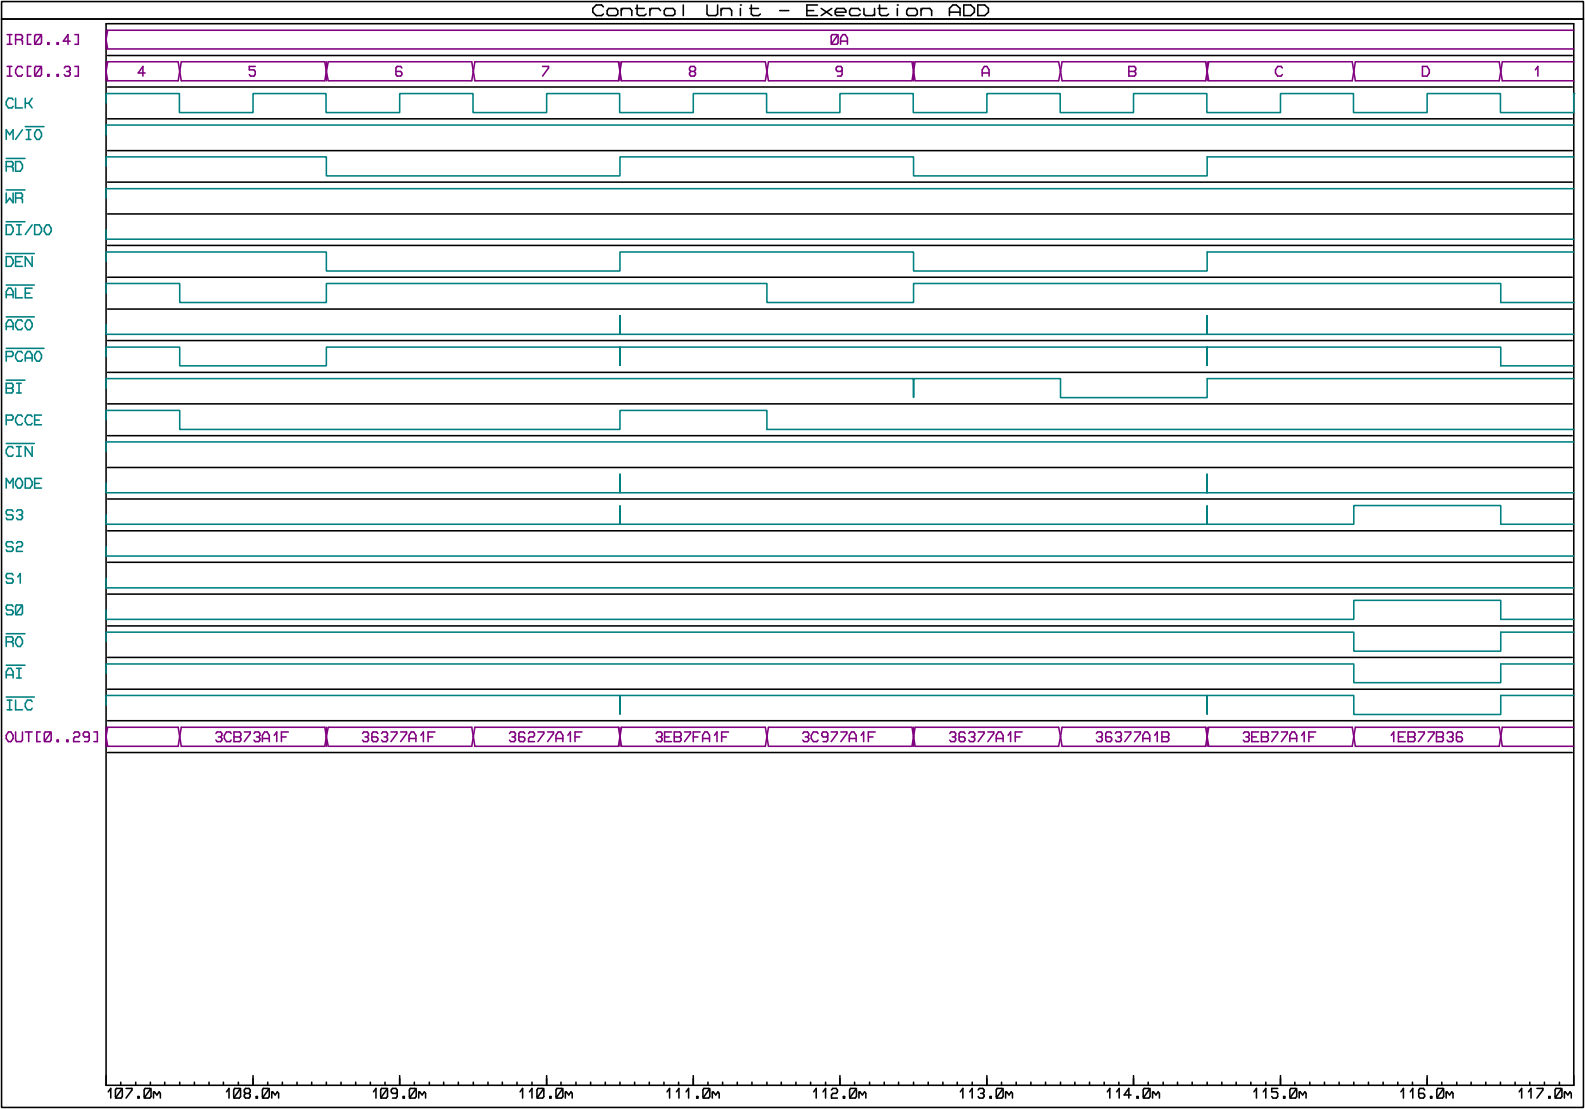
[picture p41: page 15]

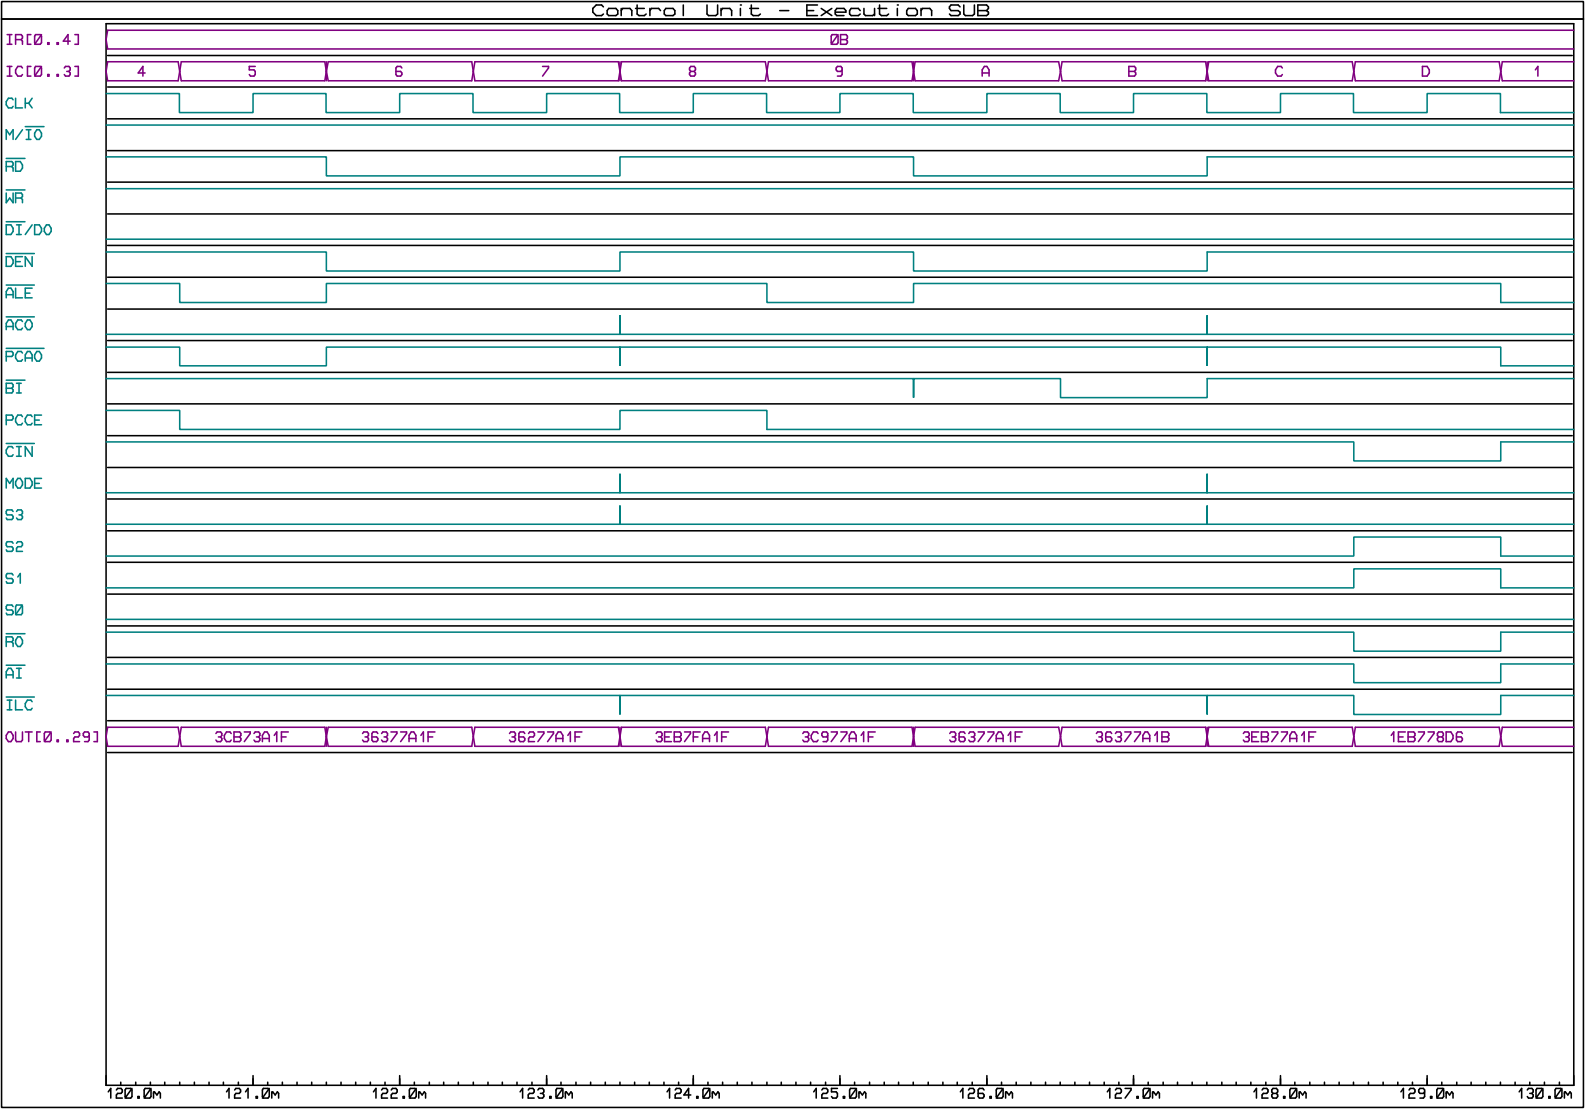
[picture p42: page 16]

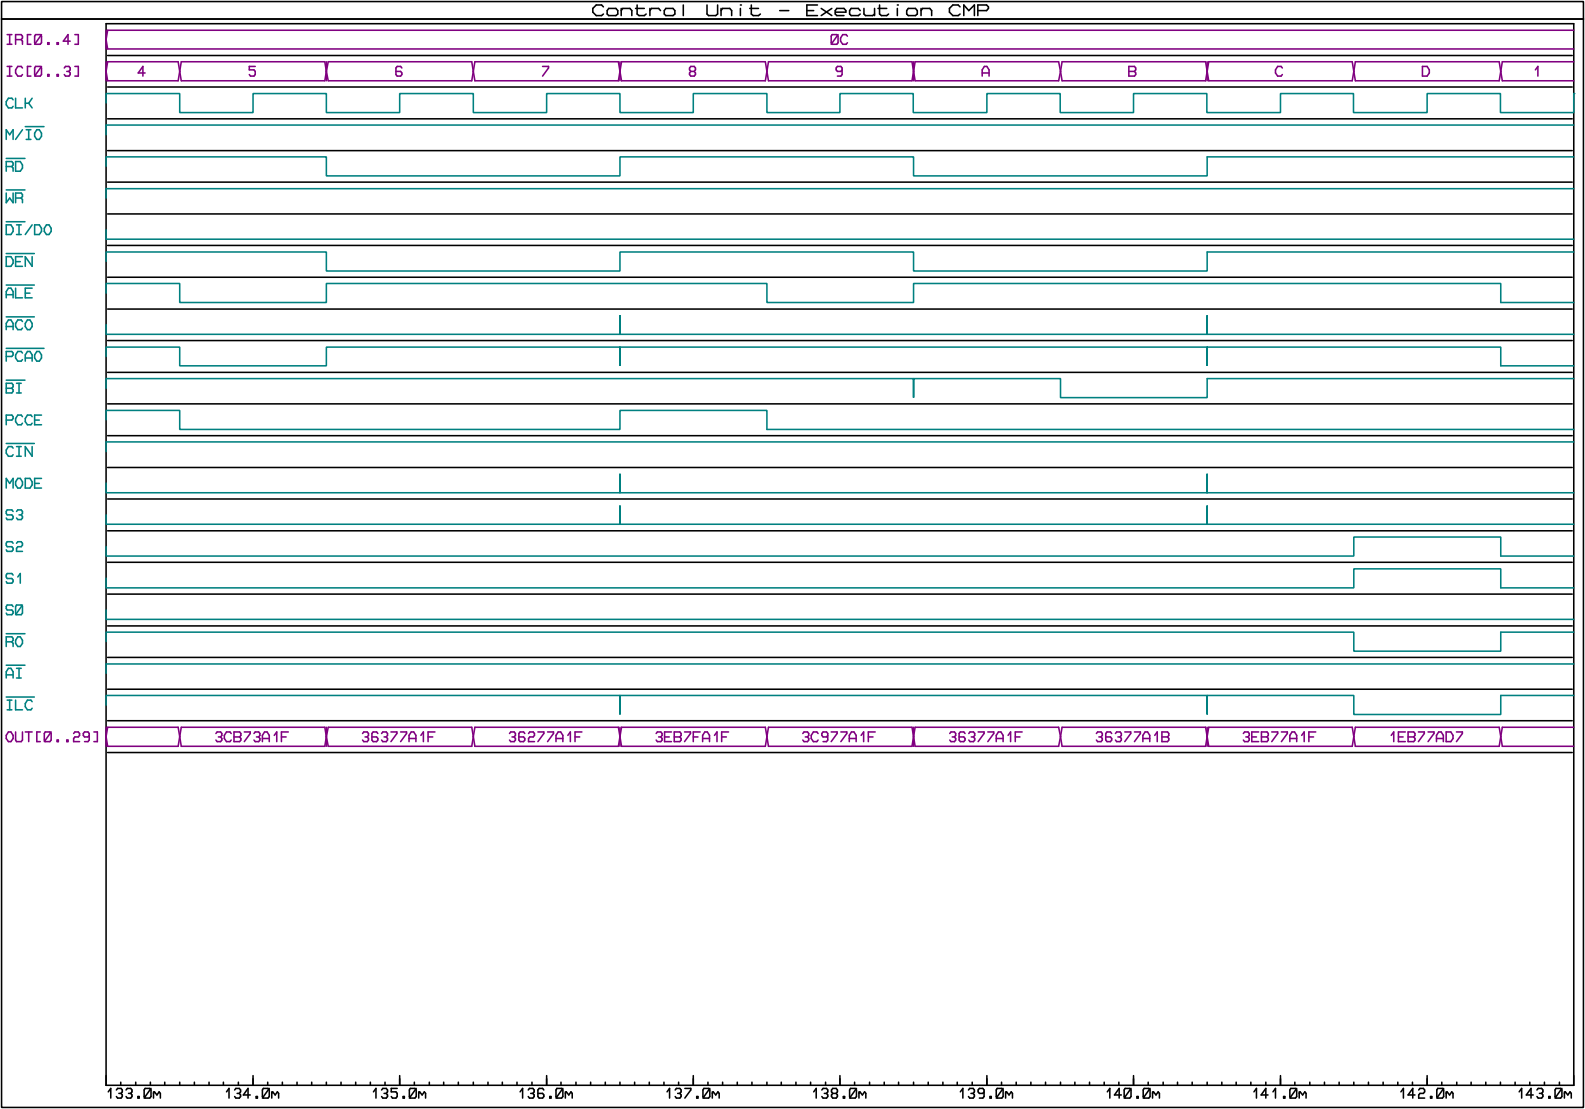
[picture p43: page 17]

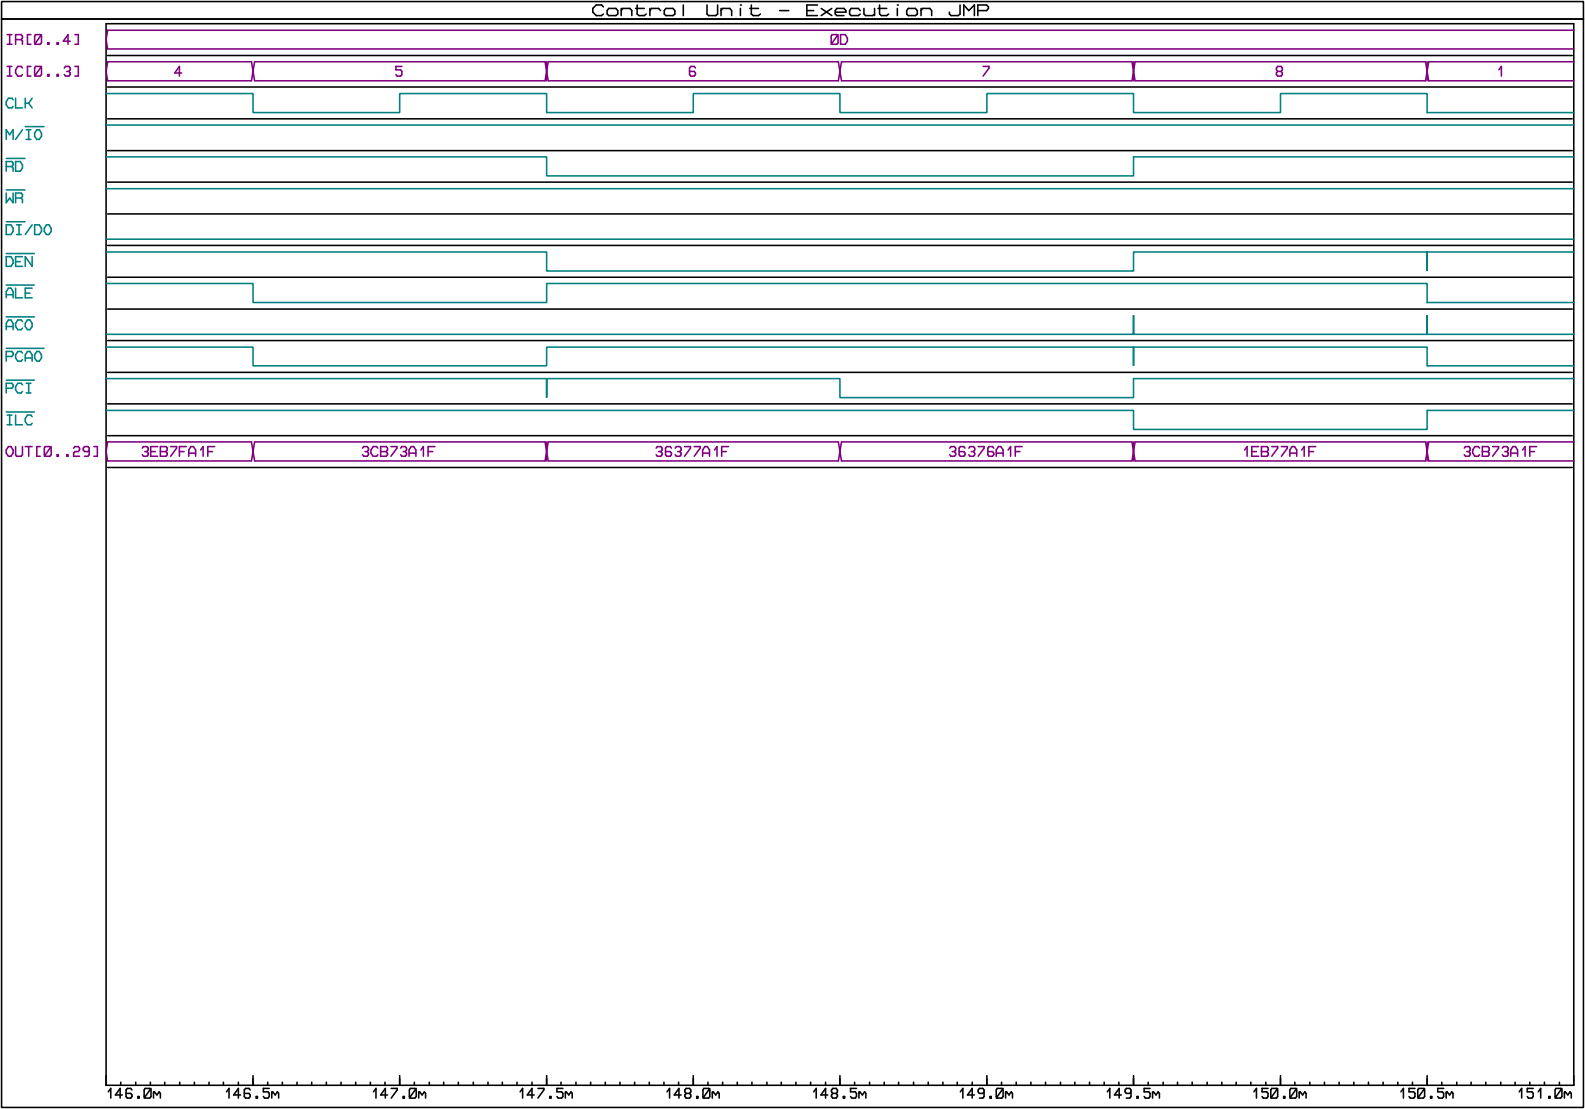
[picture p44: page 18]

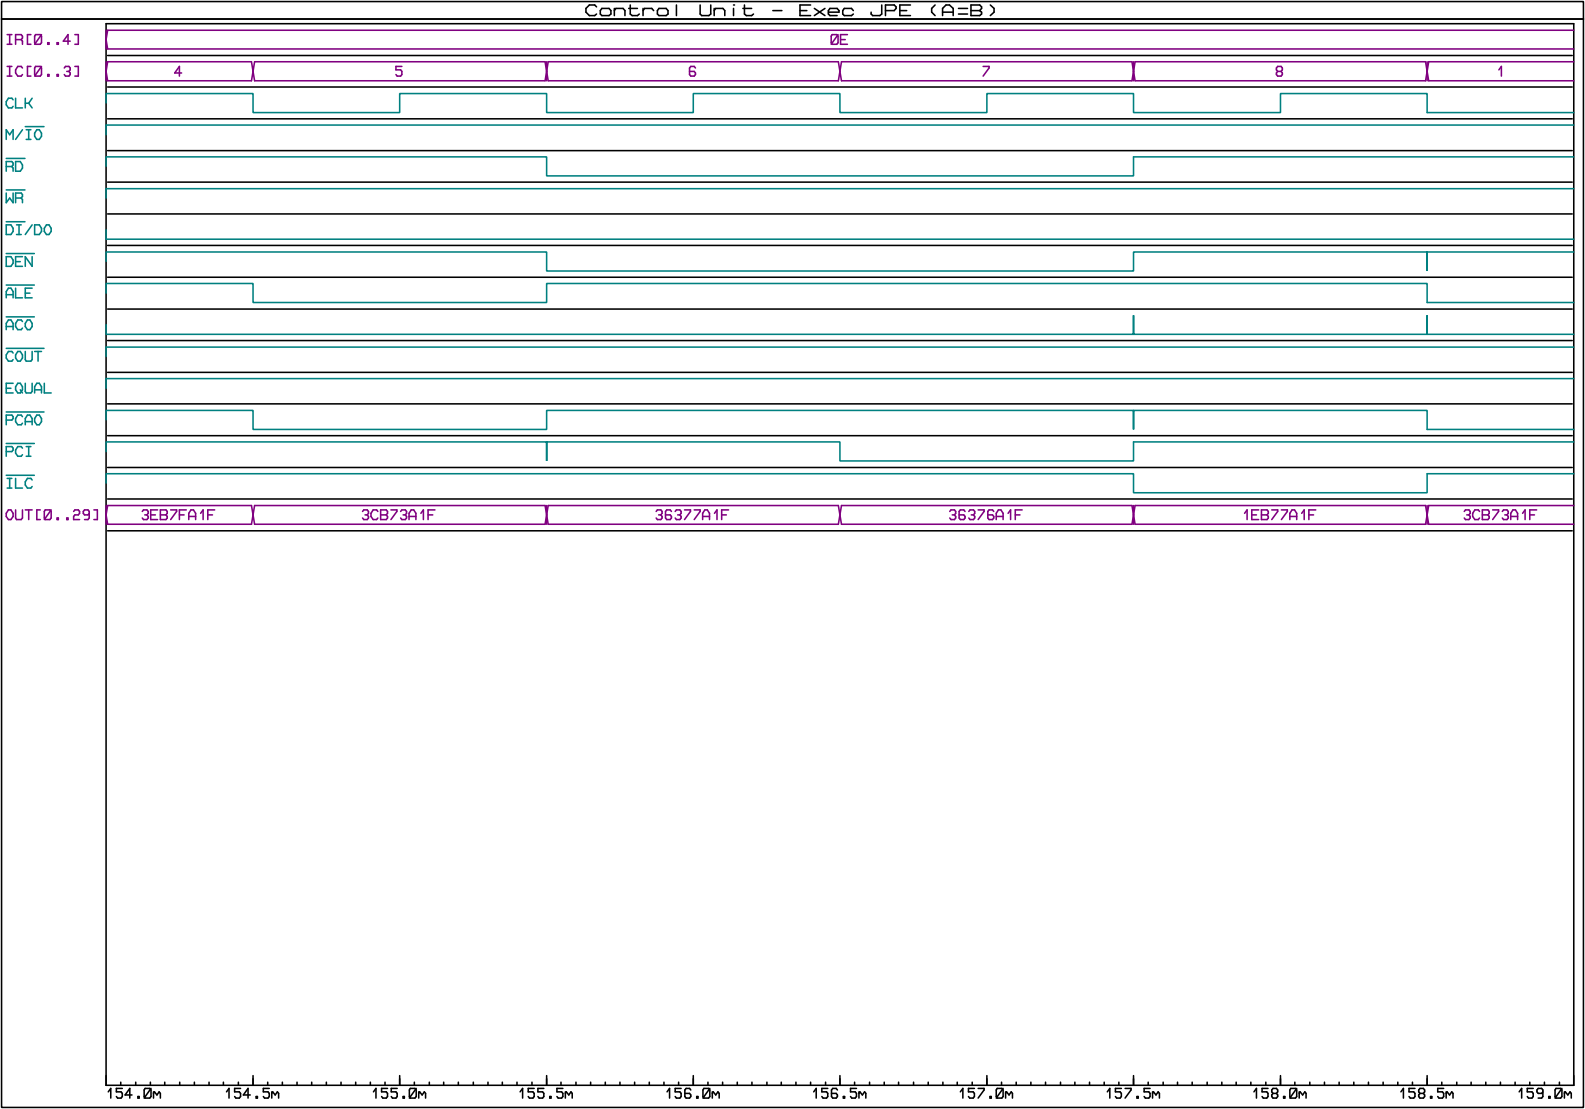
[picture p45: page 19]

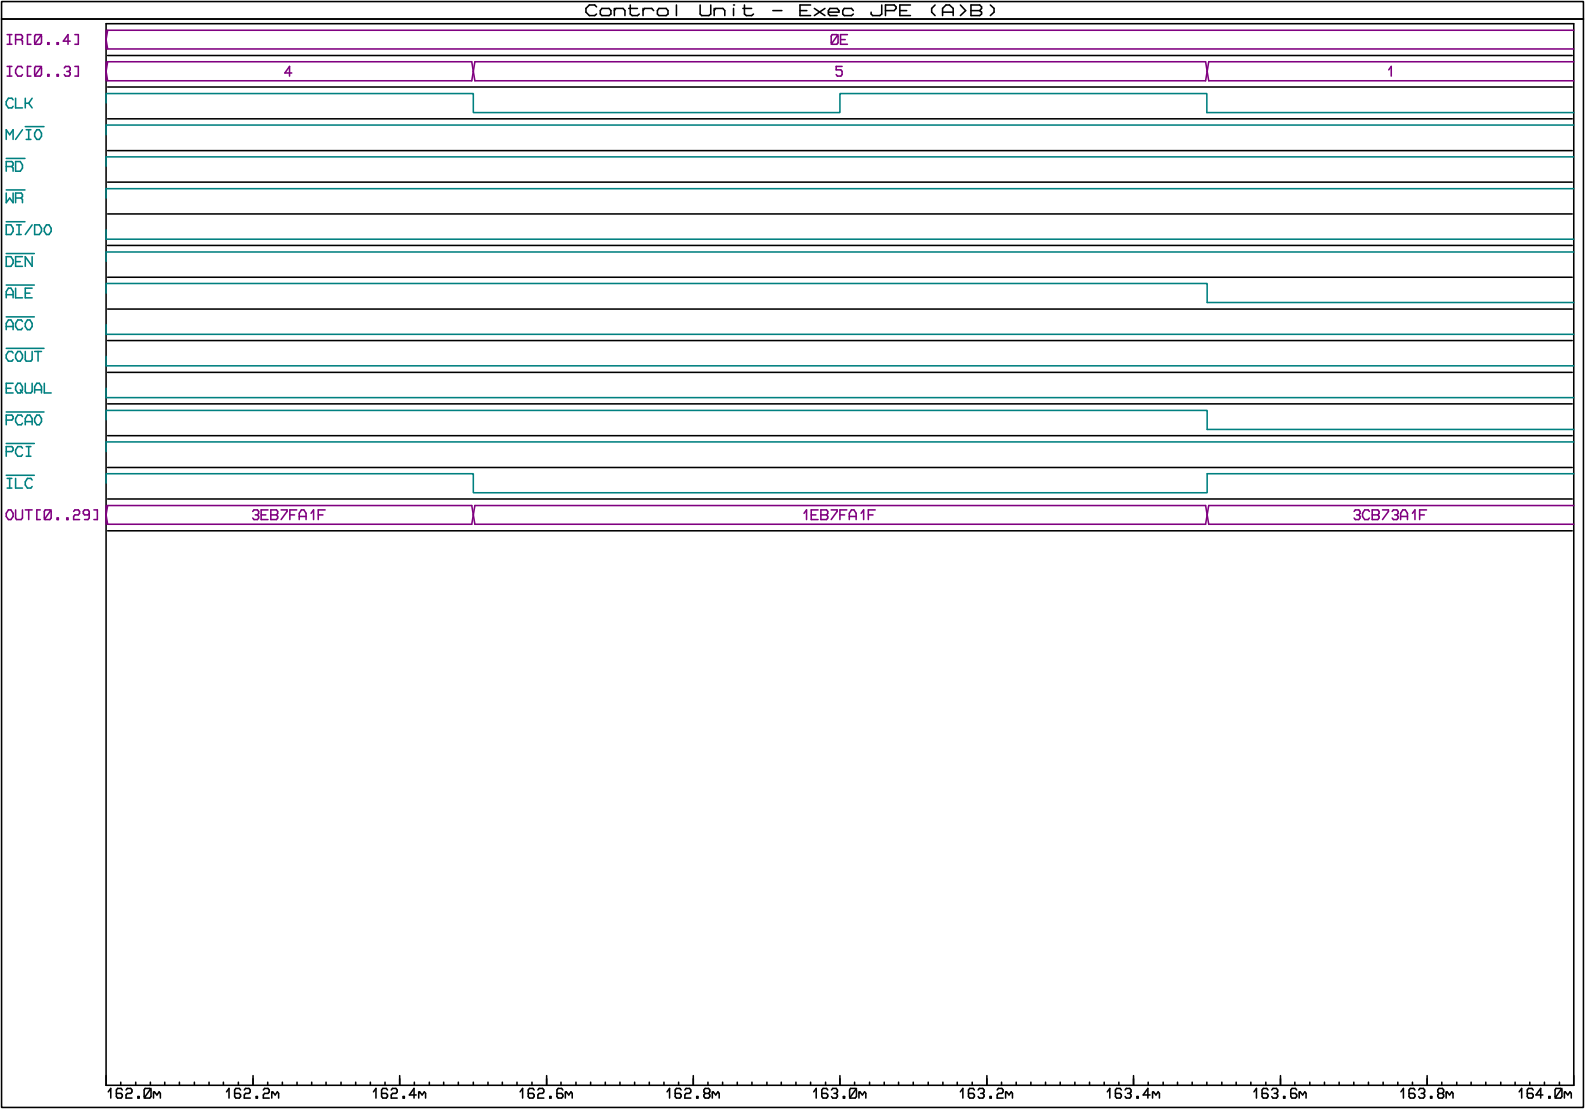
[picture p46: page 20]

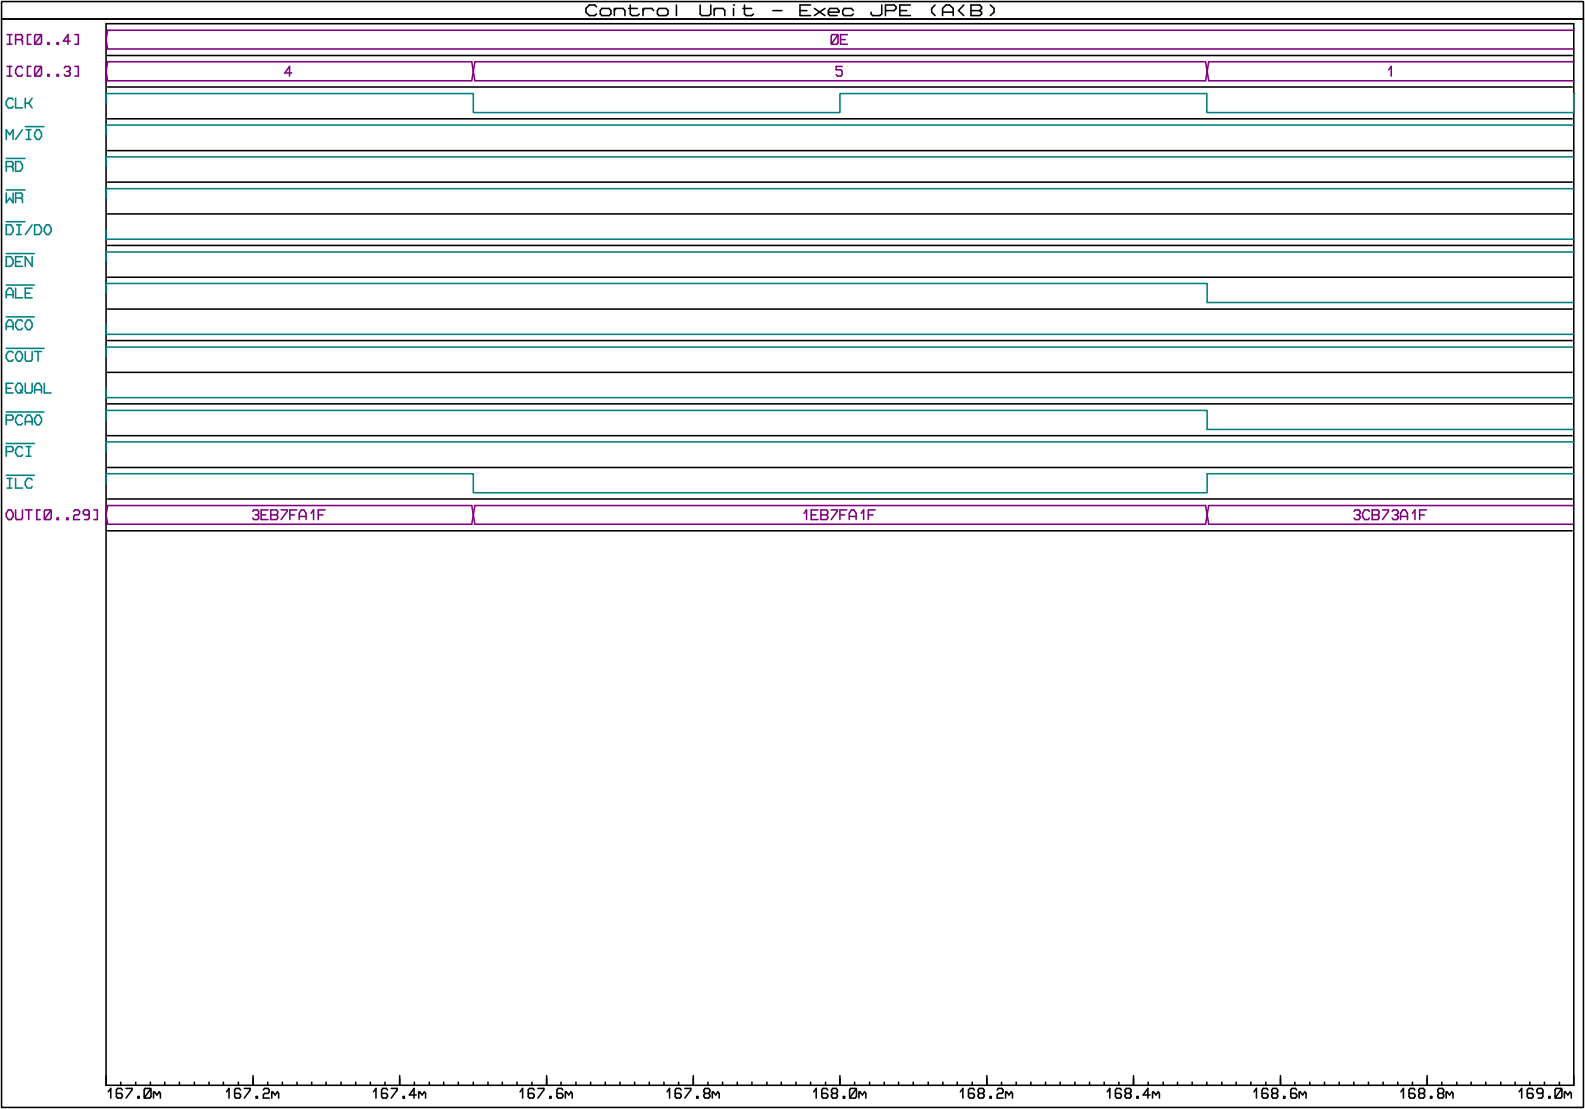
[picture p47: page 21]

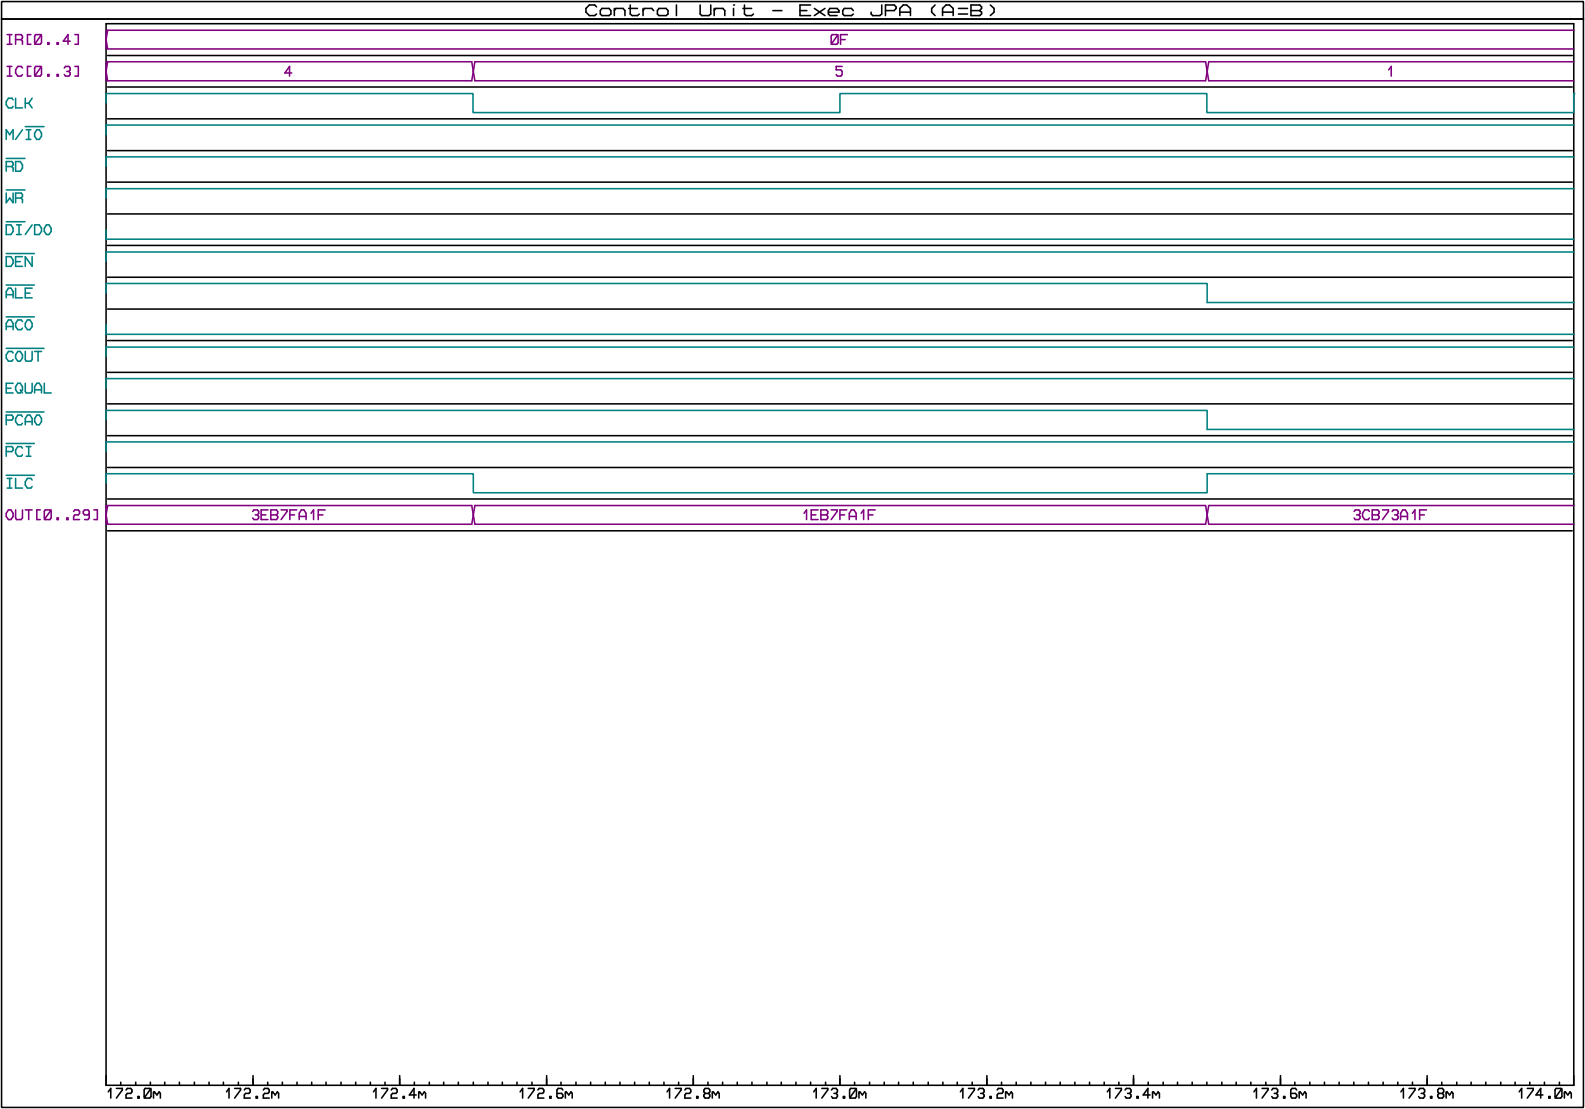
[picture p48: page 22]

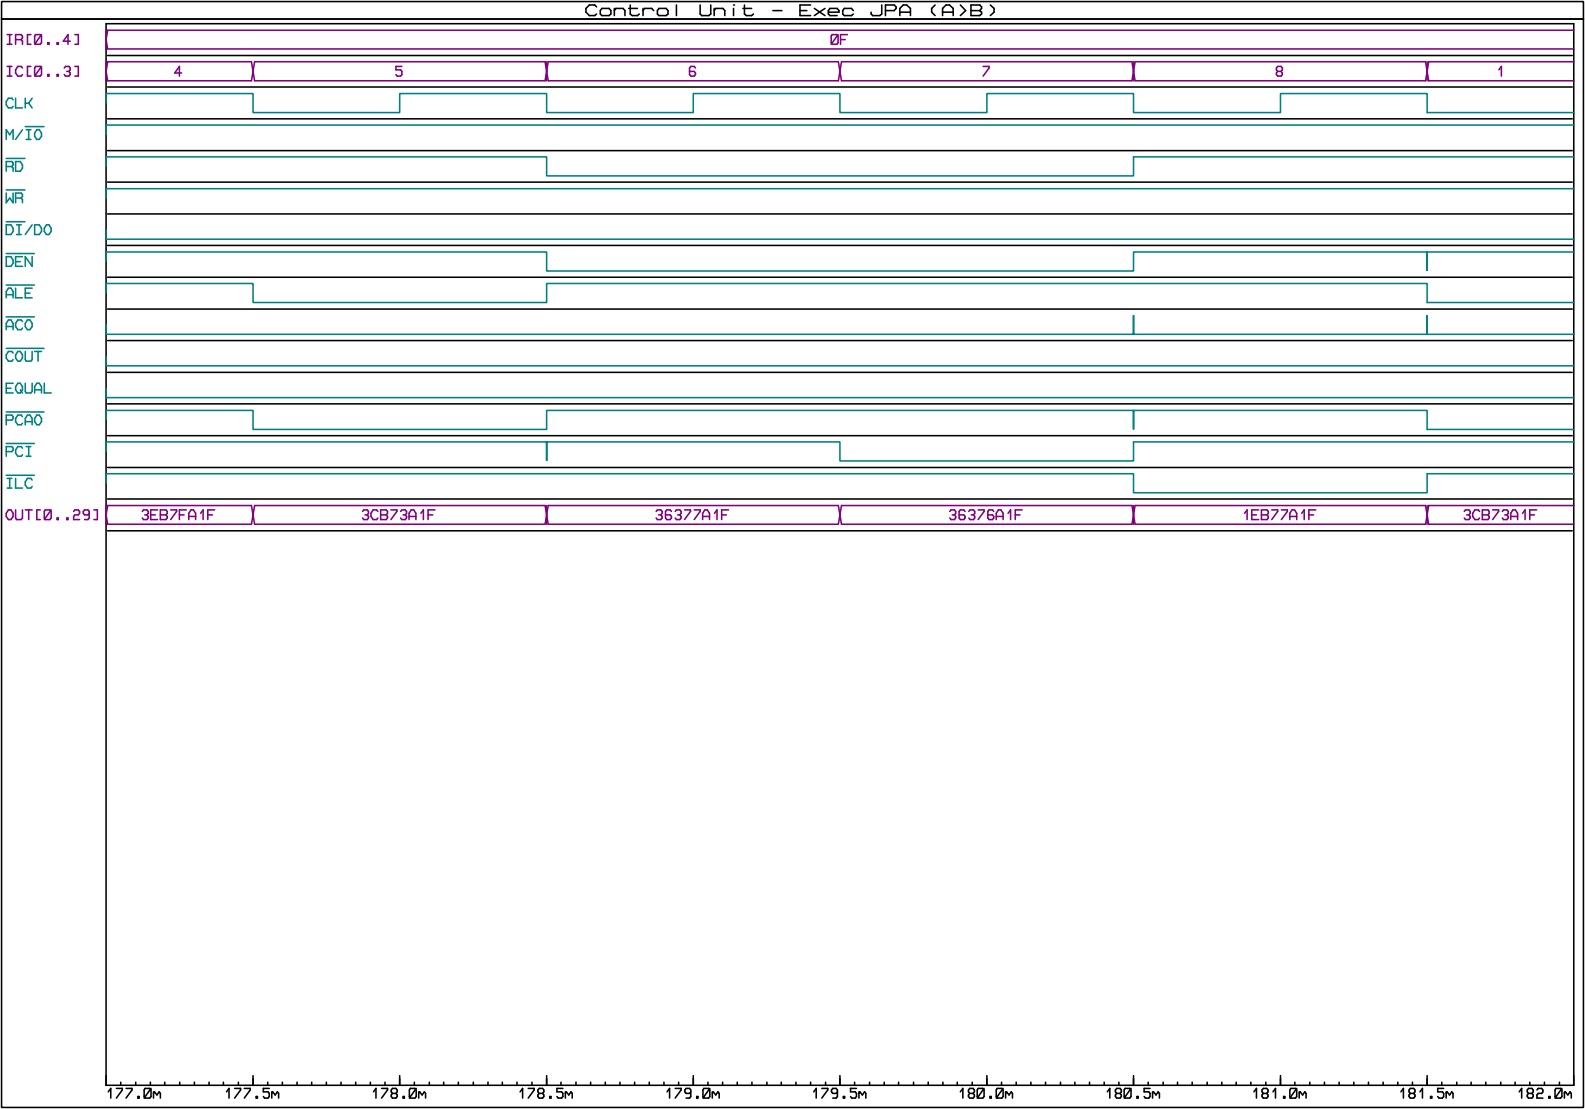
[picture p49: page 23]

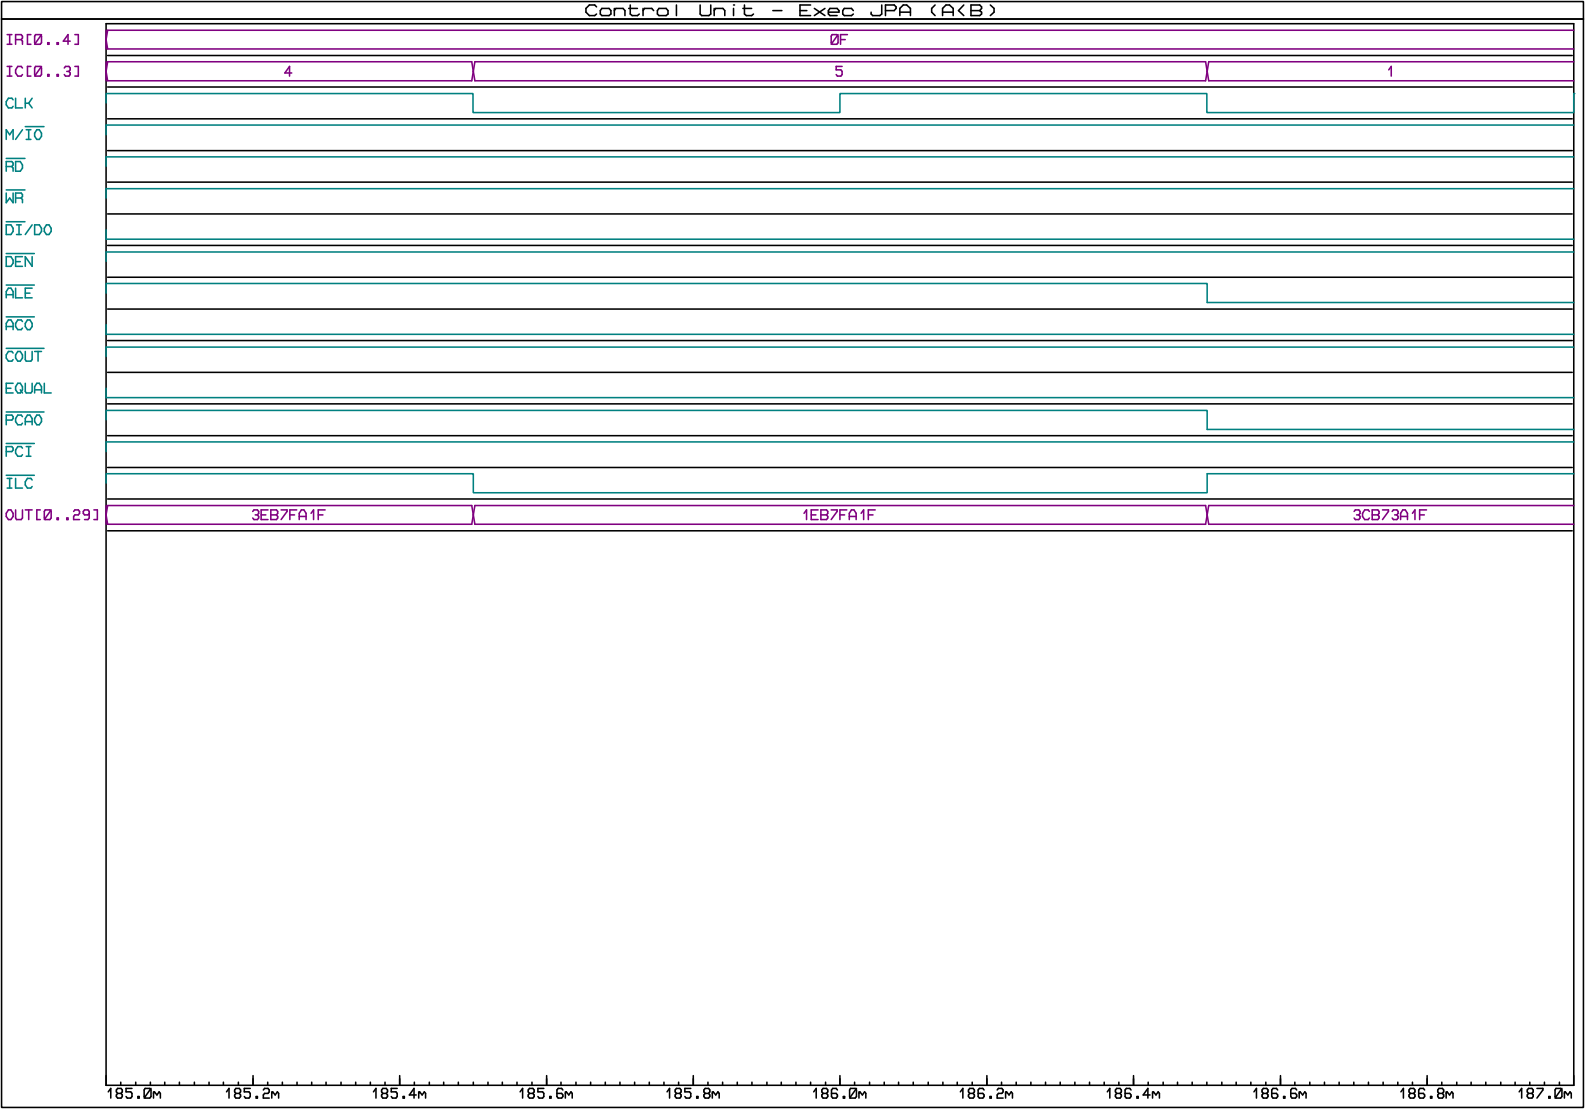
[picture p50: page 24]

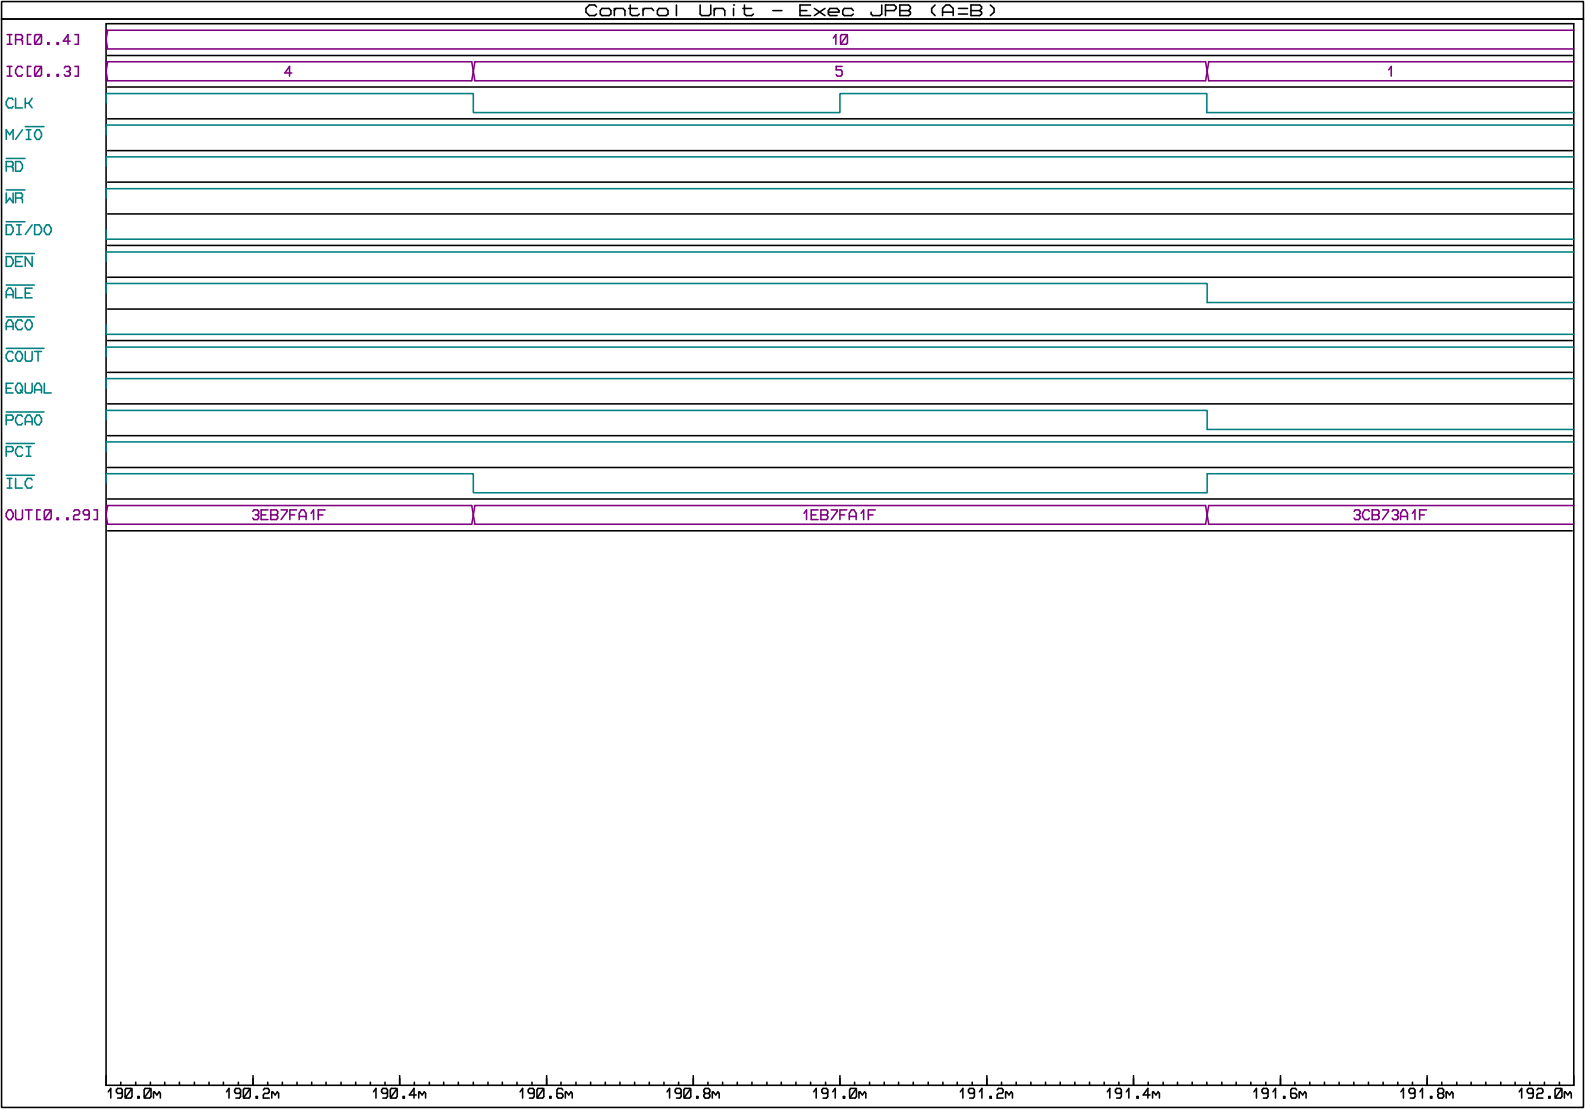
[picture p51: page 25]

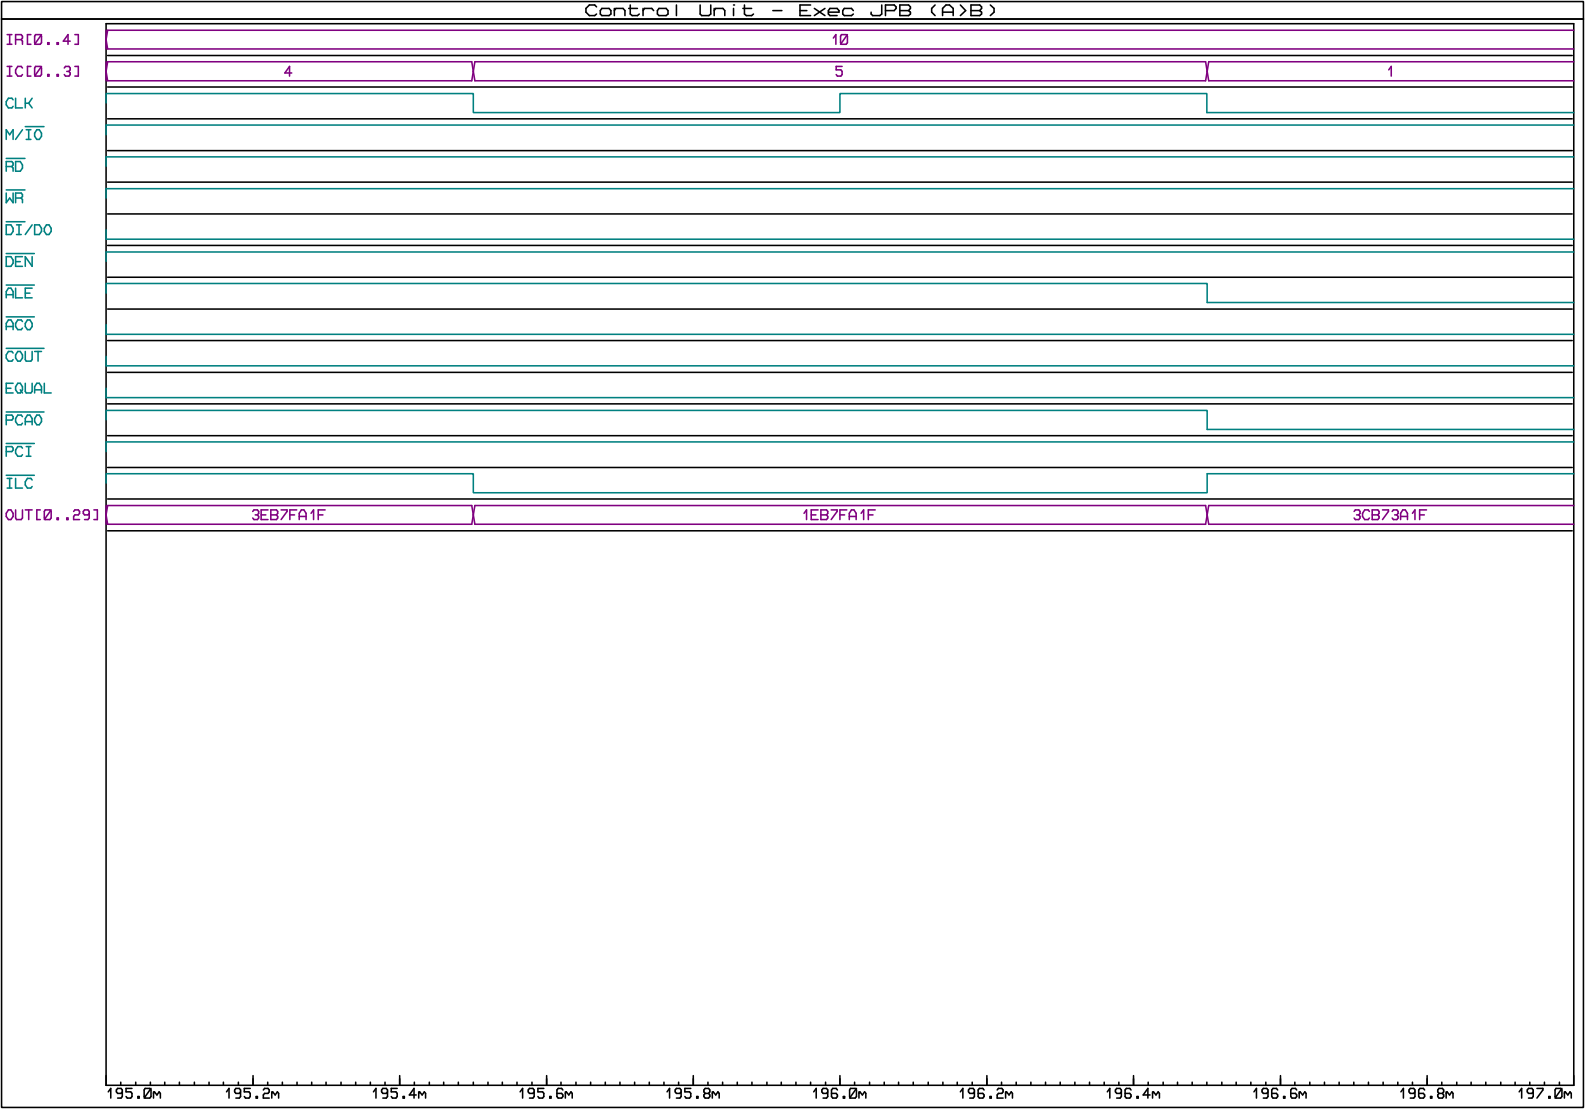
[picture p52: page 26]

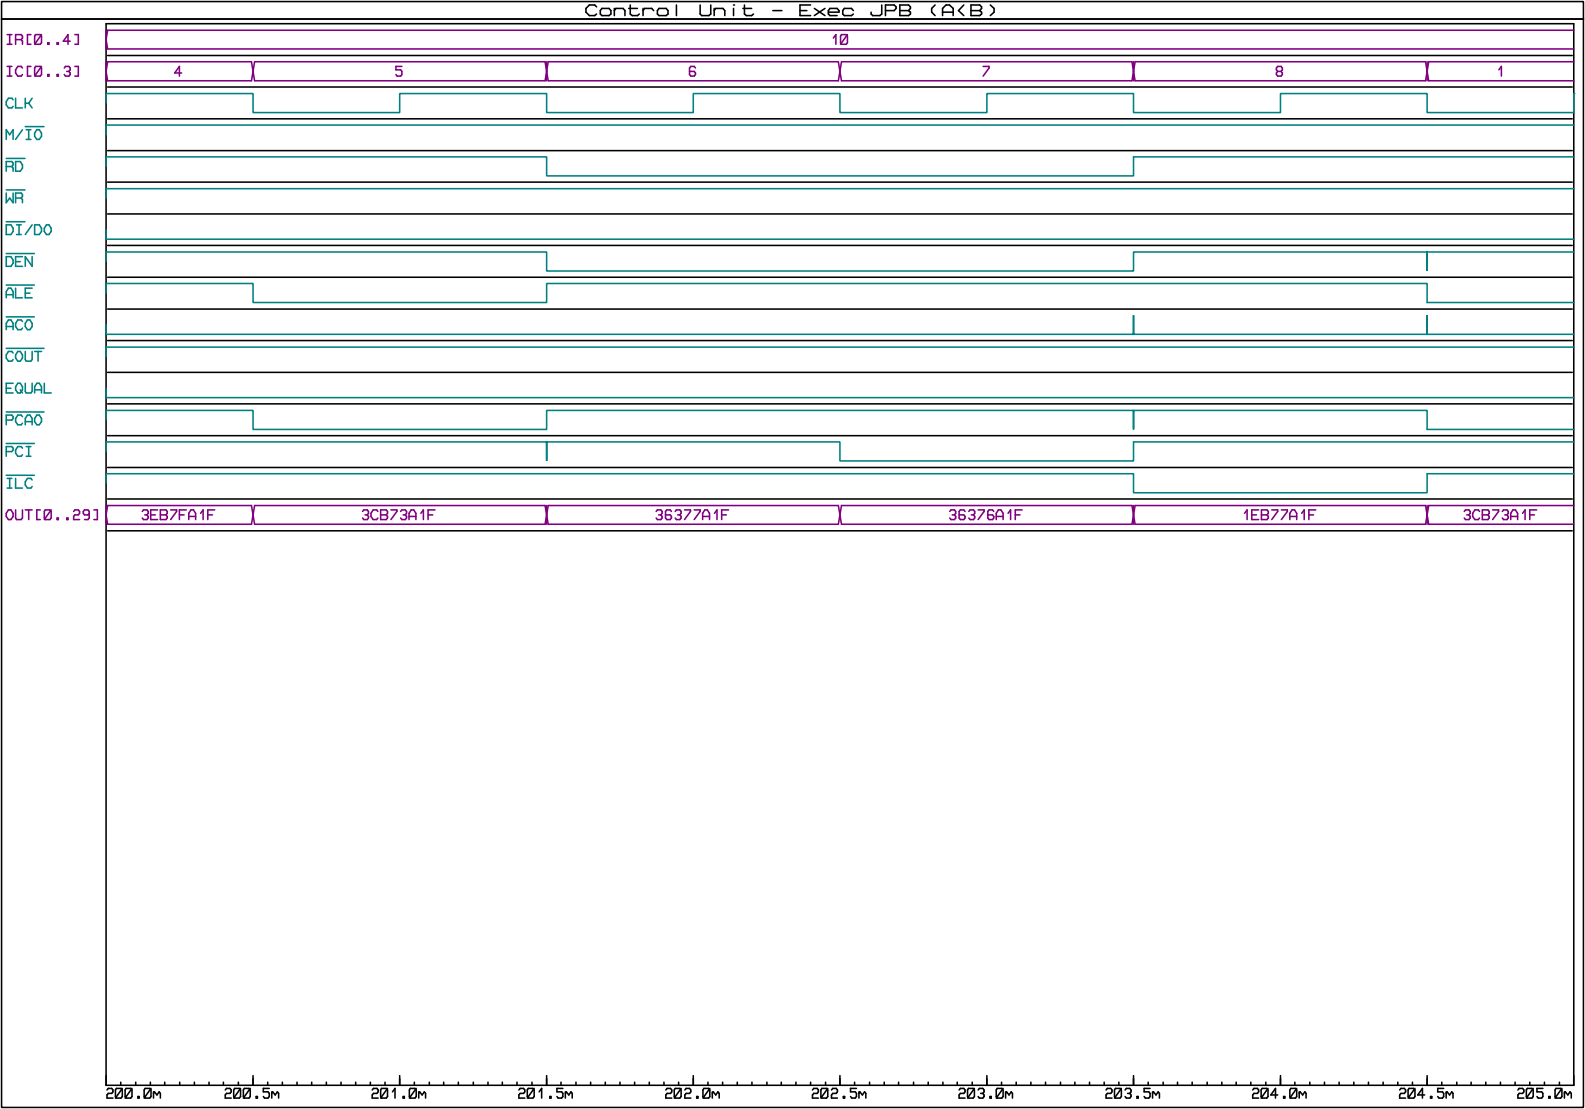
[picture p53: page 27]

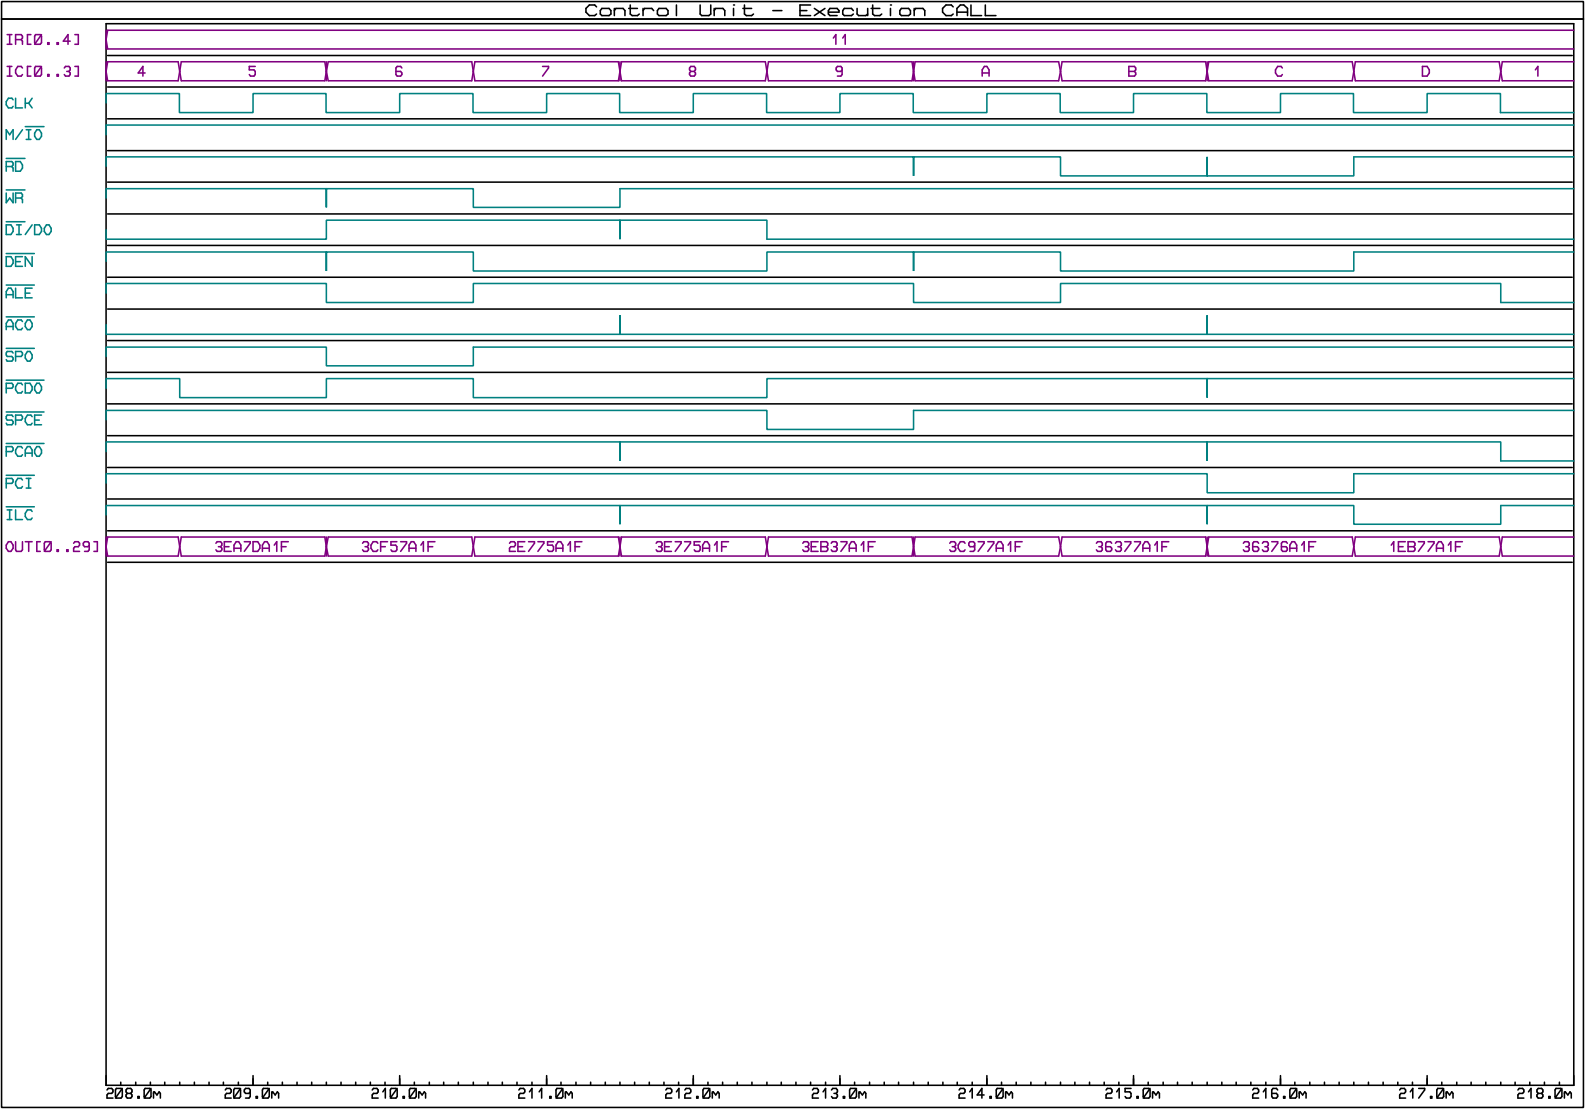
[picture p54: page 28]

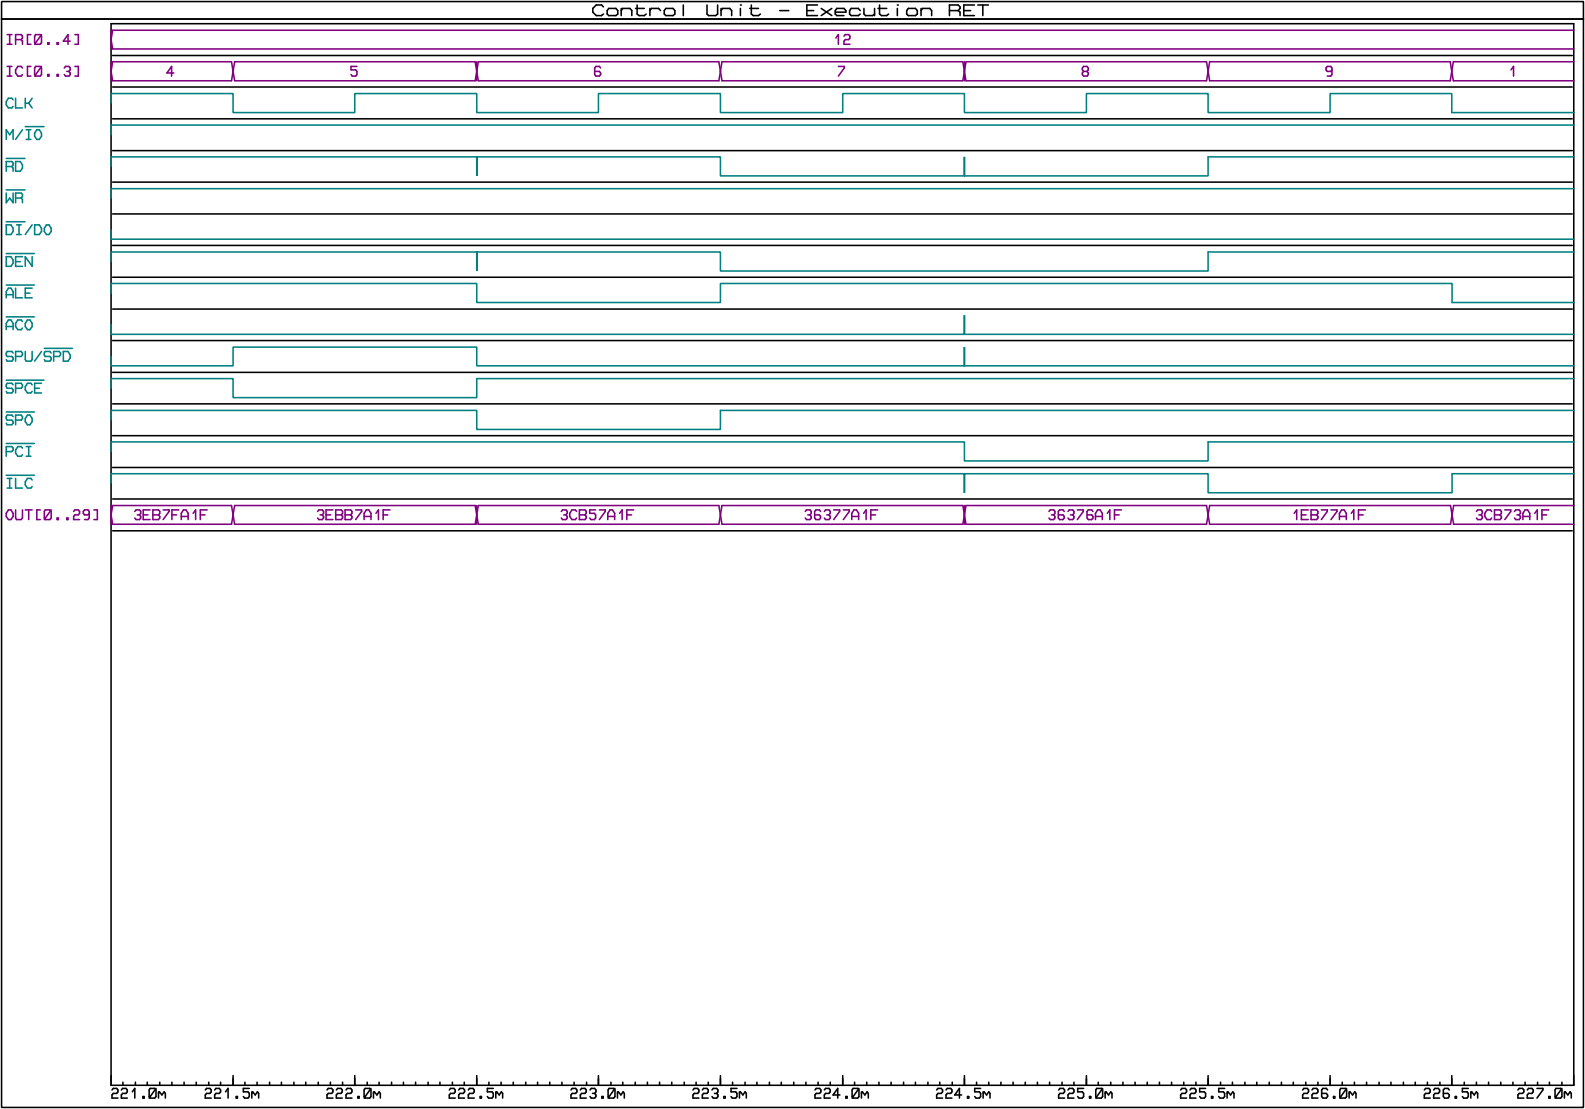
[picture p55: page 29]

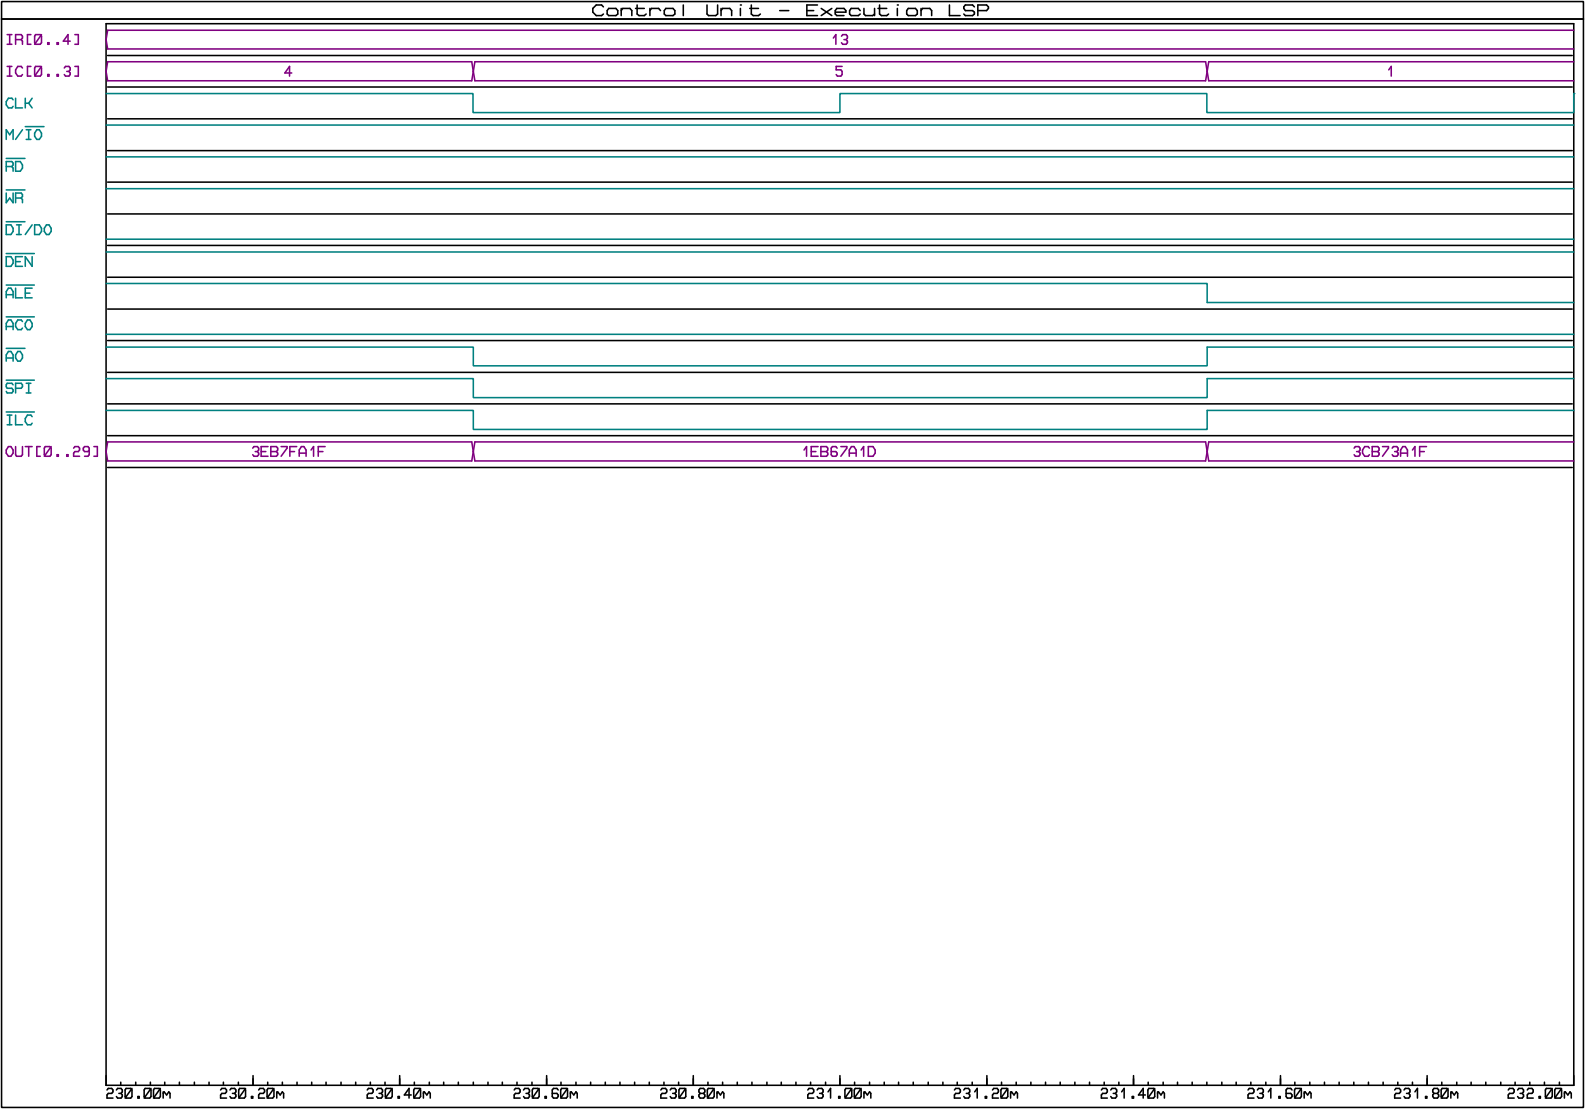
[picture p56: page 30]

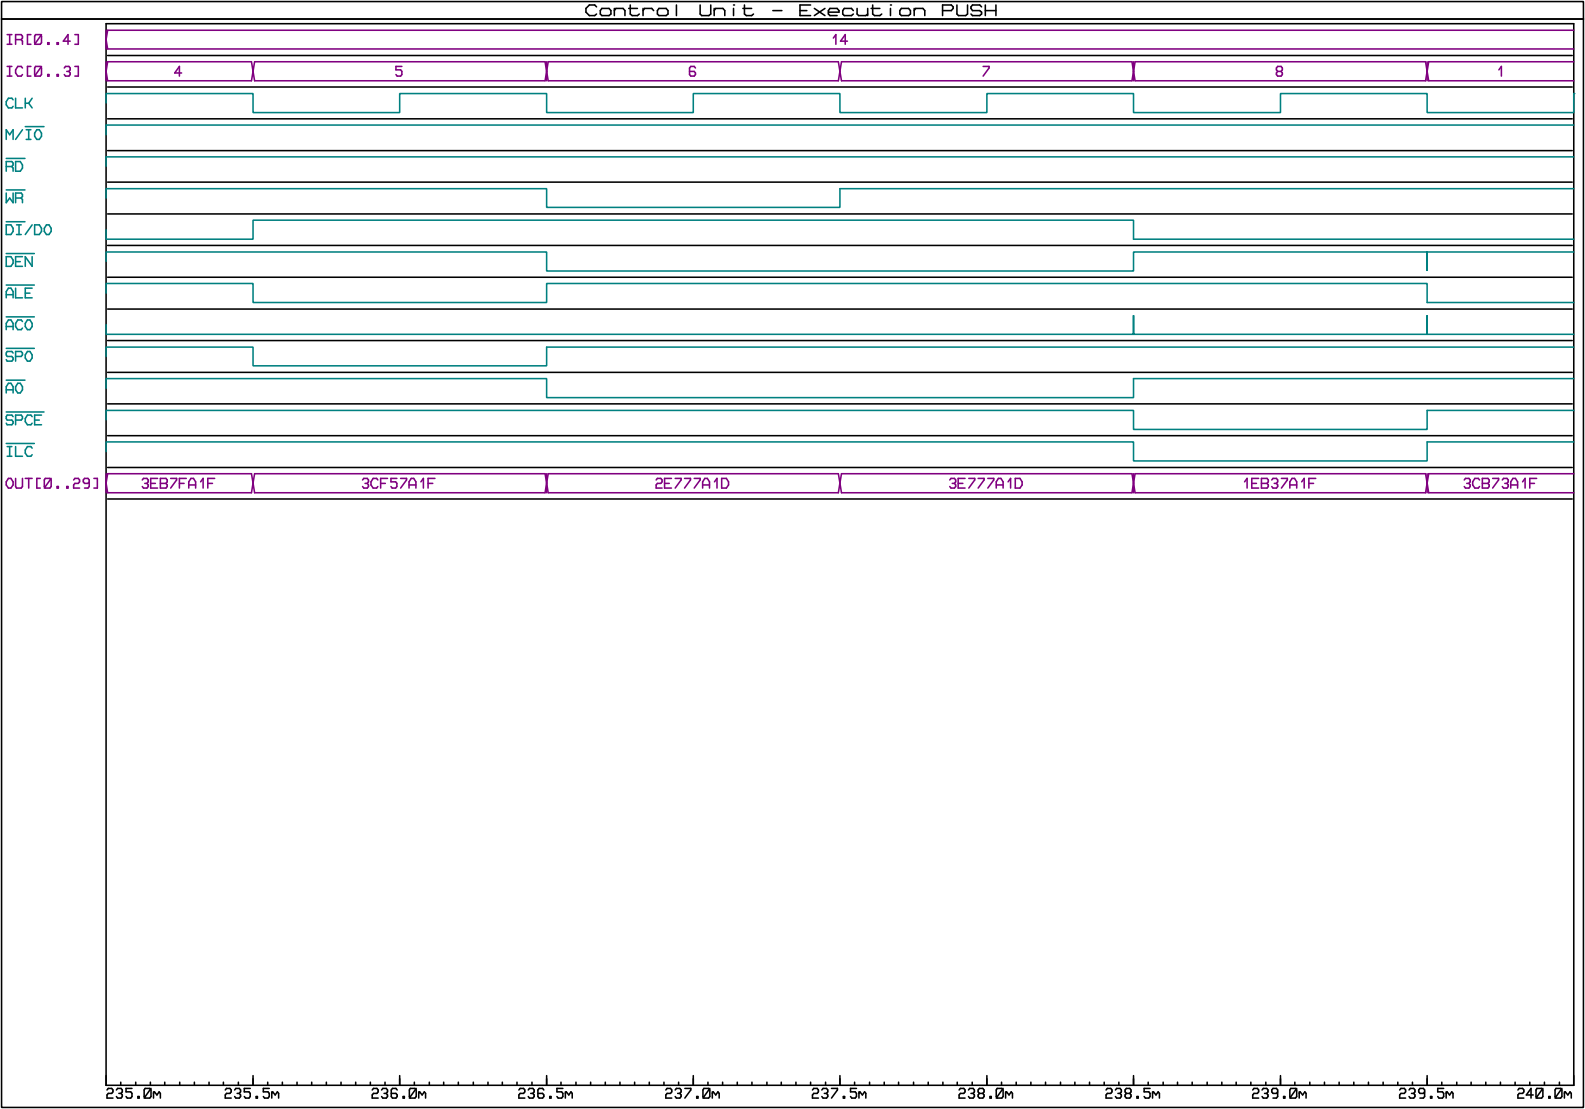
[picture p57: page 31]

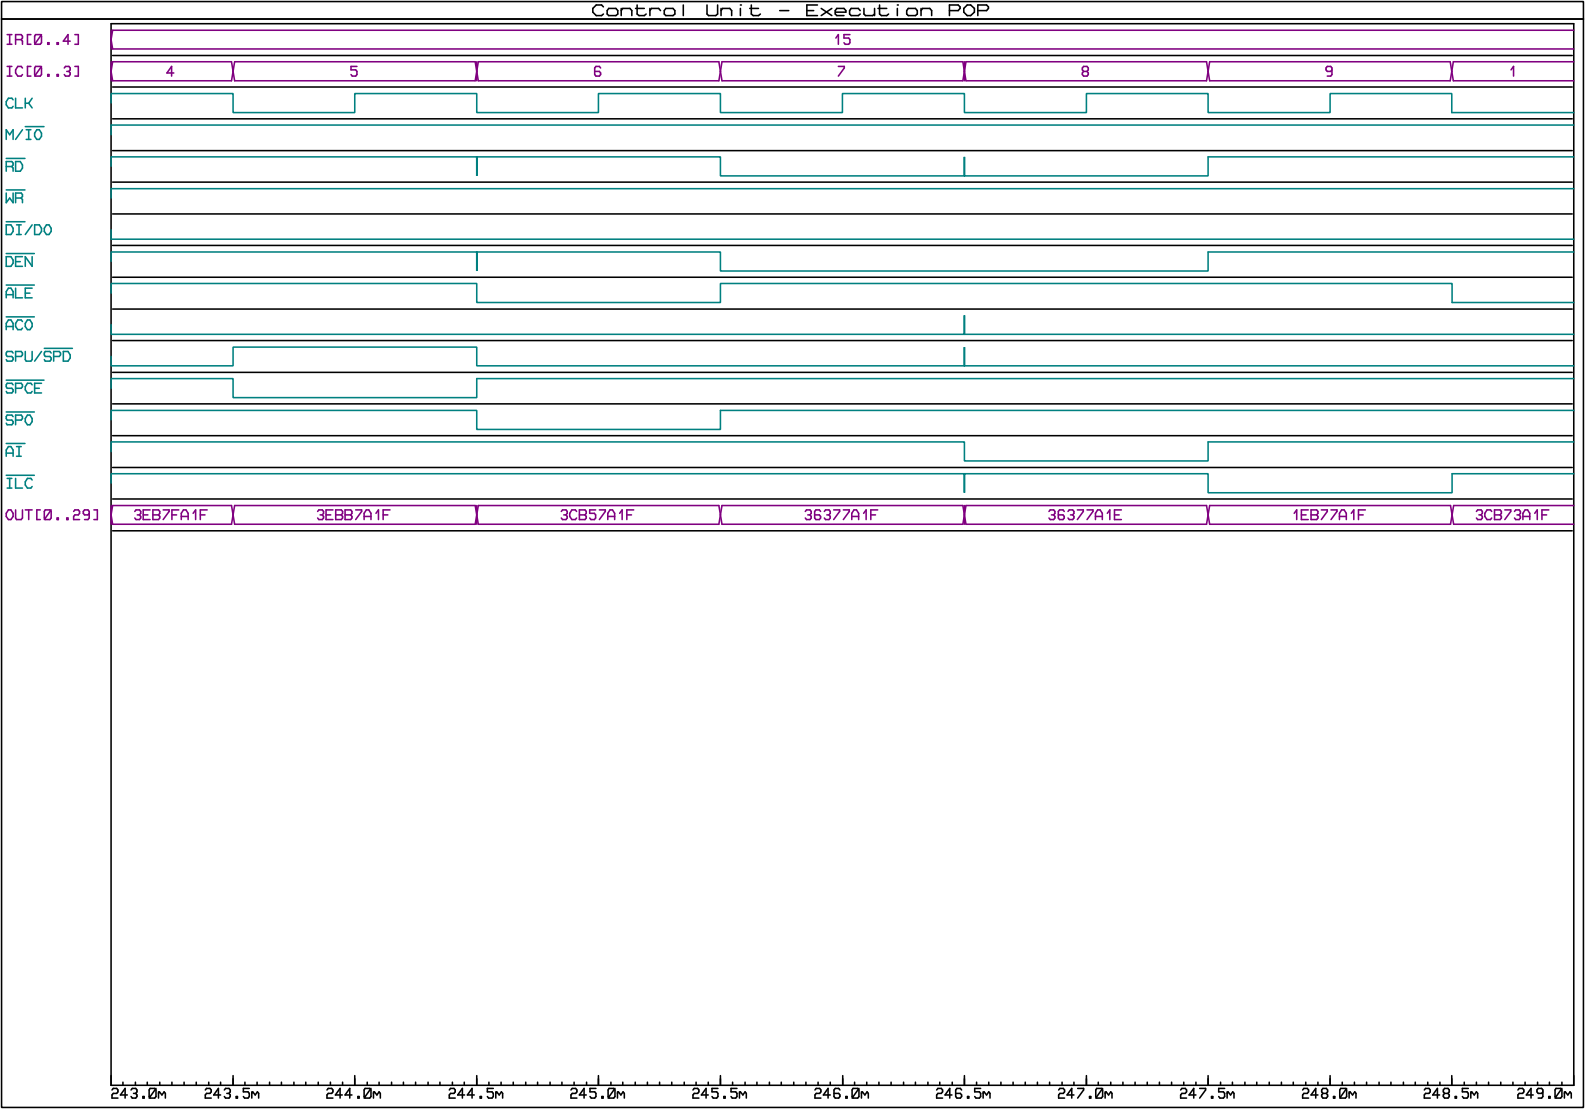
[picture p58: page 32]

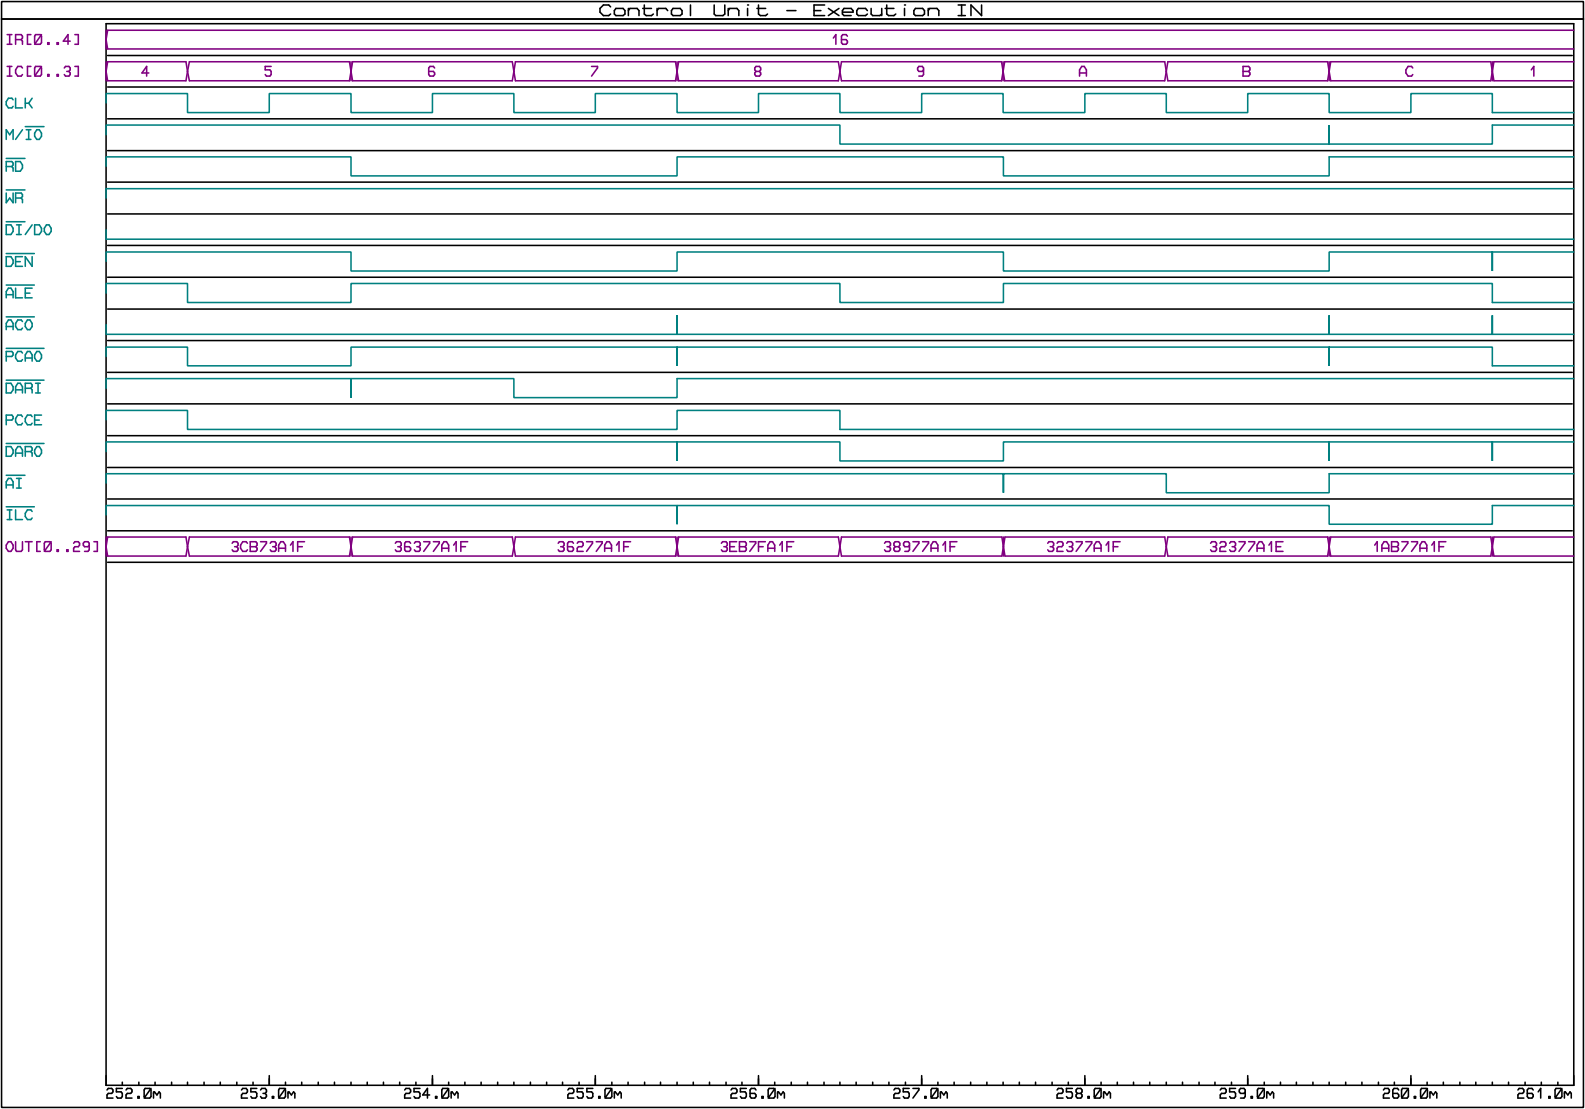
[picture p59: page 33]

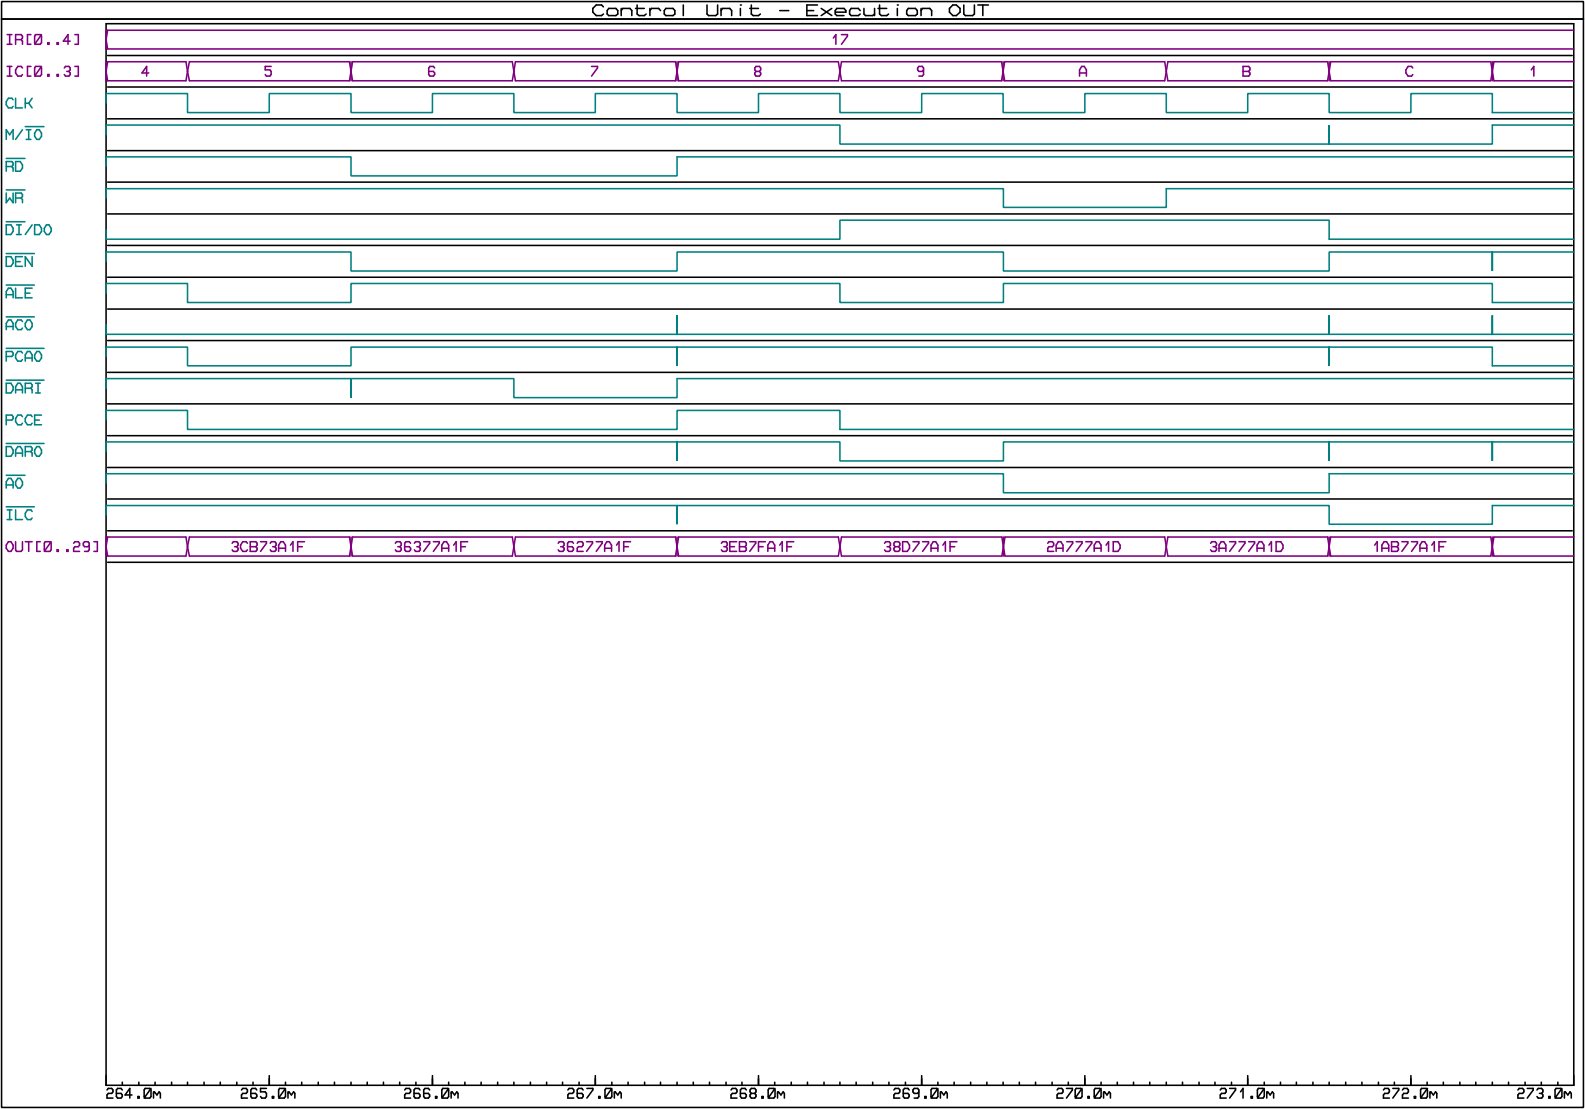
[picture p60: page 34]

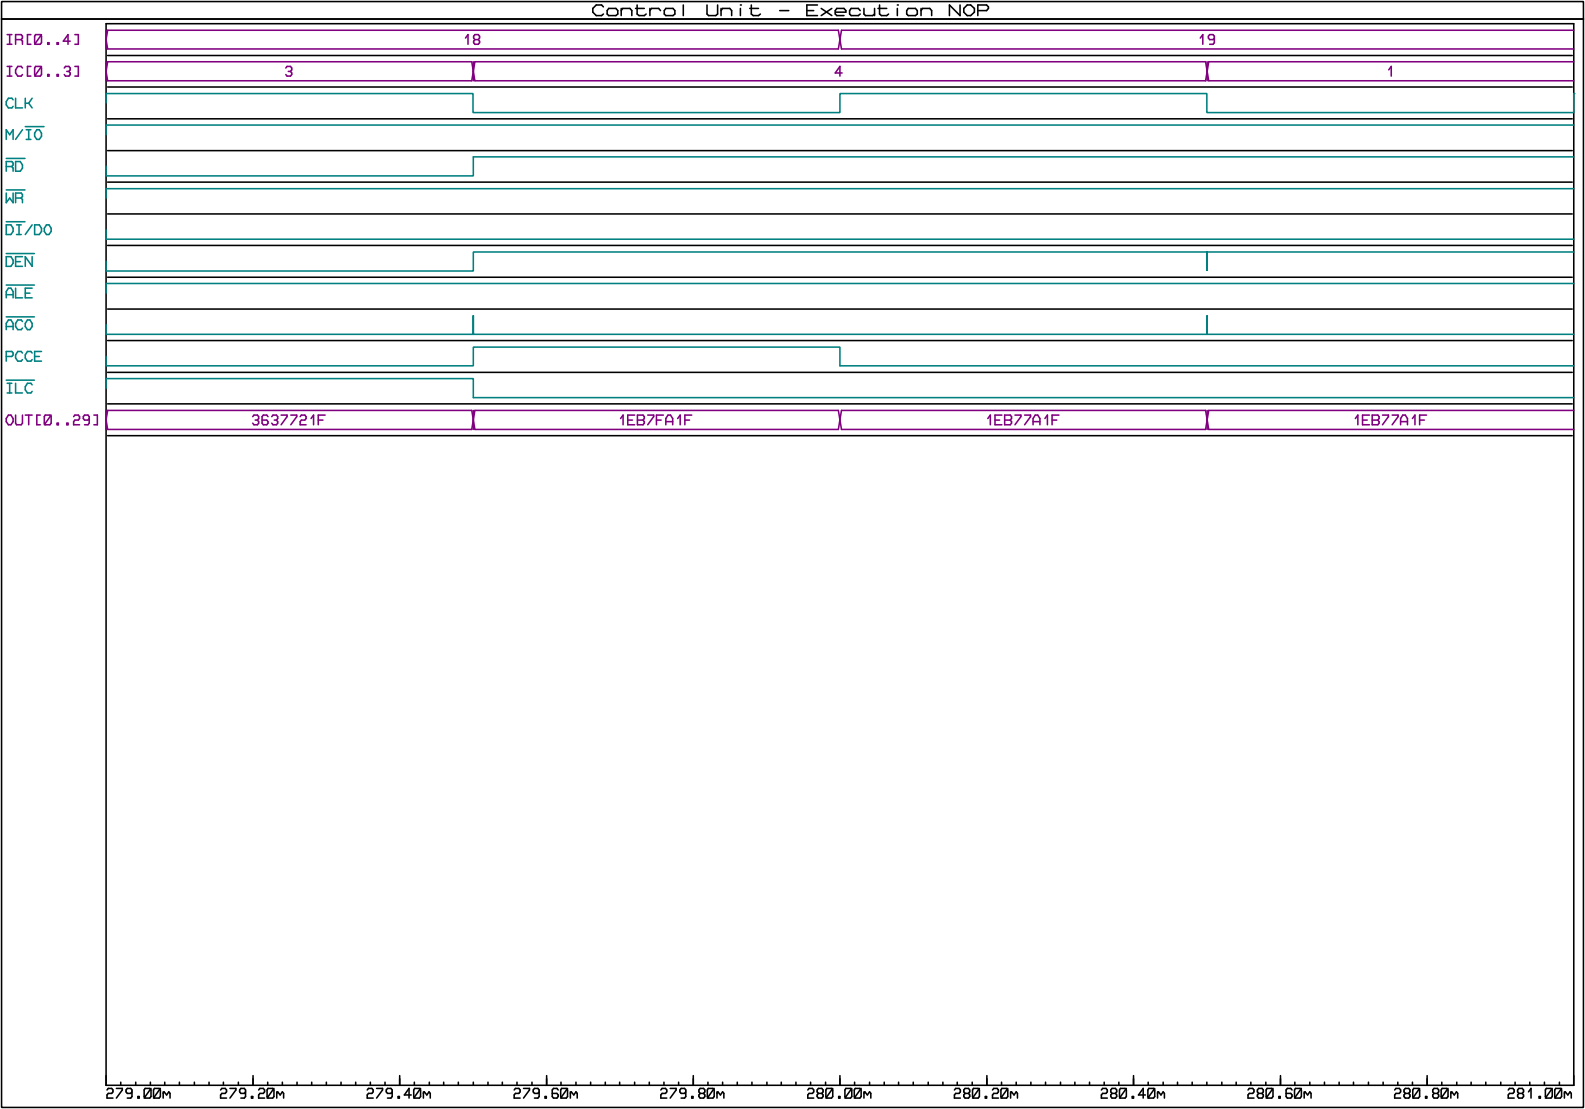
[picture p61: page 35]

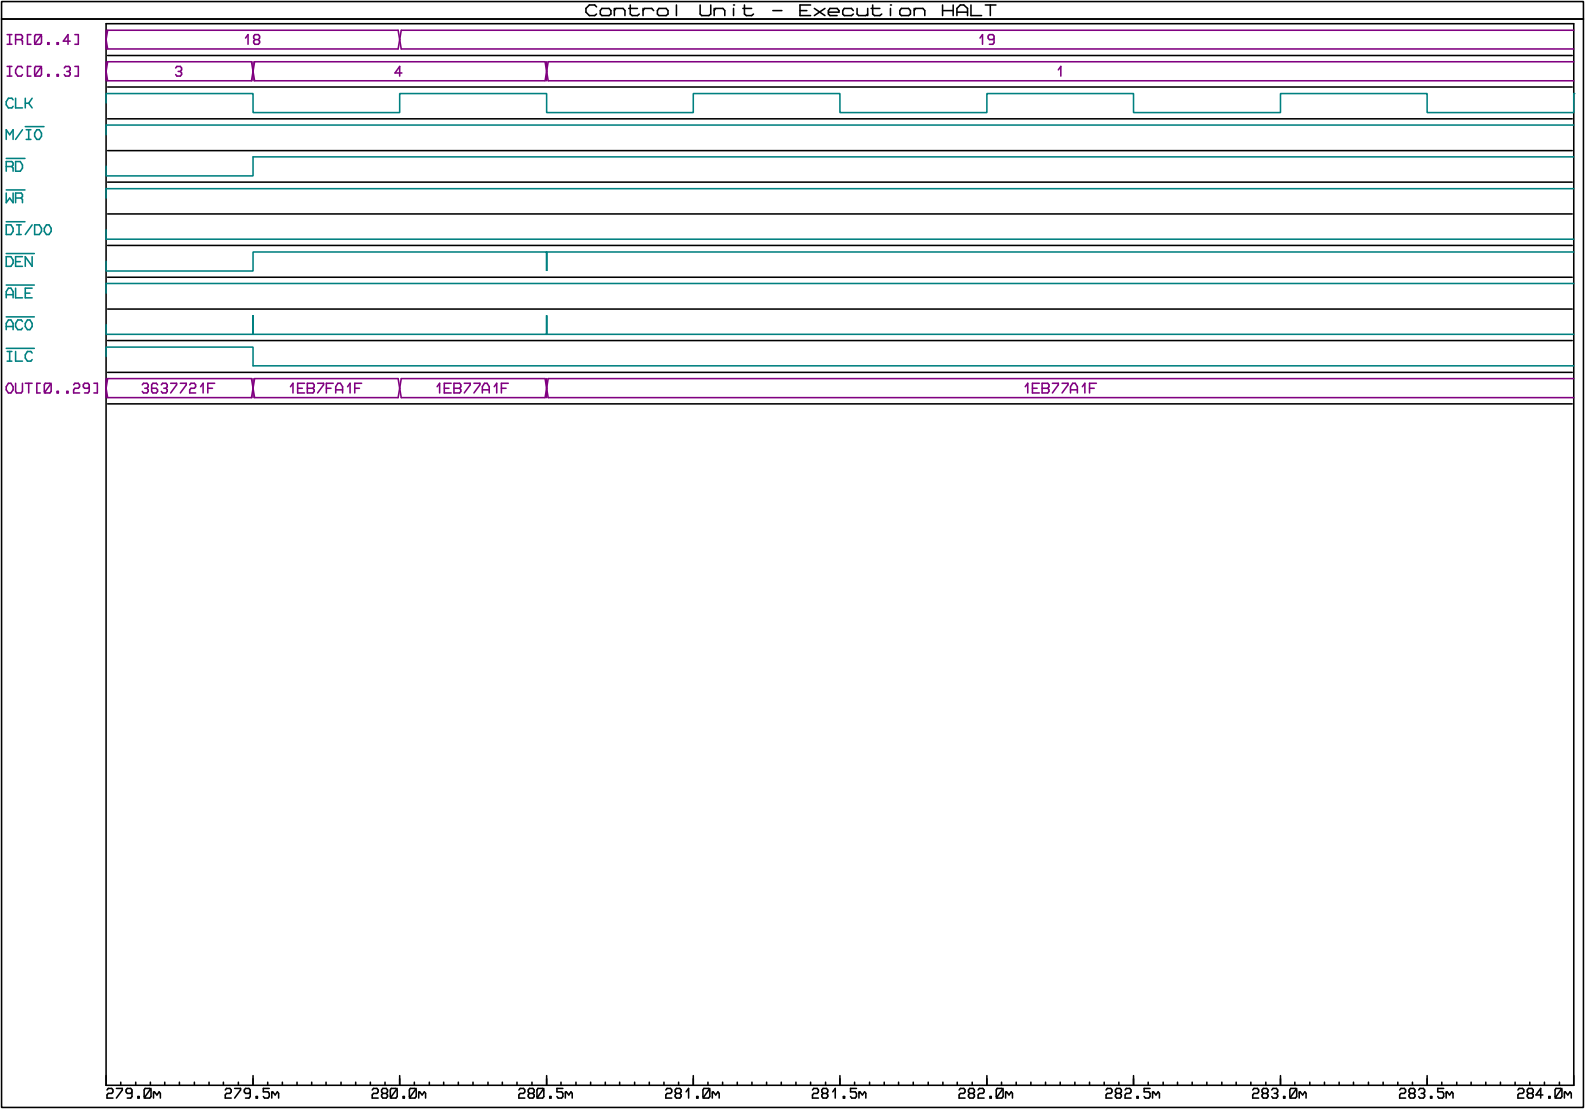
[picture p62: page 36]
