LucasJadilo/ez8-hardware/docs/EZ8_CPU.pdf

# ROOT

# BIU

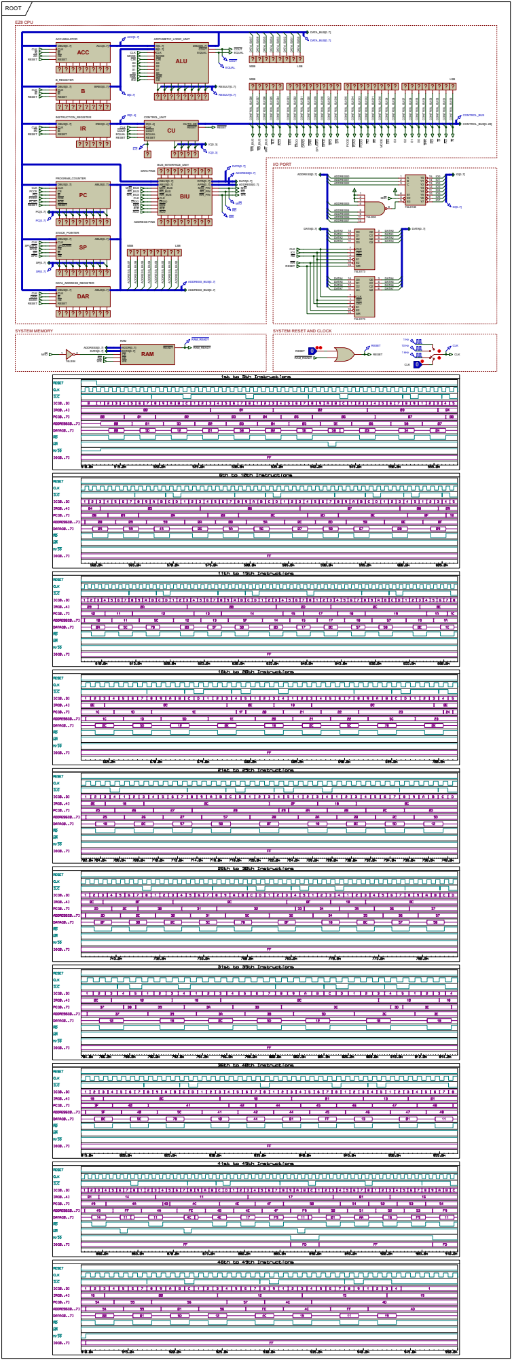
[picture p63: page 1]

EQUAL COUT CLK RESET

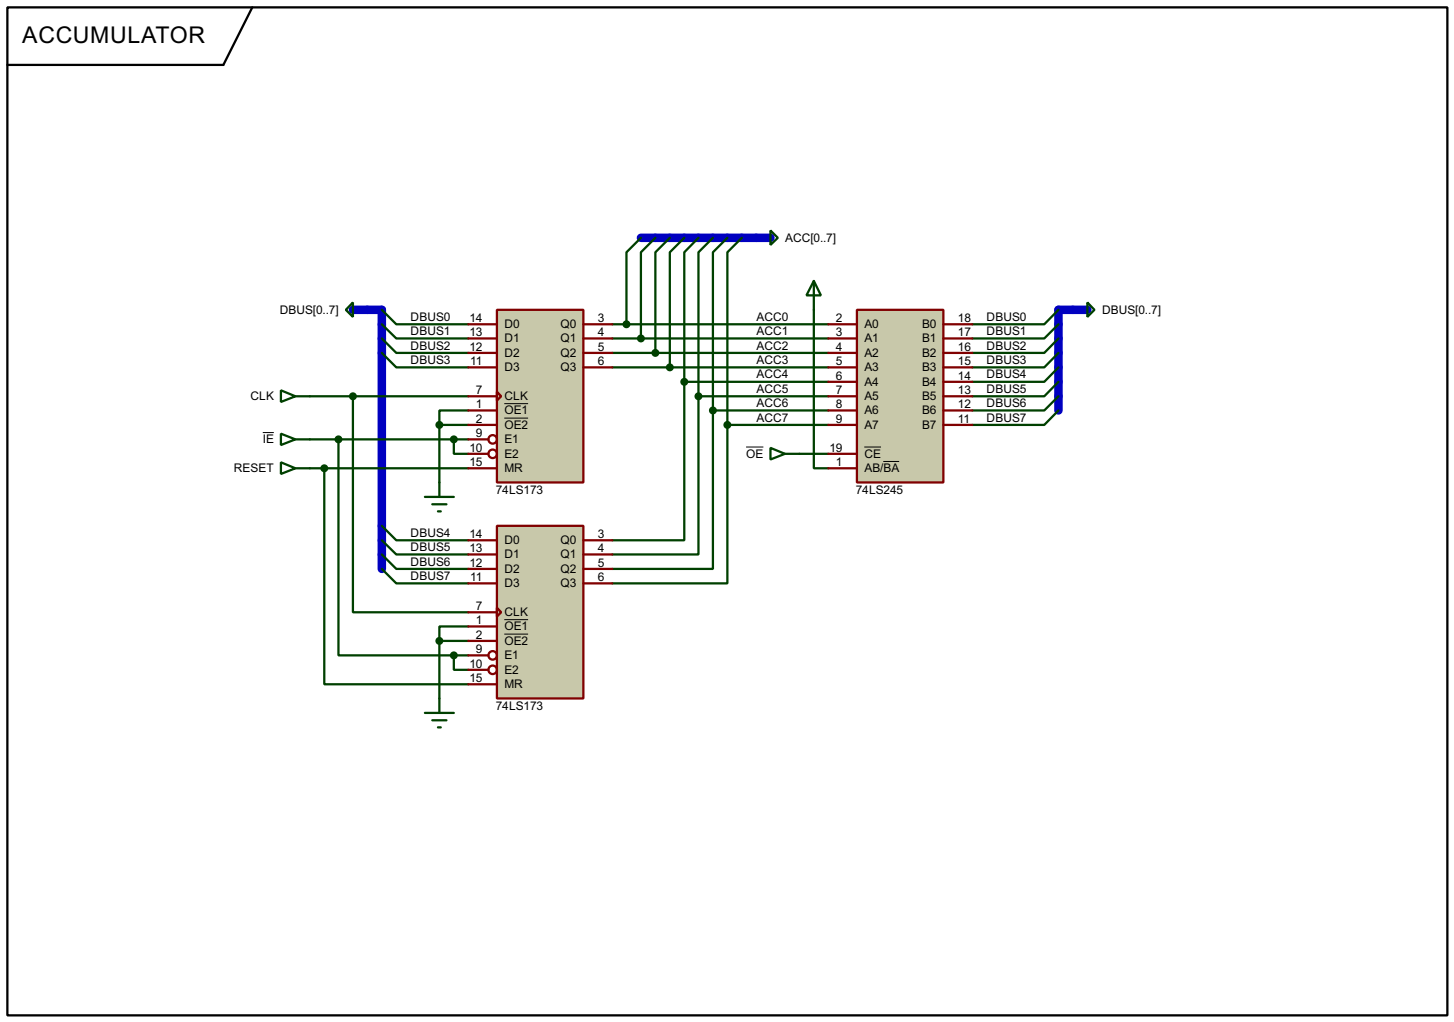
[picture p64: page 2]

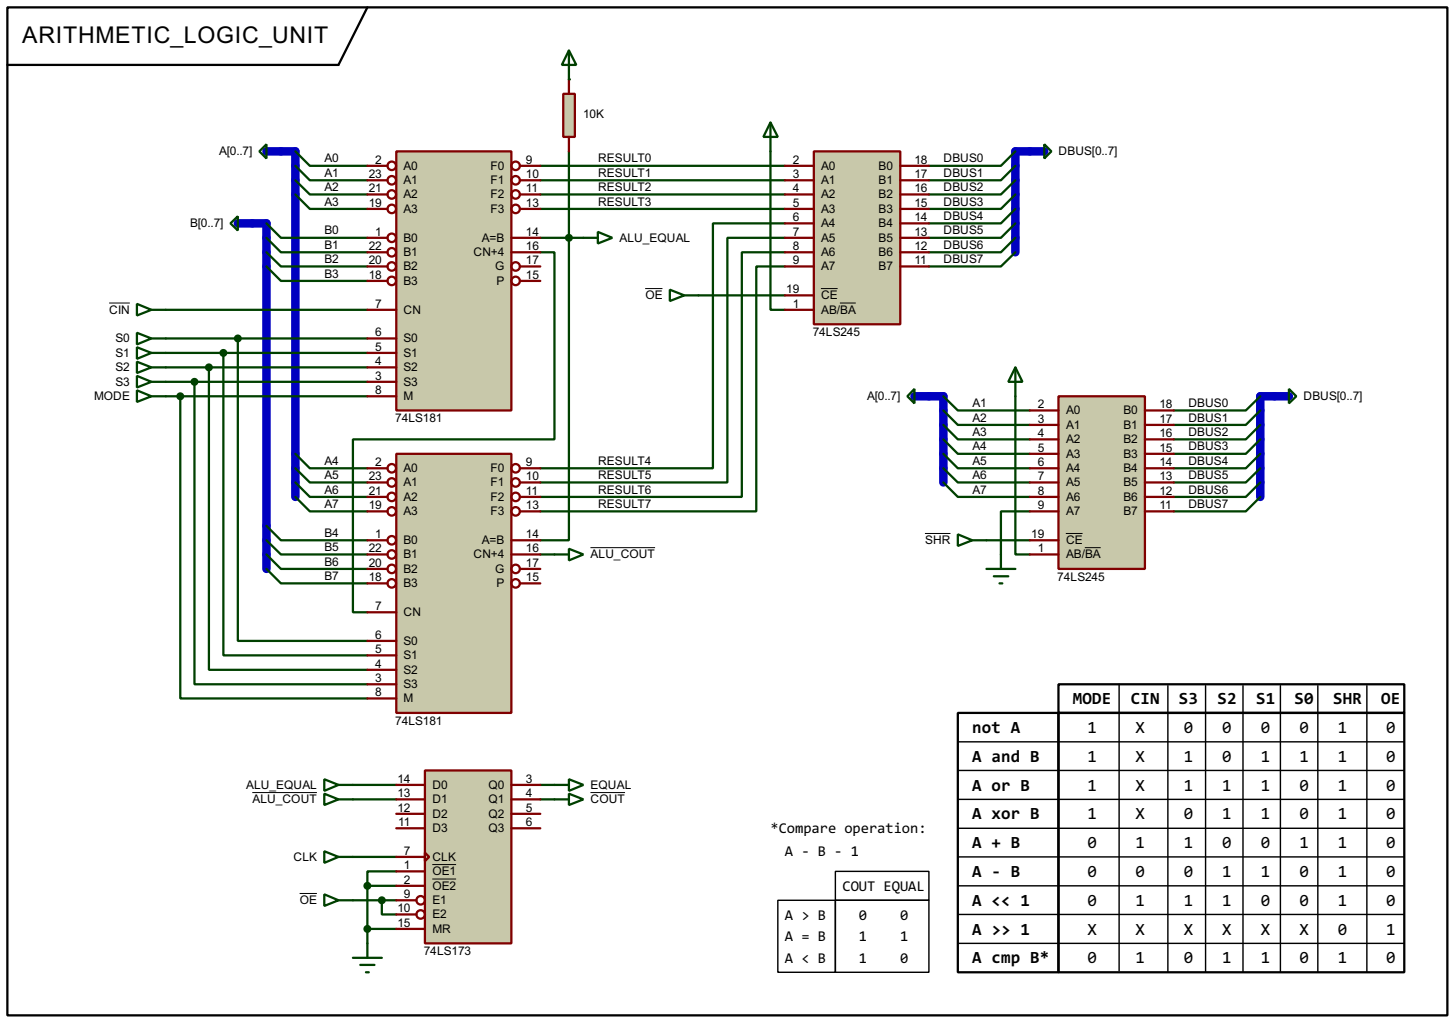
[picture p65: page 3]

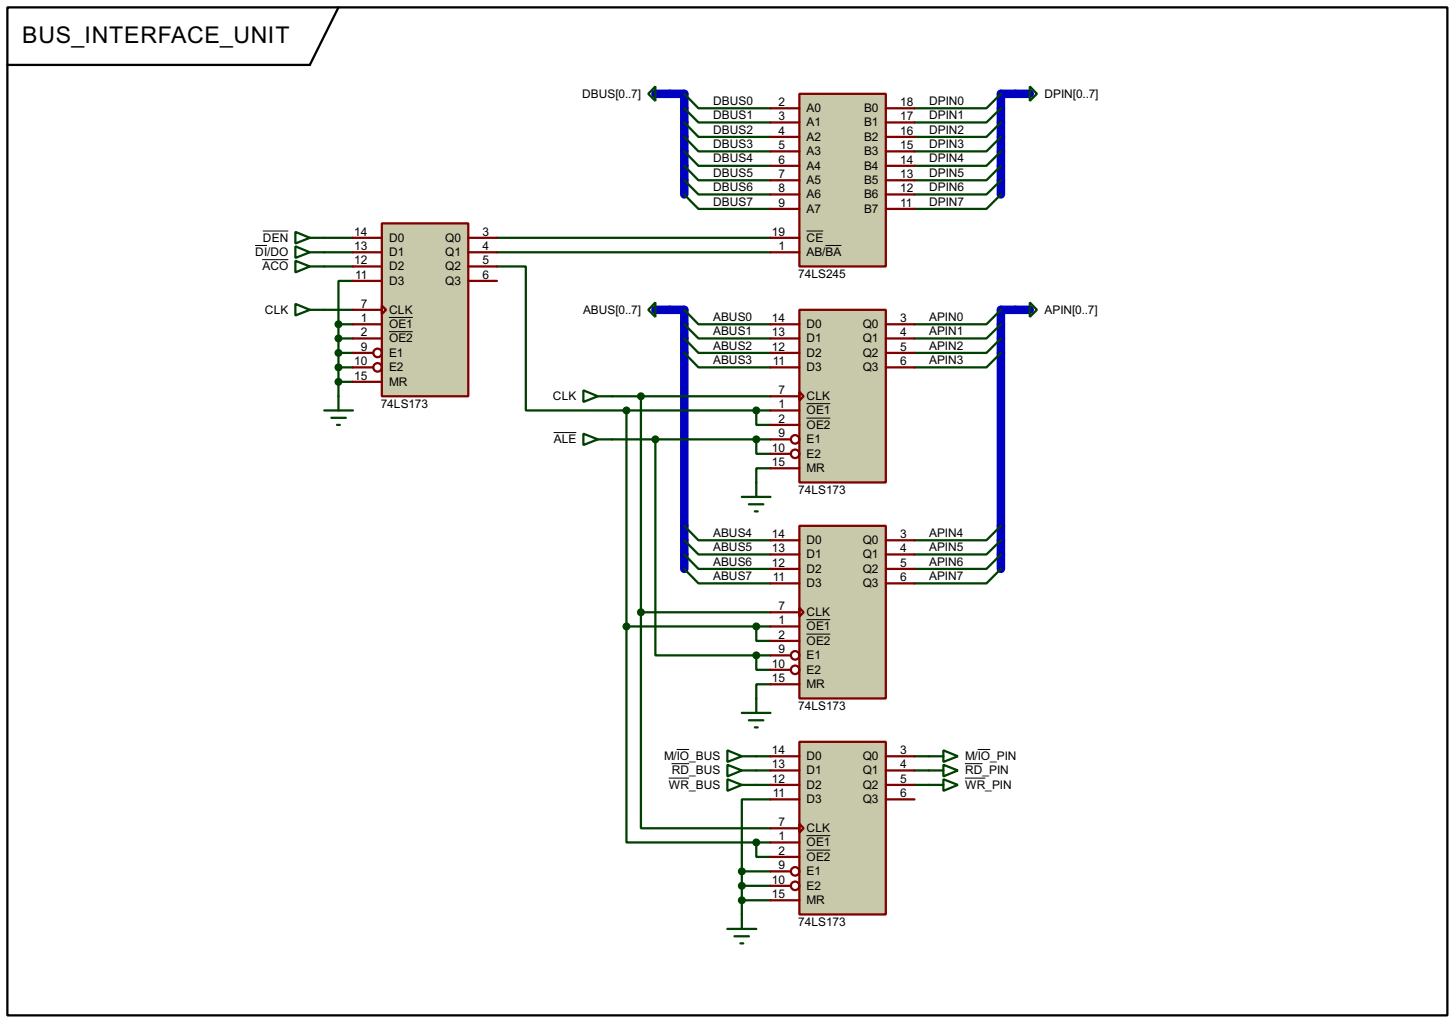
[picture p66: page 4]


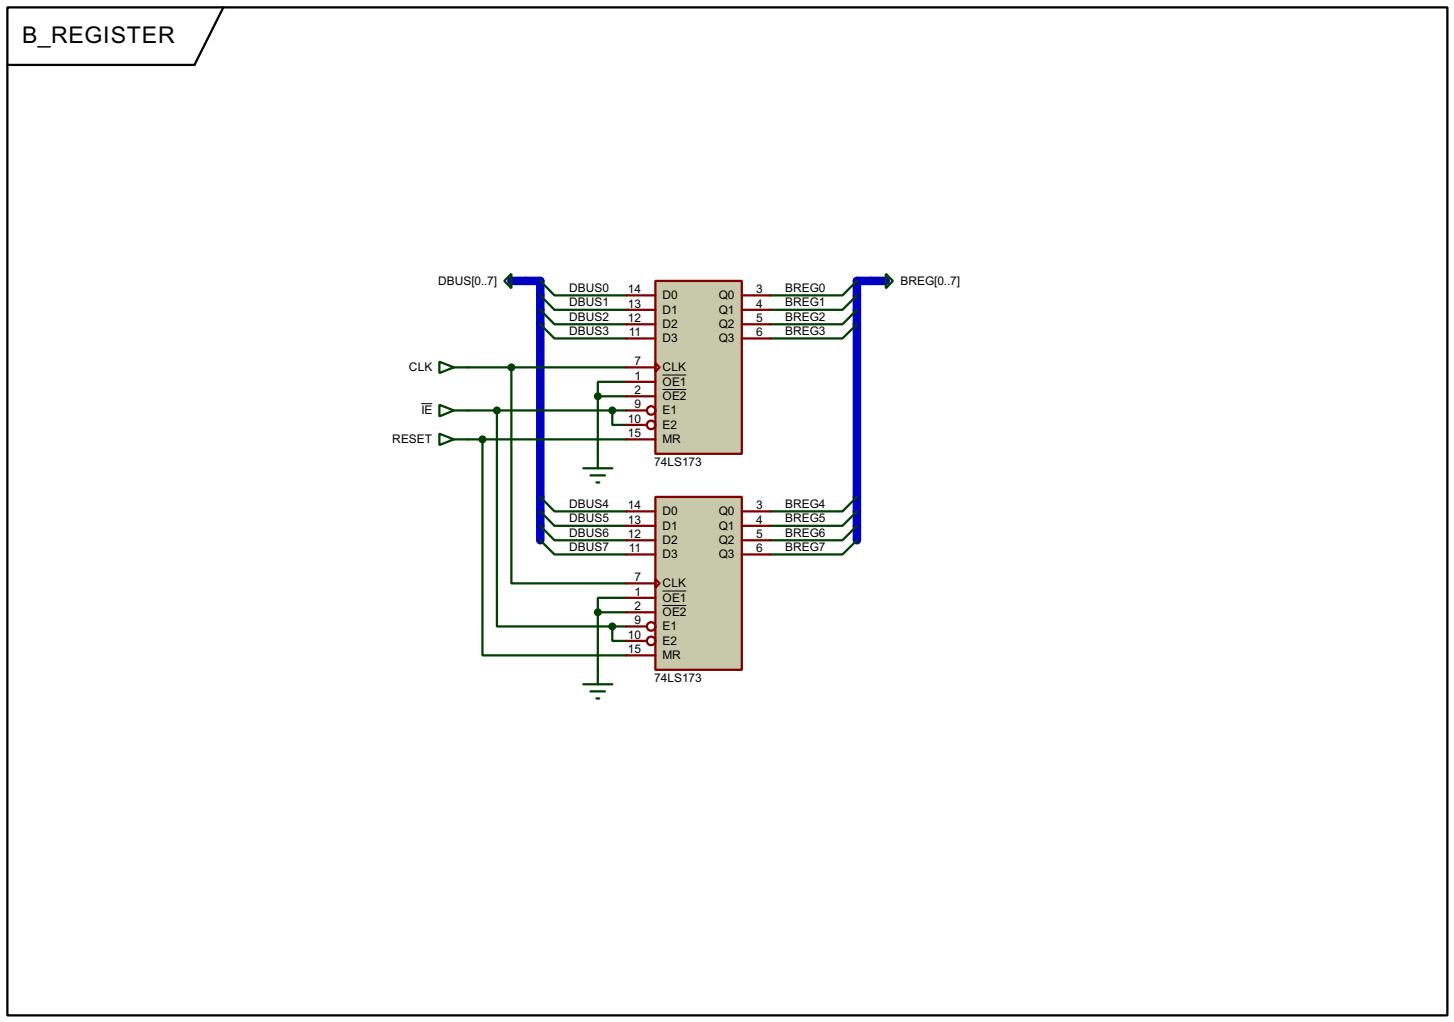
[picture p67: page 6]

# DATA_ADDRESS_REGISTER

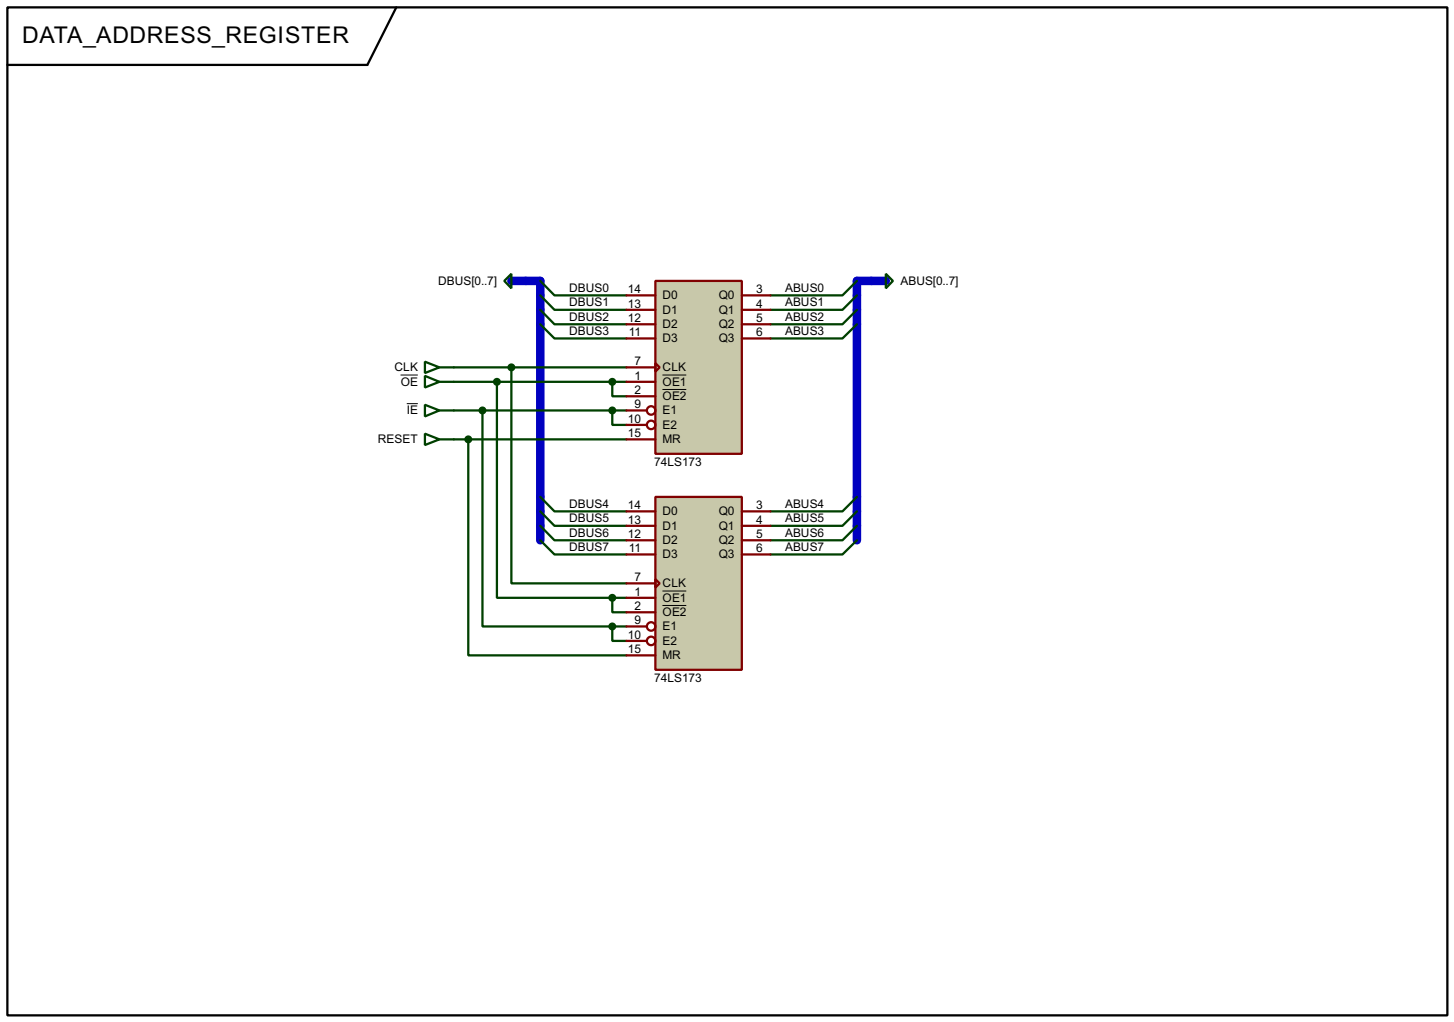
[picture p68: page 7]

# INSTRUCTION_REGISTER

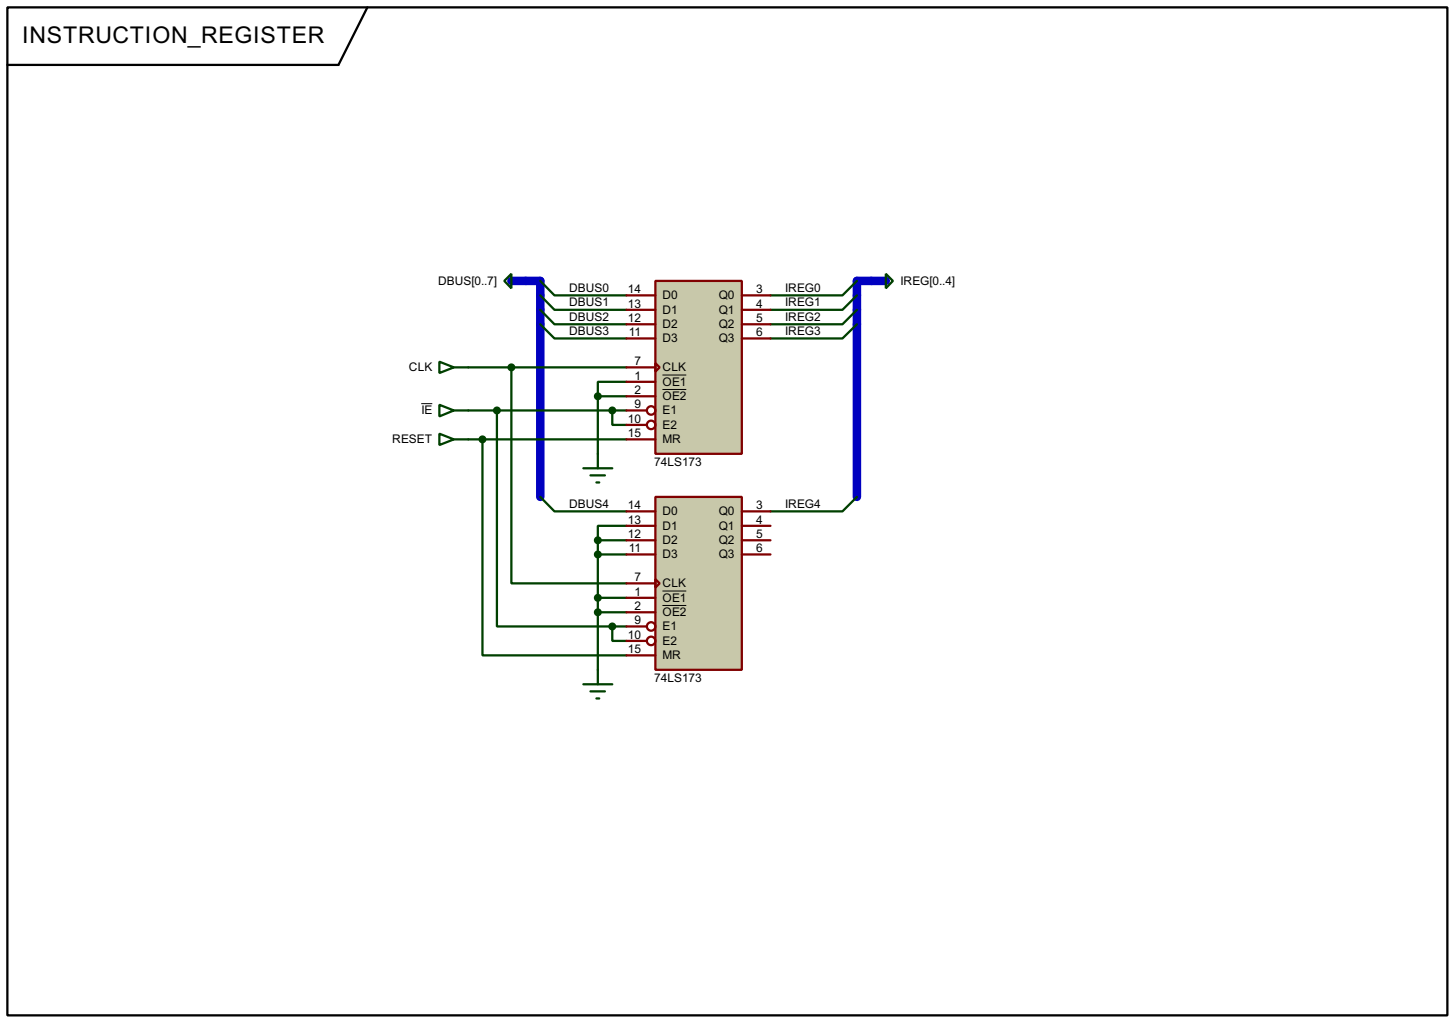
[picture p69: page 8]

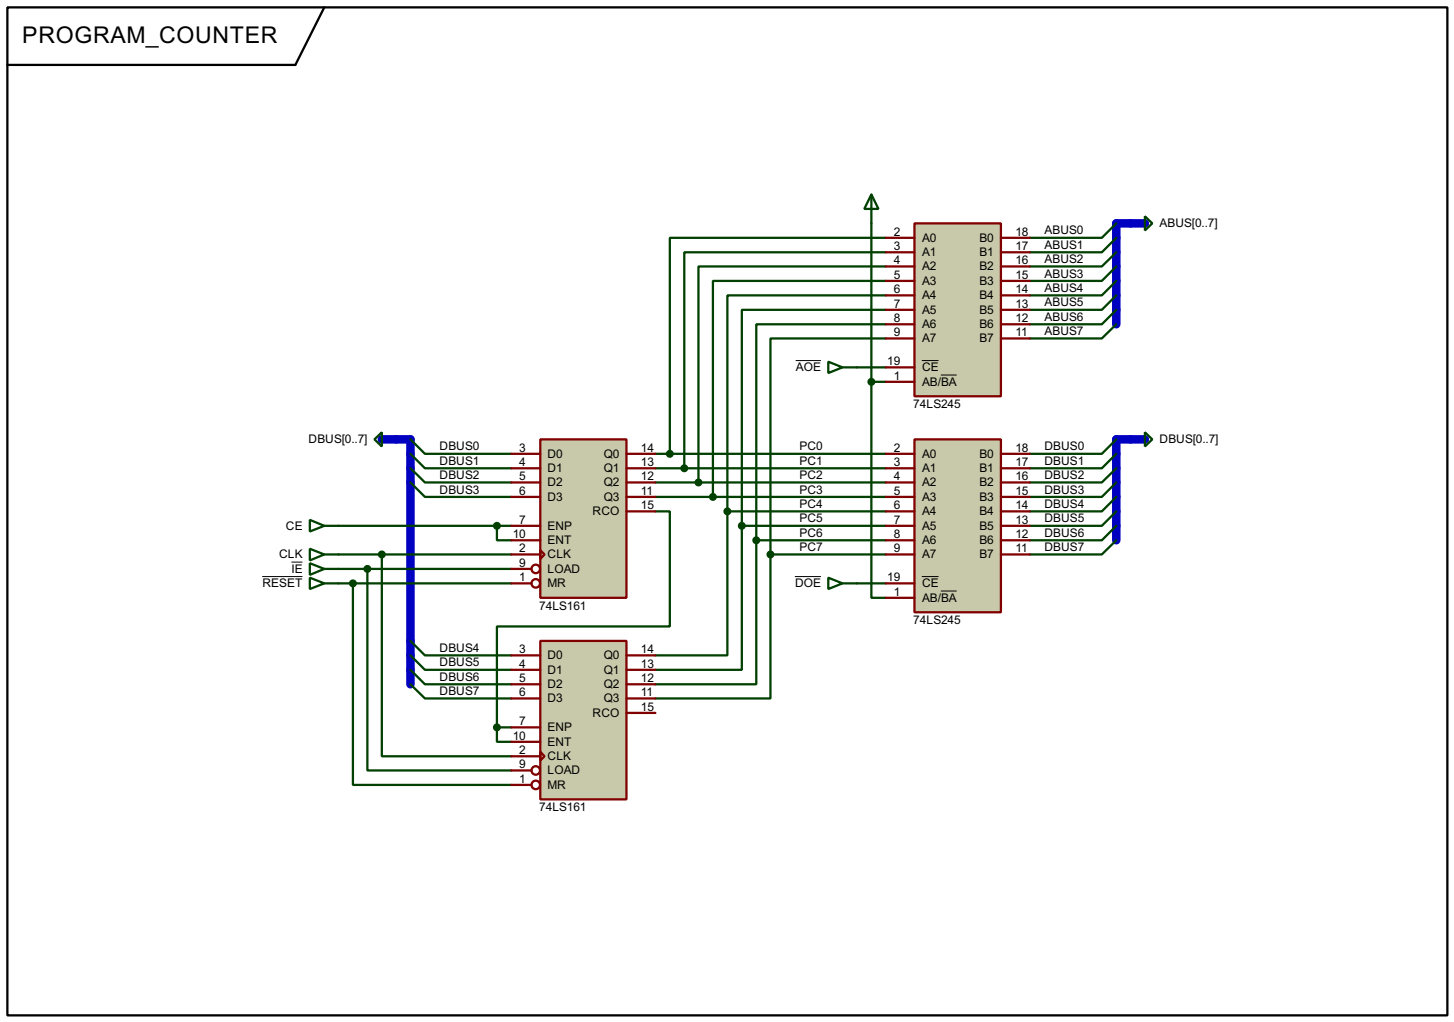
[picture p70: page 9]

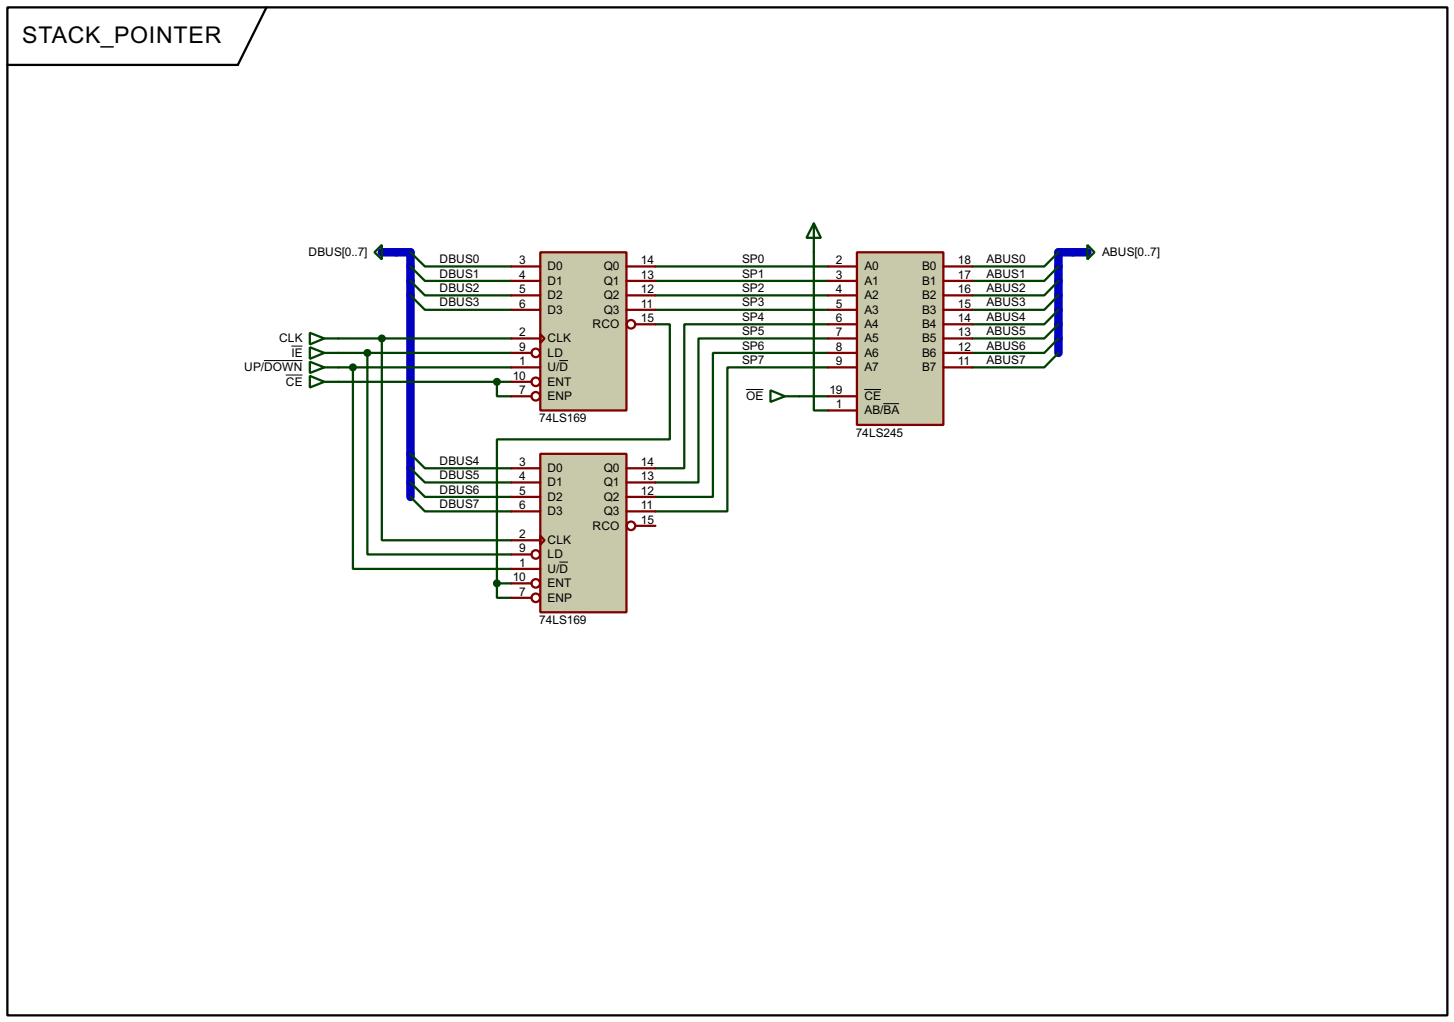
[picture p71: page 10]
