LucasJadilo/ez8-hardware/docs/EZ8_System.pdf

EZ8

# ROOT

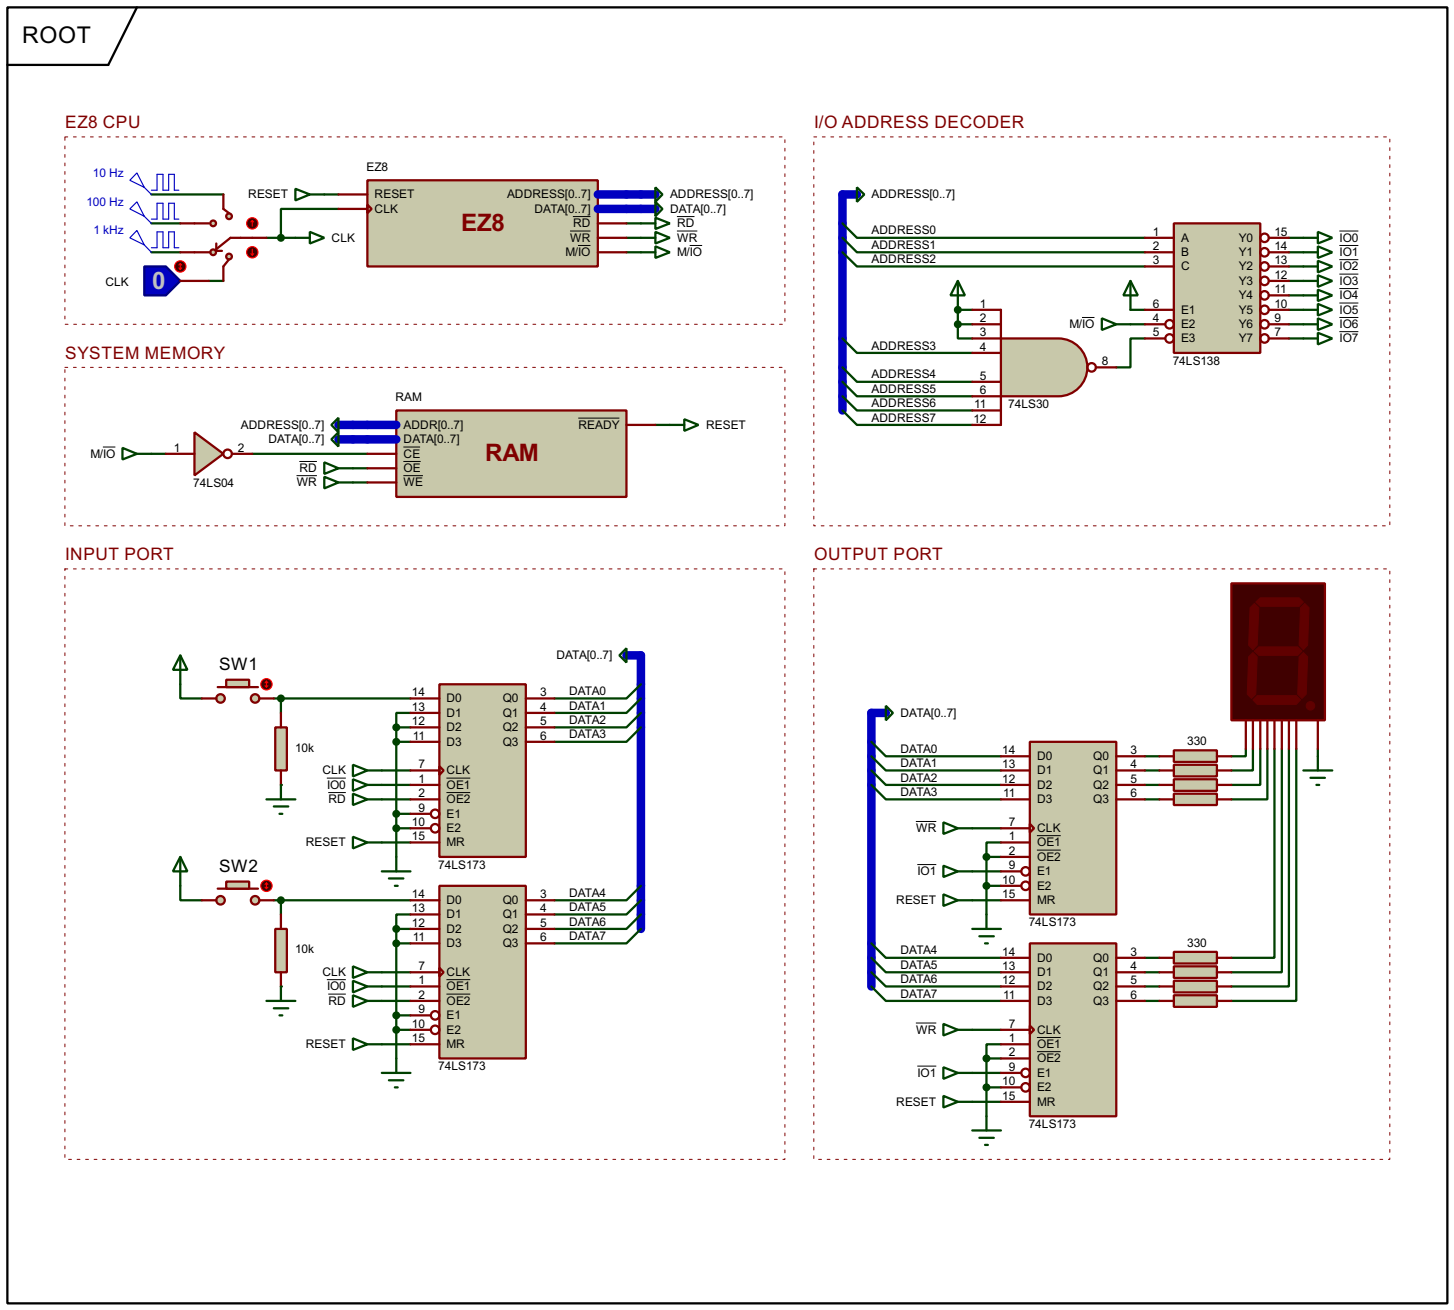
[picture p72: page 1]

ADDRESS[0..7] DATA[0..7] RDWR M/IO

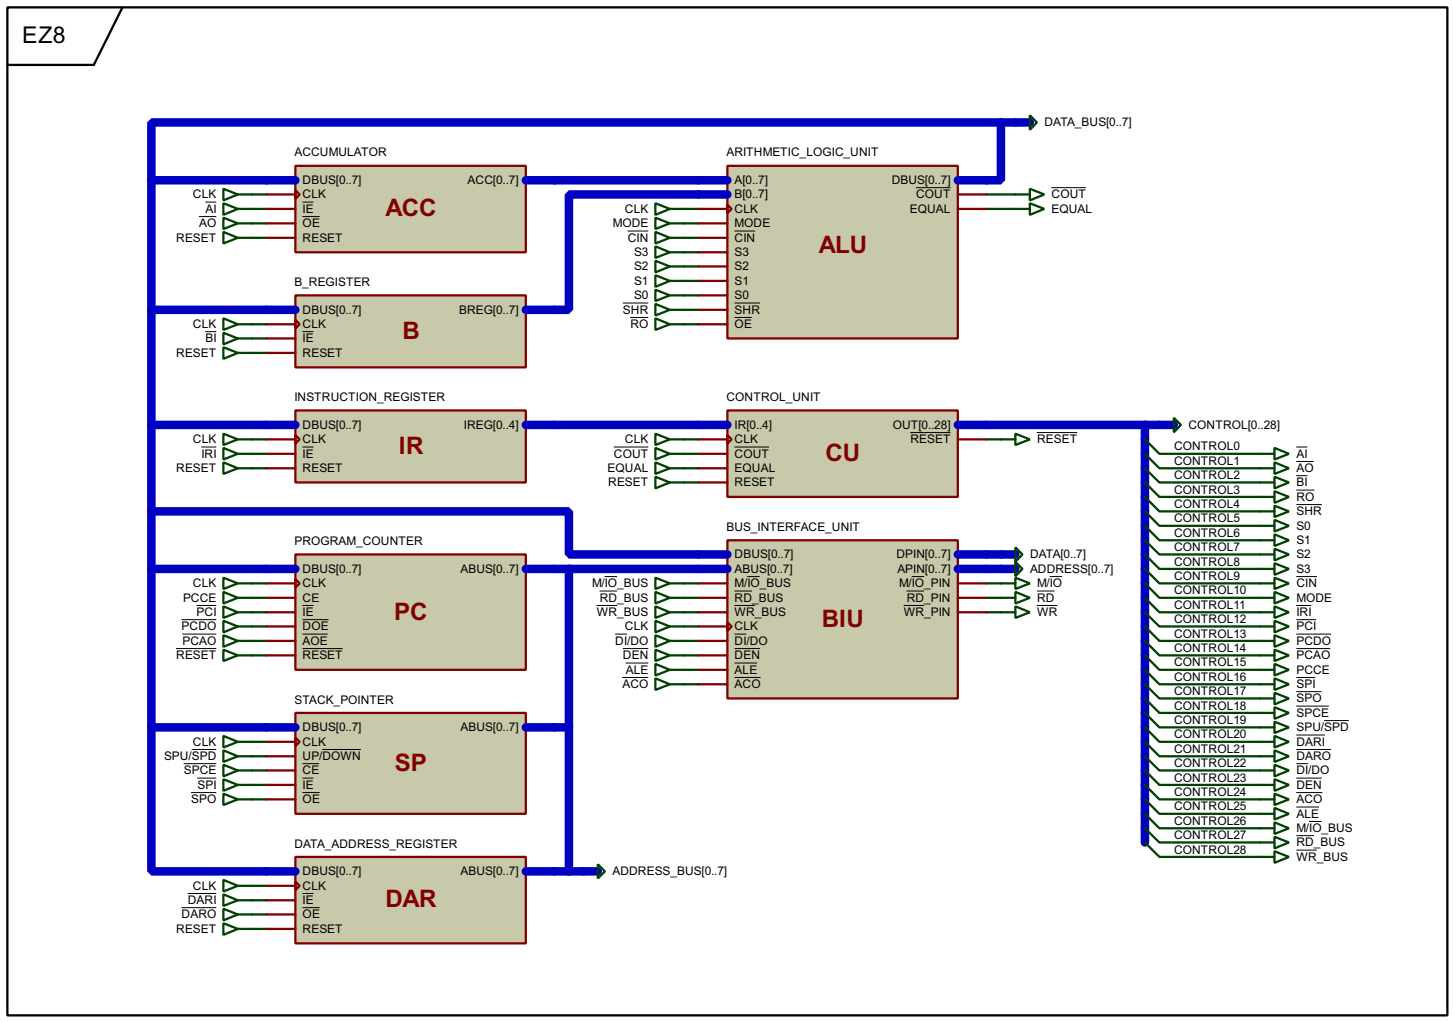
[picture p73: page 2]
CONTROL28 CONTROL27 CONTROL26 CONTROL25 CONTROL24 CONTROL23 CONTROL22 CONTROL21 CONTROL20 CONTROL19 CONTROL18 CONTROL17 CONTROL16 CONTROL15 CONTROL14 CONTROL13 CONTROL12 CONTROL11 CONTROL10 CONTROL9 CONTROL8 CONTROL7 CONTROL6 CONTROL5 CONTROL4 CONTROL3 CONTROL2 CONTROL1 CONTROL0 BIU; DPIN[0..7] DI/DO DEN ACO ABUS[0..7] DBUS[0..7]; APIN[0..7] ALE WR_BUS RD_BUS M/IO_BUS; WR_PIN RD_PIN M/IO_PIN CLK BUS_INTERFACE_UNIT DAR DBUS[0..7]; ABUS[0..7] OEIERESET CLK DATA_ADDRESS_REGISTER CLK CLK; CLK CLK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



# DATA_ADDRESS_REGISTER






# INSTRUCTION_REGISTER
