LucasJadilo/ez8-hardware/(list of files, drawings)

Other design files:
simulations/accumulator/EZ8_Accumulator.pdsprj
simulations/arithmetic-logic-unit/EZ8_Arithmetic_Logic_Unit.pdsprj
simulations/b-register/EZ8_B_Register.pdsprj
simulations/bus-interface-unit/EZ8_Bus_Interface_Unit.pdsprj
simulations/control-unit/EZ8_Control_Unit.pdsprj
simulations/cpu/EZ8_CPU.pdsprj
simulations/data-address-register/EZ8_Data_Address_Register.pdsprj
simulations/instruction-register/EZ8_Instruction_Register.pdsprj
simulations/program-counter/EZ8_Program_Counter.pdsprj
simulations/ram/EZ8_RAM.pdsprj
simulations/stack-pointer/EZ8_Stack_Pointer.pdsprj
simulations/system/EZ8_System.pdsprj
